LUgABeEEE/DK-Line-following-car/README.md

# DK 循迹小车

> 一台自己搭的循迹小车：STM32F103C8T6 + FreeRTOS + TB6612 + 8 路灰度，
> 串级双环（循迹 PD 外环 + 编码器速度 PID 内环），能跑弧线、直角、锐角，支持一圈自动停车。

**目录**

| | | |
|---|---|---|
| [1. 硬件构成](#1-硬件构成) | [2. 软件架构](#2-软件架构) | [3. 引脚映射](#3-引脚映射) |
| [4. 编译与烧录](#4-编译与烧录) | [5. 调试与标定流程](#5-调试与标定流程务必按顺序) | [6. N20 实测标定](#6-n20-实测标定结果6-v-额定--74-v-电池--自带编码器) |
| [7. 已知问题 / TODO](#7-已知问题--todo) | [8. 目录速查](#8-目录速查) | [分支说明](#分支说明) |
| [许可证](#许可证) | [**上手指南**](docs/上手.md) | |




> 🔧 **第一次上手？** 直接看 [**上手指南**](docs/上手.md) —— 装工具链、编译、烧录、连串口认版本、三步自检、跑一圈，30 分钟走完。

---

## 1. 硬件构成

| 项目 | 型号 / 规格 | 说明 |
|---|---|---|
| 主控 | STM32F103C8T6 | 72 MHz，64 KB Flash / 20 KB RAM，HSE 8 MHz |
| 底板 | 小车控制底板 V1.0（嘉立创 EDA） | 原理图见 [`docs/小车控制底板V1.0-原理图.pdf`](docs/小车控制底板V1.0-原理图.pdf) |
| 电机驱动 | TB6612FNG 双路 H 桥模块 | 底板 `M-INPUT` 7P 接口直插 |
| 电机 | N20 减速电机（**6 V 额定**）+ 霍尔编码器 | 实测轮径 48 mm、约 1300 计数/轮转（PSC=0）；2S 7.4 V 供电，占空比 100 % ≈ 7.4 V（超压 23 %），见第 6 节 |
| 循迹传感器 | 8 路灰度，I2C 地址 `0x5D` | 实测探头中心间距 11.5 mm（8 路总跨距 80.5 mm），I2C1 400 kHz |
| 显示 | 0.96" OLED（SSD1306，128×64） | I2C2，400 kHz |
| 无线 | **JDY-31**（经典蓝牙 3.0 SPP）或 HC-05 | USART2，9600 8N1；6 针底板：STATE/RXD/TXD/GND/VCC/EN(空)，底板 3.6~6V 供电 |
| 姿态 | MPU6050 六轴 | I2C2，与 OLED 共总线；**AD0 接 VCC → 7 位地址 0x69**（驱动自动探测 0x68/0x69），X 朝前、Z 竖直 |
| 电源 | 2S 7.4 V 锂电 + 2S 保护板 | DCDC 7.4→5 V（LMR14030）→ LDO 5→3.3 V（TLV75733） |

> ⚠️ **USB 供电时禁止接电机**：Q1 体二极管会把 VBAT 反灌到 5 V 轨，可能损坏 USB 口/电脑。调试逻辑先拔电机。

> **蓝牙模块（2026-10-27 换新 HC-05，资料见 `HC-05.zip`）**
>
> - 模块供电 **3.3 V**（规格书 3.0~3.6 V）。底板蓝牙接口出的是 **+5 V**：
>   带 LDO 的转接板能直接用；裸模块必须接 3.3 V，**别直接上 5 V**；
> - AT 模式：**上电、未配对时就是 AT 模式（9600）**；若上电瞬间 KEY 为高则固定 38400。
>   所以固件可以在上电时直接配参数，不用手动按 KEY；
> - 固件上电自动握手 9600/38400，成功后配置：**从机 + 广播名 `LFCar` + 配对码 `1234`**
>   （`BLE_AutoConfig()`，`Ble.h` 的 `BLE_AUTOCONFIG_ON_BOOT` 可关）；
> - `AT+UART` 改波特率后**必须重新上电**才生效，固件不动它。
>
> **JDY-31（经典 SPP，构建 `aq` 起）**
>
> - 未连接时就是 AT 模式，命令以 `\r\n` 结尾：`AT+VERSION` / `AT+NAME<名>` /
>   `AT+PIN<4位>` / `AT+BAUD<4..9>` / `AT+ENLOG<0|1>` / `AT+RESET` / `AT+DISC`；
> - 出厂：9600、名 JDY-31-SPP、PIN 1234；底板 EN 引脚为空，STATE 在连接后为高；
> - 固件上电自动识别 JDY-31/HC-05（`AT+VERSION` 含 JDY-31 即判定），
>   识别为 JDY-31 时自动设置 `AT+NAMELFCar`、`AT+PIN1234`、`AT+ENLOG0`；
> - 它是**经典蓝牙 SPP**，电脑端要用 RFCOMM 配对（PIN 1234），不能用 BLE GATT。

---

## 2. 软件架构

```
Core/            CubeMX 生成（时钟、GPIO、I2C、TIM、UART、USB；I2C1 400 kHz + DMA 收）
Drivers/BSD/     板级驱动（手写）
  PWM.c          TB6612 方向 + PWM（含每轮方向系数）
  Encoder.c      正交编码器测速（20 ms 窗口 + 一阶低通 + 分轮修正）
  SpeedPID.c     内环：前馈 + PID（cm/s → 占空比）
  Gray.c         8 路灰度读取、加权质心位置解算、场景识别
  LinePD.c       外环：循迹 PD + 直角/分叉/全黑处理 + 丢线搜索
  Led/Key/Ble/Oled.c  外设驱动
USER/            FreeRTOS 任务层
  Control_task.c 实时控制任务（优先级 3）：20 ms 内环 / 40 ms 外环 / 20 ms HMI，含目标速度斜坡
  Ble_task.c     蓝牙任务（优先级 2）：急停命令 + 灰度/PID 遥测
  Oled_task.c    OLED 显示任务（优先级 1）：状态页与按键调参
FreeRTOS/       内核（Cortex-M3 端口，heap_4）
```

控制链路：

```
灰度场景+位置 ──► 外环 PD(40 ms) ──目标速度 cm/s──► 内环速度 PID(20 ms) ──占空比──► TB6612 ──► N20
   ▲                                                                                    │
   └────────────────────── 编码器测速 ◄────────────────────────────────────────────────┘
```

设计要点：

- 内环带**前馈** `duty = KFF × v_target`，PID 只修小偏差；没有前馈时直道输出全靠积分攒，必然饱和、一转弯就失控。
- 内环在**目标速度符号翻转**的那一拍清零积分。否则前进时攒下的正积分会把反转指令抵消掉，
  "原地右转"实际变成"左轮前进、右轮不动"，车只会平移；实车日志里 B 轮
  被要求 -24 cm/s 时实际只有 -3 cm/s，根源就是积分还背着 +22。
- 外环**刻意不含积分**：线本身就是绝对位置基准，不存在需要积分消除的静差。
- 外环周期必须是内环的 2 倍以上（现为 40 ms vs 20 ms），`LinePD_Update()` 内部会检查周期比，不满足直接拒绝运行。

已实现的赛道能力：

- **场景识别与防抖**（`Gray.c`）：正常单线 / 横向线或终点（全黑）/ 左直角 / 右直角 / 分叉 / 丢线，输出防抖后的 `scene` 供外环切换策略；直角与锐角的判断冲突处理见 2.1。
- **丢线搜索**（`LinePD.c`）：锁存最后偏离方向，超时（1.2 s）后双向扫描找回，搜索速度 24 cm/s。
- **目标速度斜坡**：内环 40 cm/s²、外环 50 cm/s²，避免起步时两轮不同步造成原地打转。
- **分轮标定**：`ENCODER_A_FIX / B_FIX` 修正两轮计数差异（解决直行跑偏），支持运行时调。
- **蓝牙遥测**：`X/S/Q` 急停、`I` 扫 I2C 总线，周期输出灰度 8 路模拟值/阈值与内环 PID 三列。

### 2.1 直角 / 锐角判断冲突是怎么解决的

8 路灰度只有"某一帧的通道分布"这一种信息，而 SIDE（半侧宽黑带）和
FORK（两簇）**不是互斥的物理类别**：车走到锐角弯顶点附近时，同一条黑线会
先被探头切成两段（FORK），再随车头前压并成一片（SIDE），偶尔还会全亮（ALL）。
如果逐帧直接分类，`scene` 就会在 SIDE 和 FORK 之间来回跳 ——
表现为"一会儿按直角处理、一会儿按锐角处理"，转向和搜索方向跟着乱翻。

现在分三层处理：

1. **传感器层（`Gray.c`）**
   - 相邻簇间隔 ≤ 1 路时合并成一簇：一条线中间偶尔断一路，不再被误判成分叉。
   - 两级时间防抖：先确认"场景族"（丢线 / 单线 / 角点），再确认角点内部的子类型。
     族确认 2 帧（40 ms）、角点→单线释放 3 帧（60 ms）、丢线立即生效。
     关键点：**角点的进入只看"是不是角点"**，所以 SIDE / FORK 交替出现时
     也能在 2 帧内确认进入；而子类型要连续 3 帧相同才更新，
     交替抖动时 `sc` 保持不变。
2. **决策层（`LinePD.c`）**
   - SIDE 和 FORK 统一成**角点事件**：事件一旦成立就锁存方向
     （SIDE 用"哪半边全黑"，FORK 用"另一条腿在哪一侧"），
     之后无论分类怎么变都不重算；连续 3 拍（120 ms）回到单线才释放。
   - 方向证据**分级**：SIDE 是最直接的观测（哪半边全黑 = 往哪边转），
     可以纠正之前由 FORK 得到的方向；反过来不行。
     实车日志里出现过 `SIDE_L` 却锁存 `cd=-1` 的情况（先来了一帧 FORK 把方向占住），
     导致丢线后往反方向搜索 4~6 秒，就是靠这条规则修掉的。
   - **出弯方向记忆**：角点事件释放后 `corner_dir` 不立刻清空，再保留 15 拍（600 ms）。
     实车锐角弯常见时序是「SIDE/FORK → 短暂 LINE → 立刻丢线」，
     如果方向在丢线前就被清掉，搜索只能退回默认方向盲扫。
   - **锐角弯"定角转弯"**：如果角点事件里出现过锐角证据（FORK 双簇 / ALL 全黑），
     丢线后先闭眼朝锁存方向**转到目标角度**（`LINE_ACUTE_TURN_DEG`，默认 115°），
     这段时间看到线也不认。原因：V 形顶点处探头扫过"刚走过的那条腿"只有几十毫秒，
     按 2 拍确认就会误判"找回来了"，然后顺着旧线往回跑。
   - **角度从哪来**：没有陀螺仪，用两个编码器做差分里程计
     `yaw += (v_right − v_left) / 轮距 × dt`（dt 用 `HAL_GetTick` 的真实间隔）。
     纯原地转时约 172°/s，115° 约 0.67 s。打滑时轮子转得比车身多，编码器算出的角度会偏大、物理转角偏小，所以另设
     `LINE_ACUTE_COMMIT_TIMEOUT_MS`（1.5 s）兜底，不会无限转。
     等 MPU6050 到货，只需把 `yaw` 的来源换成陀螺仪 Z 轴积分，上层逻辑不变。
   - **直角弯（90°）单独处理**：拱形/方形赛道的两个底角是 90°，
     和 V 形锐角需要的转角不一样。判据是"纯 SIDE 事件 + 丢线时最后的有效位置
     已经贴到探头边缘（`|last_valid| ≥ LINE_RIGHT_ANGLE_MIN_ERR_CM`，1.2cm）"，
     也就是"线从侧面滑出去"。满足时按 `LINE_RIGHT_ANGLE_TURN_DEG`（90°）转；
     事件里出现过 FORK/ALL 的仍按 `LINE_ACUTE_TURN_DEG` 转。
     `simple` 分支面向弧线/直角赛道，把 `LINE_ACUTE_TURN_DEG` 也降到了 95°，
     保证直角不会被当成 115° 的 V 弯转过头；V 形赛道请用 `main`（115°）。
   - **弧线流畅度：线角前馈 + 位置低通**（构建 `ai` 起）：
     - 线角前馈：θ = Δ位置 / Δ里程（编码器里程），`steer_ff = 1.6 × v × θ`，
       弧线上线是斜着压过探头的，θ 先变，车在误差变大前就开始转——本质是
       纯追踪的轻量版（用切线角代替前视点）；
     - 位置低通：8 路量化步长 0.7cm，50cm/s 时误差是阶梯状，先生一阶低通
       （`LINE_POS_LPF_ALPHA`，默认 0.5）再进 PD，压掉阶梯引起的高频摆动；
     - 两项都有独立宏（`LINE_THETA_FF_GAIN` / `LINE_THETA_LPF` / `LINE_POS_LPF_ALPHA`），
       可以单独关掉对比。
   - **惯导（MPU6050，构建 `ak` 起）**：I2C2 与 OLED 共总线，X 朝前、Z 竖直。
     - **yaw 阻尼**：`steer -= 0.12 × ω_yaw`（限幅 ±8cm/s），压过弯后半段/出弯的摆动；
     - **陀螺航向**：偏航角积分改用陀螺（打滑不影响），没模块时自动退回编码器差分；
     - **定角转弯**：承诺转向的目标角（直角 90°/锐角 95°）由陀螺计量，转够即停；
     - 每次开跑把航向清零；遥测：启动打印 `[IMU]`，每 2s 一条 `[I] y.. g.. b.. f..`。
   - **搜索方向只信锁存方向**：不再用实测位置去"纠正"它。
     车转过头之后实测位置会指回旧腿，按它修正等于主动把车送回走过的赛道
     （日志 17:36:54：`cd=+1`，丢线后却向右搜）。
   - 角点事件期间放宽差速限幅（×1.35）；遇到 ALL（全黑，质心必然落在正中）
     时改用锁存方向满舵，避免"直直地冲出弯心"。
3. **搜索层（`LinePD.c`）**
   - 角点里丢线时，搜索方向直接用锁存方向，而不是被过冲污染的"最后位置"。

**怎么验证**：看串口 `[L]` 行新增的两列 ——
`sr` 是**未防抖**的瞬时场景，`sc` 是防抖后的稳定场景，`cs` 表示是否处于角点事件。
锐角弯里 `sr` 应该在 3/4/5 之间乱跳，而 `sc` 稳定、`cs` 进弯置 1、出弯后回 0。
如果 `sc` 仍跟着 `sr` 跳，把 `Gray.h` 里的 `GRAY_SCENE_*_SAMPLES` 调大。

**调参入口**（`LinePD.h`）：`LINE_CORNER_DIFF_BOOST`（角点差速倍数）、
`LINE_CORNER_RELEASE_CYCLES`（出弯确认拍数）、`LINE_ALL_AS_CORNER`（全黑满舵开关）。

---

## 3. 引脚映射

| 功能 | 信号 | 引脚 | 备注 |
|---|---|---|---|
| 电机 A | PWMA | PA9 | TIM1_CH2，10 kHz |
| 电机 A | AIN1 / AIN2 | PB13 / PB12 | 方向，`IN1=IN2` 为刹车 |
| 电机 B | PWMB | PA8 | TIM1_CH1，10 kHz |
| 电机 B | BIN1 / BIN2 | PB14 / PB15 | 方向 |
| 驱动使能 | STBY | PA10 | 高电平工作，必须拉高 |
| 编码器 E1 | E1A / E1B | PB6 / PB7 | TIM4 编码器模式（TI12） |
| 编码器 E2 | E2A / E2B | PA6 / PA7 | TIM3 编码器模式（TI12） |
| 灰度 | GS_SCL / GS_SDA | PB8 / PB9 | I2C1，100 kHz，地址 0x5D |
| OLED | OLED_SCL / OLED_SDA | PB10 / PB11 | I2C2，400 kHz |
| 蓝牙 | BLE_TX / BLE_RX | PA2 / PA3 | USART2，9600 |
| 蓝牙 | BLE_EN / BLE_STATE | PB3 / PA1 | EN 拉低 = 透传模式 |
| 按键 | KEY1 / KEY2 / KEY3 | PB0 / PA4 / PA5 | 上拉输入，低有效 |
| LED | LED1 / LED2 | PB5 / PB4 | 低电平点亮 |
| 蜂鸣器 | BUZZ | PB1 | |
| 调试 | SWDIO / SWCLK | PA13 / PA14 | SWD 下载 |
| 预留 | ADC | PA0 | ADC1_IN0，当前未使用 |

PWM 参数：TIM1 `PSC=71, ARR=99` → 72 MHz / 72 / 100 = **10 kHz**。
改 ARR 必须同步改 `PWM.h` 的 `MOTOR_PWM_PERIOD`。

---

## 4. 编译与烧录

依赖：CMake ≥ 3.22、Ninja、`arm-none-eabi-gcc`（建议用 CLion 自带 toolchain 或 xPack 发行版），
且 `arm-none-eabi-gcc` 必须在 `PATH` 里（`cmake/gcc-arm-none-eabi.cmake` 只按前缀找编译器，不写死路径）。
STM32CubeCLT 用户可临时 `export PATH=$HOME/st/stm32cubeclt_1.21.0/bin:$PATH`。

**烧录用 Release**（体积最小，`-Os`）：

```bash
cmake --preset Release
cmake --build --preset Release
# 产物：build/Release/linefllowing_car.elf —— 用 ST-Link / DAP-Link 经 SWD 烧录
# v1.2.x Release 实测：FLASH ≈ 54.5 KB (83 %)、RAM ≈ 16 KB (78 %) —— 余量已不足 10 KB
```

**需要单步调试时用 Debug**：

```bash
cmake --preset Debug
cmake --build --preset Debug
# Debug 比 Release 略大，Flash 余量更紧；接近上限时优先用 Release
```

> ⚠️ Debug 的优化级别已从 CubeMX 默认的 `-O0` 改为 `-Og`（见 `cmake/gcc-arm-none-eabi.cmake`）。
> 用 `-O0` 时镜像约 73 KB，**超出 64 KB Flash**，链接会报
> `region 'FLASH' overflowed by 7464 bytes`；`-Og` 可通过。
> 若调试时要完整观察某个函数里的局部变量，把该文件的优化关掉单独编即可。

> 本仓库不含 `build/` 产物，首次编译需自行 configure。

### 4.1 CI（GitHub Actions）

[`.github/workflows/build.yml`](.github/workflows/build.yml) 在每次推送 `main` / `simple`、任何 PR、
或手动触发时运行：

- **firmware (Debug / Release)**：`apt` 装 `gcc-arm-none-eabi` + `cmake` + `ninja`，
  按 `CMakePresets.json` 把两种构建都编一遍，额外产出 `.hex` / `.bin` 并打印 `arm-none-eabi-size`；
  产物以 `firmware-Debug` / `firmware-Release` 上传，保留 30 天
- **tools (python syntax)**：`python -m compileall tools`，避免遥测脚本语法错误推上去才发现

不装本地工具链也能拿到可烧录文件：Actions → 某次运行 → 页面底部 **Artifacts** → `firmware-Release`。

> 私有仓库的 Actions 会消耗额度（每次约 2 个 Linux 分钟 × 矩阵大小），
> 调参时频繁推送可以把 Debug 单独保留、Release 只在要比赛前跑。

---

### 4.2 发版（自动）

打 tag 就自动出 Release，不用再手搓附件：

```bash
git tag -a v1.0.1 -m "v1.0.1" && git push origin v1.0.1
```

工作流会编一遍 Debug + Release，然后把 `v1.0.1.hex` / `.bin` / `.elf` 和 `v1.0.1-debug.elf`
挂到 GitHub Release 上：

- 标题带固件构建标记（从 `USER/Src/Ble_task.c` 的 `BLE_BUILD_TAG` 读），烧错版本能一眼看出来；
- 说明里的**变更列表**自动取「上一个 tag..当前 tag」的提交，第一个 tag 时退化为最近 15 条；
- 同一个 tag 重复推（比如移动过 tag）不会失败，会覆盖附件和说明；
- 附件同时保留 Actions Artifacts 30 天，两者不冲突。

## 5. 调试与标定流程（务必按顺序）

**先用安全模式**：`USER/Inc/Control_task.h` 里 `CTRL_TASK_ENABLE_MOTION = 0`，控制任务每个周期把目标锁 0，车不会动。

### 5.1 三步硬件自检（`Core/Src/main.c` 的 USER CODE 2 段里逐个取消注释）

1. `Motor_TestSequence()` —— 正转缓升 / 滑行 / 反转 / 刹车 / 换 B 轮，确认接线与方向系数
2. `Encoder_TestSequence()` —— 手拨轮子看计数，确认 A/B 相与方向
3. `Speed_PID_TestSequence()` —— 阶跃响应，串口 **9600** 打印「目标 / 实测 / 输出」（USART2 接的是 HC-05，各头文件注释里写的 115200 是早期旧值）

其余可选项：`Gray_TestSequence()`、`Led_TestSequence()`、`Key_TestSequence()`、`BLE_Verify()`、`OLED_TestSequence()`。

### 5.2 上车前钉死符号

`LinePD_VerifySigns(&g_line_pd, &g_gray, &hi2c1, 0)` —— 逐个确认「误差为正 = 线偏左」「差速为正 = 左转」「正速度为前进」。这一步偷懒，后面调参全是玄学。

### 5.3 内环（先 KFF，再 P，再 I）

| 步骤 | 做法 | 判据 |
|---|---|---|
| 前馈 | Kp=Ki=Kd=0，只留 KFF | 实测速度接近目标；偏小就按 `目标/实测` 比例放大 KFF |
| 比例 | 加 Kp | 阶跃能快速跟上、超调 < 20 % |
| 积分 | 加 Ki | 稳态无静差，不振荡 |
| 微分 | Kd 一般保持 0 | 电机惯性和编码器滤波已提供阻尼 |

参数在 `SpeedPID.h` 的 `SPEED_PID_DFLT_*`，也可运行时按键/蓝牙改（`Speed_PID_SetGain()`）。

### 5.4 外环（循迹 PD）

`LinePD.h`：`KP=12.0`、`KD=1.2`、`BASE_SPEED=50 cm/s`（档位 1）、`LINE_DIFF_LIMIT=35`、`LINE_SPEED_LIMIT=75`、`LINE_CURVE_SLOW_MIN=0.40`，外环周期 **40 ms**。
先把基础速度降到 20 cm/s 调 Kp（能跟线不画龙），再加 Kd 抑制过冲；`LINE_CURVE_SLOW_MIN` 控制急弯减速深度。
`LINE_STOP_IF_LINE_LOST=1` 是首次调试的正确选择——丢线即停，车不会冲出赛道；调顺之后再开 `LINE_SEARCH_ENABLE`，让丢线后按锁存方向双向扫描找回。

### 5.5 自动采集遥测（给 AI / 脚本分析用）

HC-05 是 SPP 透传，PC 端不用装 `rfcomm` 也能直接连。仓库里带了一套纯标准库的小工具：

```bash
# 1) 先在 bluetoothctl 里 pair/trust 一次（PIN 默认 1234），不需要 rfcomm bind

# 2) 采集：直接连 RFCOMM，默认依次尝试通道 1~5
python3 tools/bt_serial_capture.py --mac AA:BB:CC:DD:EE:FF --duration 60

# 或者连已有的 tty（USB-TTL / 系统提供的 /dev/rfcomm0）
python3 tools/bt_serial_capture.py --port /dev/ttyUSB0 --baud 9600

# 3) 分析
python3 tools/serial_summary.py logs/serial_YYYYmmdd_HHMMSS.loop.csv
```

输出在 `logs/`（已 gitignore）：原始 `.log` + `loop/speed/gray/scene` 四个 CSV。
`serial_summary.py` 会直接给出 `sr`（瞬时场景）和 `sc`（防抖后场景）的变化次数对比、
角点事件次数/时长/锁存方向，用来验证 2.1 节的防抖是否生效。

> 遥测节拍：BLE 任务 25 ms、PID 输出 160 ms，`[L]` 实测约 5 Hz
> （受 9600 波特率限制，60 字节一行需要 62 ms）。
> 控制任务里的调试打印已经压到最短、且只在状态变化时发一次 ——
> 以前 `[LinePD] line lost, stop` 每 40 ms 打一次（27 字节要 28 ms），
> 会把控制周期吃掉一大半，还会被 20 ms 超时截断成 `[LinePD] line lost, s`。
详细用法和排错见 [`tools/README.md`](tools/README.md)。

### 5.6 跑圈结果打标（KEY1 = 失败，KEY2 = 成功）

循迹运行时，OLED 停在 **MODE** 页会显示 `K1 FAIL K2 OK`：

| 操作 | 效果 |
|---|---|
| **长按 KEY3** | 串口打印 `[T] OK #n t<ms>`，表示刚跑完的这段是**成功**的 |
| **短按 KEY1** | 串口打印 `[T] FAIL #n t<ms>`，表示这段**失败**了 |
| **长按 KEY2** | 急停（**不会**打标） |
| 短按 KEY2 | 循迹中不再打标（原方案，已弃用） |
| KEY1/KEY2 | 在其他页面仍是原来的调参功能 |

> ⚠️ 为什么从"短按 KEY2"改成"长按 KEY3"：停车本身就要长按 KEY2，
> 按下瞬间和一次短按在按键层是同一个事件，很容易在停车时误打一个 `[T] OK`。
> 成功标挪到长按 KEY3（约 1 s）后，和停车完全解耦。
>
> 长按 KEY3 在循迹模式下**随时可用**：按下瞬间 KEY3 会先按正常逻辑切页，
> 长按触发时打标，然后由控制任务把页面退回 MODE 页（`OledTask_SetModePage`），
> 所以不会因为打标而停在别的页面。短按 KEY3 仍然是正常切页。

设计要点：

- **模式在循迹运行中锁定**：以前在 MODE 页按 KEY1/KEY2 会直接把模式切走（车还在跑时
  一不小心就切到 SPD/STOP），现在锁定；要退出循迹先长按 KEY2 停车。
- **只在松手时判定短按**：长按 KEY2 是急停，不能同时冒出一个假的 `OK`。
- **按下瞬间的状态决定要不要打标**：从 STOP/SPD 切进循迹的那一次按键不会误打标
  （否则一进循迹就凭空出现一个 `[T] OK`）。
- **打印统一在蓝牙任务里做**：控制任务只把 1/0 塞进队列，避免两条任务抢同一个串口
  把正在发送的 `[L]` 行截断。

标记的含义是"**这一段跑完了**"：一段数据 = 上一个标记之后到本标记之前。
分析脚本按 `[T]` 行切段：

```bash
python3 tools/tag_report.py logs/serial_20261026_*.log
# [FAIL #1] 10:00:00~10:00:09  9.0s  n=9  角点 0 丢线 0 ...
# [OK   #2] 10:00:09~10:00:19 10.0s  n=10 角点 1 丢线 3 ...
```

输出每段的时长、模式分布、场景分布、角点事件数、丢线样本数、`|e|` 中位和里程增量，
成功/失败一目了然；加 `--csv` 还能导出分段表。

### 5.7 简单赛道速度规划（`simple` 分支）

单独开了 `simple` 分支，针对**只有弧线和直角**的简单赛道做速度与稳定性优化；
锐角/复杂赛道仍然用 `main`（构建 `s`，承诺转向 115°），本分支当前构建 `bk`。

思路参考了这些公开实现：

- [felipemmattia/PID_line_follower_robot](https://github.com/felipemmattia/PID_line_follower_robot)：
  误差超过阈值判定入弯，按误差成比例降速，并给转弯分档的低速下限；
- [Sndcooper/adaptive-line-follower](https://github.com/Sndcooper/adaptive-line-follower)：
  "curve boost" —— 转弯时先轻后重，线还没找回就逐步加力，兼顾入弯稳定和出弯果断；
- [deepjyoti-io/Adaptive-PID-line-follower](https://github.com/deepjyoti-io/Adaptive-PID-line-follower)：
  8 路模拟量 + 动态速度缩放 + 丢线恢复；
- 以及"adaptive speed control for line-following robots"这类专利/论文的共同做法：
  速度是"偏离量 / 曲率"的函数，而不是常数。

本分支实际实现（`Drivers/BSD/Src/LinePD.c` 第 6 步）：

```text
曲率深度 depth = 0.60 · |error|/误差上限 + 0.40 · |steer|/差速上限
                 再用 |d(error)/dt| 做入弯预判（取两者较大值）
速度系数   = 1 − depth · (1 − LINE_CURVE_SLOW_MIN)       // 0.40 为最慢
角点事件   → 速度系数再压到 ≤ LINE_CORNER_SLOW_MAX（默认档 0.62）
直道加速   → 连续 5 拍 |error|<0.35cm 且 |steer|<8cm/s，每拍 +3%，最高 +25%
斜坡       → 加速 50 cm/s²，减速 100 cm/s²（进弯果断、出弯平缓）
```

### 5.7.1 赛道档位：换赛道只改一个宏

不同「简单赛道」的弯半径和直道长度差别很大，同一套速度参数往往一条太保守、另一条又冒进。
所以速度规划整体做了 3 档，改 `LINE_SIMPLE_PROFILE`（`Drivers/BSD/Inc/LinePD.h`）即可切换：

| 档位 | 适用场景 | 基础速度 | 直道加速 | 角点限速 | 入弯预判 | 减速斜坡 |
|---|---|---|---|---|---|---|
| `0` 保守 | 弯多直道短 / 新场地第一次跑 | 40 cm/s | +15 % → 46 | 0.70 | 0.80 | 2.5× |
| `1` 均衡（默认） | 大多数「弧线 + 直角」赛道 | 50 cm/s | +25 % → 62 | 0.62 | 0.70 | 2.0× |
| `2` 激进 | 直道占比高、弯缓、抓地好 | 55 cm/s | +35 % → 74 | 0.62 | 0.60 | 1.6× |

- 档位**只改速度规划**，不动 `KP` / `KD` / 差速限幅 —— 切档改的是过弯快慢，不是过弯轨迹；
- 换档后先跑一圈确认整圈不丢线，再谈圈速；
- 烧录后连蓝牙看 `[VER] ... P1`，末尾的 `P?` 就是当前档位（`bj` 之后的固件都带）；
- ⚠️ **电机天花板约 57 cm/s**（实测打满占空比的位置）。直道加速加满后 `1` 档 62、`2` 档 74，
  都超过这个值 —— 加到顶时 PID 会进入饱和（有抗饱和保护，不会失控，只是跑不到目标速度）。
  `2` 档只要连续 4 拍居中就开始加，比 `1` 档（5 拍）更容易顶到饱和；
  若发现进弯前刹不住，先把该档的 `LINE_STRAIGHT_BOOST_MAX` 降到 0.20。
- `LBAS` 的按键调节范围是 0~55 cm/s（`Oled_task.c` 的调参表），三档的默认值都在这个范围内。

### 5.7.2 与档位无关的形态参数

| 宏 | 默认 | 作用 |
|---|---|---|
| `LINE_DEPTH_W_STEER` | 0.40 | 差速需求在曲率深度里的权重（越大越早减速） |
| `LINE_STRAIGHT_EPS_CM` / `LINE_STRAIGHT_STEER_CM` | 0.35 / 8.0 | 判定「直道」的门槛 |
| `LINE_SPEED_RAMP_CMS_PER_SEC` | 50 | 加速斜坡（减速为其 `LINE_DOWN_RAMP_MULT` 倍） |
| `LINE_SPEED_LIMIT` | 75 | 目标速度绝对上限 |

注意：

- 速度上限仍是 `LINE_SPEED_LIMIT`（75 cm/s），实际能跑多快受内环和电机限制 ——
  实测 B 轮在 57 cm/s 时已经打满占空比，新场地建议 `LBAS` 先按 40 试、跑顺了再加到 50；
- 直道加速只在"误差和转向都很小"时生效，进弯会立刻收回，不会把速度带进弯里；
- 直角弯靠"角点事件限速 + 差速放宽 1.35 倍"通过，不额外做定角转弯
  （定角转弯是锐角用的，简单赛道用不到）。

### 5.8 比赛自动停车（`simple` 分支，构建 `w`）

规则要求跑完一圈停在启停线，测试点偏差 d≤2cm 才能拿满停车倍率 P=1.0。
这一节把自动停车接到 `LinePD` 里。

**几何关系（实测）**：

```text
灰度条中心 ──17cm──> 后轮轴中点（= 指定的"测试点"）
两轮中心距 16cm（= LINE_TRACK_WIDTH_CM）
起跑时：把后轮轴中点对准起跑线
```

**流程**：

```text
进入循迹 → 记录里程基准
跑过半圈（50%）→ 武装
灰度条瞬间全黑 1~3 拍（启停线 5cm 横线）→ 判定到位点
限速 12cm/s，再直行 17cm（灰度条 → 测试点的距离）
到点前 2cm 硬刹 → 切 STOP + 清积分 + 制动，串口打印 [RACE] stop
兜底：如果没识别到启停线，里程到"周长−2cm"也停
```

**LAP 参数（OLED）**：

| LAP 值 | 含义 |
|---|---|
| `0` | 关闭自动停车（纯练习，用长按 KEY3 打标） |
| `10`（1~49） | **自适应模式**（默认，从 0 按一下就是 10）：不需要知道周长，只靠启停线识别 |
| `≥50cm` | 周长模式：识别为主，里程兜底（适合固定地图） |

自适应模式的做法：

- 起跑后先跑过 **120cm** 才武装（避开起跑线附近的杂线）；
- 启停线判据更严：全黑脉冲 **1~3 拍**、横向误差 <1.2cm，而且**角点事件没有方向证据**
  （真正的角点一定有 SIDE/FORK 方向，启停线只是一条横线、没有方向）；
- 防备跑飞：识别不到时跑到 **2000cm** 强制停车。

**怎么用**：

1. 把后轮轴中点（两轮中间那个点）对准起跑线放车；
2. OLED 翻到 `LAP`：默认 1（自适应）就能用；知道周长就填周长（如 514），练习时填 0；
3. 按 KEY2 进 LINE 模式；
4. 跑完一圈车会自己停在启停线，不用手按。

**可调参数**（`Drivers/BSD/Inc/LinePD.h`）：

| 宏 | 默认 | 说明 |
|---|---|---|
| `LINE_RACE_STOP_OFFSET_CM` | 17.0 | 灰度条中心 → 测试点；如果总是停在线前 Xcm，就减 X |
| `LINE_RACE_APPROACH_CMS` | 12.0 | 识别后接近速度；调低更准、调高更快 |
| `LINE_RACE_DETECT_CHANNELS` | 6 | 8 路里至少几路全黑；误触发就加到 7 |
| `LINE_RACE_PULSE_MAX` | 3 | 全黑持续超过几拍算角点（不算启停线） |
| `LINE_RACE_ARM_FRAC` | 0.50 | 跑过半圈才允许识别 |
| `LINE_RACE_BRAKE_MARGIN_CM` | 2.0 | 到点前多少厘米硬刹；停过线就加、停早了就减 |
| `LINE_RACE_FALLBACK_CM` | 2.0 | 里程兜底（仅周长模式） |
| `LINE_RACE_ARM_MIN_CM` | 120 | 自适应模式的武装距离 |
| `LINE_RACE_MAX_CM` | 2000 | 自适应模式的安全上限 |

> 第一次跑先看停下来的实际 d：如果车停在线前 3cm，把 `LINE_RACE_STOP_OFFSET_CM`
> 减 3；停过线 2cm 就加 2。调整后建议直接测 3 次取平均。

---

## 6. N20 实测标定结果（6 V 额定 / 7.4 V 电池 / 自带编码器）

### 6.1 电压：占空比等于平均电压

TB6612 输出的是 PWM 平均电压 = 占空比 × VBAT：

| 占空比 | 平均电压 | 含义 |
|---|---|---|
| 81 % | 6.0 V | 正好等于电机额定 |
| 100 % | 7.4 V | 超压约 23 % |

竞速单次只跑几十秒，用满 100 % 能多拿约 1/4 转速，通常不用怕；训练时若发现电机发烫、换向火花明显，把 `PWM.h` 的 `MOTOR_DUTY_MAX` 改成 **81** 让软件限压。
电流方面 TB6612 单路 1.2 A 连续 / 3.2 A 峰值，N20 堵转 0.8~1.5 A（7.4 V 下更高），够用，但别长时间堵转。

### 6.2 机械参数（已按实车标定）

| 宏 | 值 | 依据 |
|---|---|---|
| `ENCODER_PPR` | 13 | 电机铭牌线数 |
| `ENCODER_EDGE_MULTIPLIER` | 4.0 | TIM 工作在 TI12 编码器模式，硬件本来就是四倍频 |
| `ENCODER_GEAR_RATIO` | 25.0 | 名义值：由 PSC=49 时代的 26 计数/轮转 × 50 反推 1300 / (13×4) |
| `ENCODER_WHEEL_DIAMETER_MM` | 48.0 | 卡尺实测 |
| `ENCODER_CALIBRATION` | 0.97 | 两次 100 cm 标定取平均（直线 0.943 / 循迹 1.002）；PSC 归零后比例不变，无需重标 |
| `ENCODER_A_FIX` / `B_FIX` | 0.995 / 1.0 | 长直道反复微调到走直 |

折算：**每轮转 ≈ 1300 计数、约 0.1125 mm/计数**（PSC=0）。

> ⚠️ `GEAR_RATIO = 25` 只是让「13 × 4 × 25 = 1300」这个乘积成立的**名义值**，真实减速箱大概率在 1:25~1:30 之间，5~10 % 的差由 `ENCODER_CALIBRATION` 吸收。它不影响循迹（循迹靠灰度位置），只影响速度读数的绝对准确度。

### 6.3 编码器预分频：49 → 0（已改，需实车复核）

编码器模式下 `PSC` 是对**编码器边沿**分频的，不是对 72 MHz 内部时钟分频。之前两路都是 49，等于每 50 个边沿才计 1 个数——两路一致（不会左右不对称），但分辨率白扔了 50 倍：

| | PSC = 49（旧） | PSC = 0（现） |
|---|---|---|
| 计数/轮转 | ~27 | **~1300** |
| mm/计数 | 5.63 | **0.1125** |
| 20 ms 窗口下 1 个计数 | ≈ 28 cm/s | ≈ 0.56 cm/s |
| 30 cm/s 时每 20 ms 计数 | ~1 | **~53** |

改法：`main.c` 的 `MX_TIM3_Init/MX_TIM4_Init` 与 `.ioc` 的 `TIM3/TIM4.Prescaler` 一起改成 0（已同步改好），换算侧把 `EDGE_MULTIPLIER` 恢复成 4、`GEAR_RATIO` 设为 25。

**烧录后请按这个顺序复核**（底座架空，车不动）：

1. 手转车轮**正好一圈**，看原始计数增量是不是 **~1300**（原来是 ~26）。
   - 只有 ~650 → A/B 相有一路没接进来，检查编码器线序；
   - 还是 ~26 → PSC 没真正写进去，检查 `.ioc` 是否被 CubeMX 覆盖回去。
2. 跑 100 cm 直行，看里程增量是不是 **~8900**（对应 0.1125 mm/计数）。
   - 偏差在 ±5 % 内属正常（轮径公差 + 编码器加工误差），需要更准就按 6.4 节微调 `CALIBRATION`。
3. 速度读数应当与改动前**基本一致**（同一目标值跑出来的 cm/s 数值不该差 50 倍）——如果差了一个数量级，说明换算没跟上，立刻停车检查。

### 6.4 换轮子 / 换电机后怎么重标

跑一段已知距离 `L`，记录里程增量 `Delta`：

```
ENCODER_CALIBRATION_new = ENCODER_CALIBRATION_old × L / Delta
```

分轮跑偏仍用 `ENCODER_A_FIX / B_FIX` 微调（每次 0.005 量级）：车往左偏 → 减小 `A_FIX`。

### 6.5 长时间运行的计数 / 内存审计

"跑久了开始抖"这类问题，先排除计数回绕和内存耗尽。逐项核对结果：

| 量 | 类型 | 实际上限 | 结论 |
|---|---|---|---|
| 编码器单拍增量 | `int16_t` | 20 ms 窗口内约 350 计数（200 cm/s），上限 32767 | 安全 |
| 累计里程 `s_distance_cm` | `float` | 1 km 处精度 0.008 cm、100 km 处 0.8 cm | 只影响显示 |
| 偏航角 `yaw_deg` | `float` | 5000° 处精度 0.0005°、10⁶° 处 0.06° | 单次转弯够用 |
| 内环积分 | `float` | 限幅 ±40（0.4 × 100） | 不会爆炸 |
| `search_ms` | `uint16_t` | 饱和在 65535 ms（65 s） | 安全（饱和后即停车） |
| `lost_count` / `corner_*` / `recover_count` | `uint8_t` | 全部有 `< 0xFF` 限幅 | 安全 |
| **`fail_count`（I2C 连续失败）** | 原 `uint8_t` | 无上限 → **连续失败 256 次回绕成 0** | ❌ 已修：`uint16_t` + 限幅 |
| `scene_flips` | `uint16_t` | 饱和（有保护） | 只影响统计 |
| `total_reads` / `total_fails` / `s_rx_total` | `uint32_t` | 50 Hz 下约 2.7 年；600 B/s 下约 79 天 | 安全 |
| 任务栈 | — | BLE 1280 B（帧链约 700 B）、Ctrl 1280 B（约 350 B）、OLED 1792 B（约 350 B） | 有余量，但原来溢出检测是关的 |
| 堆 | — | 10 KB，任务+信号量约 6 KB，剩约 4 KB | 够用 |

已修/已加：

1. **`fail_count` 位宽**：以前连续失败 256 次会回绕成 0，`fail_count >= GRAY_FAIL_LIMIT`
   又变 false —— 上层以为总线恢复了，继续拿陈旧数据开车。现在是 `uint16_t` 并限幅。
2. **打开 FreeRTOS 保护**：`configCHECK_FOR_STACK_OVERFLOW = 2`、
   `configUSE_MALLOC_FAILED_HOOK = 1`，并实现钩子（`USER/Src/app_hooks.c`）：
   - **LED1 常亮 + 车停住** = 栈溢出
   - **LED2 常亮 + 车停住** = 堆分配失败
   以前这两种情况是静默的内存破坏，表现就是"跑一会儿就抖/乱走"。
3. **新增运行期诊断行 `[M]`**（每 10 s 一行）：

   ```text
   [M] heap4120 stkC980 stkO1520 stkB760 i2c14/18000
   ```

   - `heap`：剩余堆字节。本工程运行期不再动态分配，**它应该是常数**；持续下降 = 泄漏；
   - `stkC/O/B`：三个任务栈的**历史最小剩余字节**（`uxTaskGetStackHighWaterMark`），
     低于 200 就该加大对应任务的 `*_STACK_WORDS`；
   - `i2c`：灰度传感器累计失败/总读取，长期错误率升高 = 接线/上拉问题。

---

## 6.5 发车流程与注意事项（比赛用，构建 `dj`）

> 这一节是 2026-10-30 实车调参收敛后总结的。**照做能跑，做错会抖/停不住。**

### 6.5.1 发车前必做四件事

| # | 事项 | 做错会怎样 |
|---|---|---|
| 1 | **车放正**：车身与赛道线夹角 < 5° | 起手震荡。PD 只看横向偏移、看不到"车与线夹角"，夹角大时 P 项要等偏移长大才动作，必然过冲。**这是发车人的职责，固件里不做补偿**（试过起步软限速/加长微分窗口，实车验证都更差，已撤销） |
| 2 | **后轮连接线中点对准起跑线** | 停车点整体偏移。`LINE_RACE_STOP_OFFSET_CM = 17cm` 是"灰度条中心→后轴中点"的实测值，对位错了这个值就不成立 |
| 3 | **LAP 设成实际周长**（OLED，步长 30cm） | 接近区不生效或识别窗口偏掉。设 310 约按 10 次；`[P]` 行确认 `lap310 arm248` |
| 4 | **电池电压别太低** | 同一套参数实测过 48.4 cm/s（满电）和 44.5 cm/s（低电）两个结果，占空比在 52%~77% 之间摆 |

### 6.5.1b 比赛配置（构建 `dn`）

| 项 | 比赛值 | 说明 |
|---|---|---|
| `BLE_PERIODIC_LOG_ENABLE` | **0**（静默） | 周期遥测全关，只保留 `[T]` 打标和 `[RACE]` 事件。省 FLASH 2.3KB + 串口带宽 |
| 蓝牙模块 | **可以拔掉** | PA3(RX) 已改上拉，拔掉后不会因悬空拾噪而误触发急停；PA1(STATE) 下拉读低=未连接 |
| `MARG`（刹车余量） | 现场用 OLED 调 | 走 `17 − MARG` 厘米后停车，步长 0.5，实时生效 |

**拔掉蓝牙模块后唯一的损失是串口日志**，控制律完全不依赖它（`SendTag`/`SendEvent` 都是 0 超时非阻塞）。

### 6.5.2 操作序列

```text
上电 -> 等 OLED 出现 PID TUNE 页
  -> 短按 KEY3 翻到 LAP，用 KEY1/KEY2 设周长（步长 30）
  -> 翻到 MODE 页
  -> 短按 KEY2 进 LINE（跳过 SPD，避免直冲出去）
  -> 车开始跑；OLED 在循迹期间【冻结不刷新】（省 I2C2 带宽给 MPU）
  -> 到启停线自动停车
  -> 长按 KEY2 是急停（任何时候都有效）
```

**打标**（跑圈结果统计）：循迹中 MODE 页短按 KEY1 = `[T] FAIL`、KEY2 = `[T] OK`。
注意：自动停车**不会**再伪造 `[T] OK`（`cw` 修了 `SendTask` 把 2/3 压成 1 的 bug）。

### 6.5.3 跑完看什么

```text
[L] 行关键字段：
  e/s     横向误差 / 转向指令（直线段 |s| 应 < 15）
  ra      已跑里程
  rz      1 = 已进入接近区（应在 LAP×0.8 附近变 1）
  rp      0 等待 / 1 巡航 / 2 已识别 / 3 到位
  bn      累计检测到的启停线脉冲数
  bp      压线瞬间的横向位置（真线 |bp| < 1.5cm）
  sn/rj   脉冲被 LinePD 看到的次数 / 被关卡拒掉的次数
```

**判读「识别到却不停」：**

| 现象 | 含义 | 处理 |
|---|---|---|
| `bn` 不涨 | 图案没匹配（脉冲宽度上限/阈值） | 看 `[G]` 的模拟值和阈值 |
| `bn` 涨、`sn` 不涨 | 脉冲标志没传到 LinePD | 固件问题，报给我 |
| `bn`/`sn` 都涨、`rj` 也涨 | 被关卡拒（里程窗口/位置/陀螺） | 看 `ra` 折回差和 `bp` |

### 6.5.4 停车位置调法

**唯一要调的参数是 `LINE_RACE_BRAKE_MARGIN_CM`（`LinePD.h`，当前 3.0cm）：**

```text
走 17 − margin 厘米后停车
  margin = 3.0 -> 走 14cm（离终点还差 3cm）
  停晚了（冲过终点）-> 加大（4.0 / 5.0）
  停早了（没到就停）-> 减小（2.0 / 1.0）
```

**每次调 1cm，跑 3 次取平均**——单次有 ±1cm 随机波动（刹车时刻落在 20ms 周期的哪一拍）。

### 6.5.5 换赛道后要重新确认的三件事

1. **LAP**：跑一圈看 `ra` 稳定在多少，那个值就是周长
2. **`LINE_RACE_DETECT_WINDOW_CM`（35cm）**：如果新赛道的启停线不在直线中段、而在弯道末端，识别窗口要够大才能容纳位置散布
3. **`LINE_RACE_ZONE_FRAC`（0.80）**：赛道很短时 20% 的距离可能不够减速，需要降到 0.7

---

## 7. 已知问题 / TODO

> 📋 **2026-10-30 全量代码巡检**（基线 `060533d` / 构建 `cv`）：
> 共查出 P1 4 项、P2 7 项、P3 11 项，含复现证据，见
> [`docs/代码巡检报告-2026-10-30.md`](docs/代码巡检报告-2026-10-30.md)。
>
> **修复状态：P1 全部 4 项、P2 全部 7 项、P3 中 7 项已修**（构建 `cw` ~ `db`）。
> 已修的关键项：
> - `BleTask_SendTag()` 把 2/3 压成 1（自动停车打标全错、伪造 `[T] OK`）
> - `BLE_STATE`(PA1) 被配成推挽输出（连接状态永远测不到，且与模块对顶）
> - 灰度 `fail_count` 从不自增（传感器掉线不会停车）
> - `Encoder_UpdateSpeed` 5ms 窗口 + 速度环 5ms 跑而 dt 常量是 20ms（车抖主因）
> - 控制环里直接 `HAL_UART_Transmit` / `HAL_Delay`（抢总线、卡节拍）
> - 三处 `HAL_UART_Transmit` 长度越界、`BleTask_Print` 截断越界读
> - 无用的 USB 初始化（省 728 B RAM，86.1% → 82.6%）
>
> 未修：`LAP` 步长 50 与"10=自适应"的手感问题（保留粗步长便于快速设周长）、
> `tools/` 下的文档串、`configENABLE_MPU/FPU/MVE` 等纯注释项。

- [ ] **矩形赛道待验证**（2026-10-30 收工时的下一步）：
      当前 `LKP 12 / LKD 0.6 / base 55 / θ-FF 0.70` 全部是在【弧线+直角混合】赛道上调的。
      纯矩形赛道（四个 90° 直角 + 长直道）有两个差异要重点看：
      1. 直角弯的 `sc=SIDE/ALL` 事件会更多，`LINE_CORNER_SLOW_MAX(0.68)` 可能太保守，
         直道冲刺的时间占比会比弧线赛道高
      2. 长直道上 `LINE_STRAIGHT_BOOST_MAX(0.30)` 会一直顶在 71.5cm/s，
         而电机实测 57cm/s 就打满占空比 —— 长直道会长时间饱和，
         进弯前可能刹不住。若出现"直角弯冲出去"，先把 `LINE_STRAIGHT_BOOST_MAX` 降到 0.20
- [ ] **等待实车复核（PSC 49→0 之后）**：手转一圈应为 ~1300 计数、跑 100 cm 应为 ~8900 计数，速度读数应与改动前基本一致；若只有 ~650 计数，说明 A/B 相缺一路。复核数据回来后可能需要微调 `ENCODER_GEAR_RATIO`。
- [ ] **内环 KFF 未单独标定**：仍是默认 1.0。
      2026-10-25 的实车日志（`logs/serial_20261025_172300.log`）给出反证：
      目标 15~35 cm/s 区间里，**占空比/实测速度** 是 A 轮 1.35、B 轮 1.87，
      即 30 cm/s 实际需要约 40 %（A）/ 56 %（B）占空比，而 KFF=1.0 只给 30 %，
      差值全靠积分慢慢补 —— 追不上快速变化的差速目标。
      表现为 `m` 长期比 `t` 低 2~7 cm/s，而且 B 轮输出经常打到 70~100 % 仍不达标。
      先按 5.3 节把 KFF 调到 1.4~1.6，再核对两轮 `d` 增量是否一致
      （差得多就查 B 轮机械阻力 / 用 ENCA 平衡）。
- [ ] **外环参数绑定当前赛道**：`KP=20 / KD=1.0 / base=30` 是在现有场地调的，换赛道或换电池电压后需要重调。
      同一份日志里，循迹段 `steer` 符号翻转占 58 %（几乎每拍反向）、`|steer|≥30` 占 14 %，
      `|e|` 中位 0.50 cm / p90 1.90 cm —— 典型画龙。
      建议先降到 `LBAS=20 / LKP=12 / LKD=2.5` 跑顺，再逐步加回来。
- [ ] **角点防抖参数待实车确认**：`GRAY_SCENE_*_SAMPLES`（2/3/3/1）和
      `LINE_CORNER_RELEASE_CYCLES`（3 拍）是按 20 ms 采样 + 40 ms 控制律估的。
      跑锐角弯时看 `[L]` 行的 `sr/sc/cs`：目标是 `sr` 乱跳而 `sc` 稳定；
      如果入弯偏晚（车已经压到弯心才识别），把 `GRAY_SCENE_CONFIRM_SAMPLES` 降到 1；
      如果出弯后还长时间保持角点态（`cs=1` 拖太久），把 `LINE_CORNER_RELEASE_CYCLES` 降到 2。
- [ ] **角点差速倍数未实车验证**：`LINE_CORNER_DIFF_BOOST = 1.35` 沿用原 SIDE 的经验值，
      锐角弯如果甩尾就降到 1.2，如果转不过来就升到 1.5。
- [x] **`LINE_ACUTE_TURN_DEG` 实车 A/B：115° 优于 140°**（2026-10-25 同一赛道）：
      | 版本 | 丢线段 | 平均找回 | 最长 | 反向 |
      |---|---|---|---|---|
      | q（115°） | 70 | 0.96 s | 2.79 s | 0 次 |
      | r（140°） | 13 | 1.62 s | 5.40 s | 0 次 |

      多转的 25° 会把出弯腿甩到车后，只能继续扫过头再反向扫回来，所以默认值退回 **115°**。
      注意这个角度是从**角点事件发生**开始算的（不是丢线时刻），事件触发时车还看得见线，
      到丢线已经转掉一部分 —— 所以 115° 换算到车身实际转角已经接近 V 弯外角。
- [ ] **继续微调 `LINE_ACUTE_TURN_DEG`**：看 `[PD] ok xxxms y±deg` 里的 y
      （本次承诺转向实际转过的角度）：
      反复出现"y 到了 115 还找不到线" -> 加到 125 / 130；
      出现"转过头、反向扫很久" -> 减到 110。
      打滑时轮子转得比车身多（编码器角度偏大、物理转角偏小），要往大调；
      换新轮胎/擦干净纸面之后可能又要往小调。
- [ ] **蓝牙只能急停 + 遥测**：无线改参数没做，调参仍靠按键 + OLED。

---

## 8. 目录速查

```
Core/             CubeMX 生成代码（main.c 里有全部自检入口）
Drivers/BSD/      手写板级驱动
  Inc/ PWM.h Encoder.h SpeedPID.h Gray.h LinePD.h Led.h Key.h Ble.h Oled.h OledFont.h
  Src/ 对应实现
USER/             FreeRTOS 任务
cmake/            gcc-arm-none-eabi 工具链文件 + CubeMX 子工程
docs/             原理图 + 代码巡检报告（代码巡检报告-2026-10-30.md）
tools/            HC-05 遥测采集/解析/统计脚本（见 tools/README.md）
linefllowing_car.ioc   CubeMX 工程（改外设从这里进）
```

> 注：工程名与目录沿用 CubeMX 生成时的 `linefllowing` 拼写，重命名会牵动 CMake、启动文件与 `.ioc`，比赛前不建议动。

---

## 分支说明

| 分支 | 定位 | 固件构建标记 |
|---|---|---|
| `main` | 早期主线：锐角承诺转向 140°、Kp=20、基础速度 30 cm/s，无 IMU | `s` |
| `simple` | 当前主力：锐角 95°、Kp=12、基础速度 50 cm/s，新增 MPU6050、<br>JDY-31、一圈自动停、三档速度 profile | `dn` |

`simple` 从 `main` 长出来，包含 `main` 的全部提交；`main` 停在 2026-10-26。
两个分支的锐角取舍（140° / 95°）是不同赛道性格的选择，不是单纯的新旧。

固件版本看 `[VER]` 行：`... 2025-10-30dn P1` → 构建 `dn`、当前档位 `P1`。
发版走 tag（`v*`），CI 会自动编译并把 hex/bin/elf 挂到 Release。

---

## 许可证

[MIT](LICENSE) © 2026 LUgABeEEE

第三方代码归属：`Drivers/STM32F1xx_HAL_Driver/` 与 `Drivers/CMSIS/` 为 STMicroelectronics /
Arm 提供，`FreeRTOS/` 为 Amazon Web Services 提供，各自保留原有许可证（见对应目录内的
LICENSE / 文件头）。
