LUgABeEEE/DK-Line-following-car/docs/小车控制底板V1.0-原理图.pdf

# SWD下载调试电路

## 晶振电路

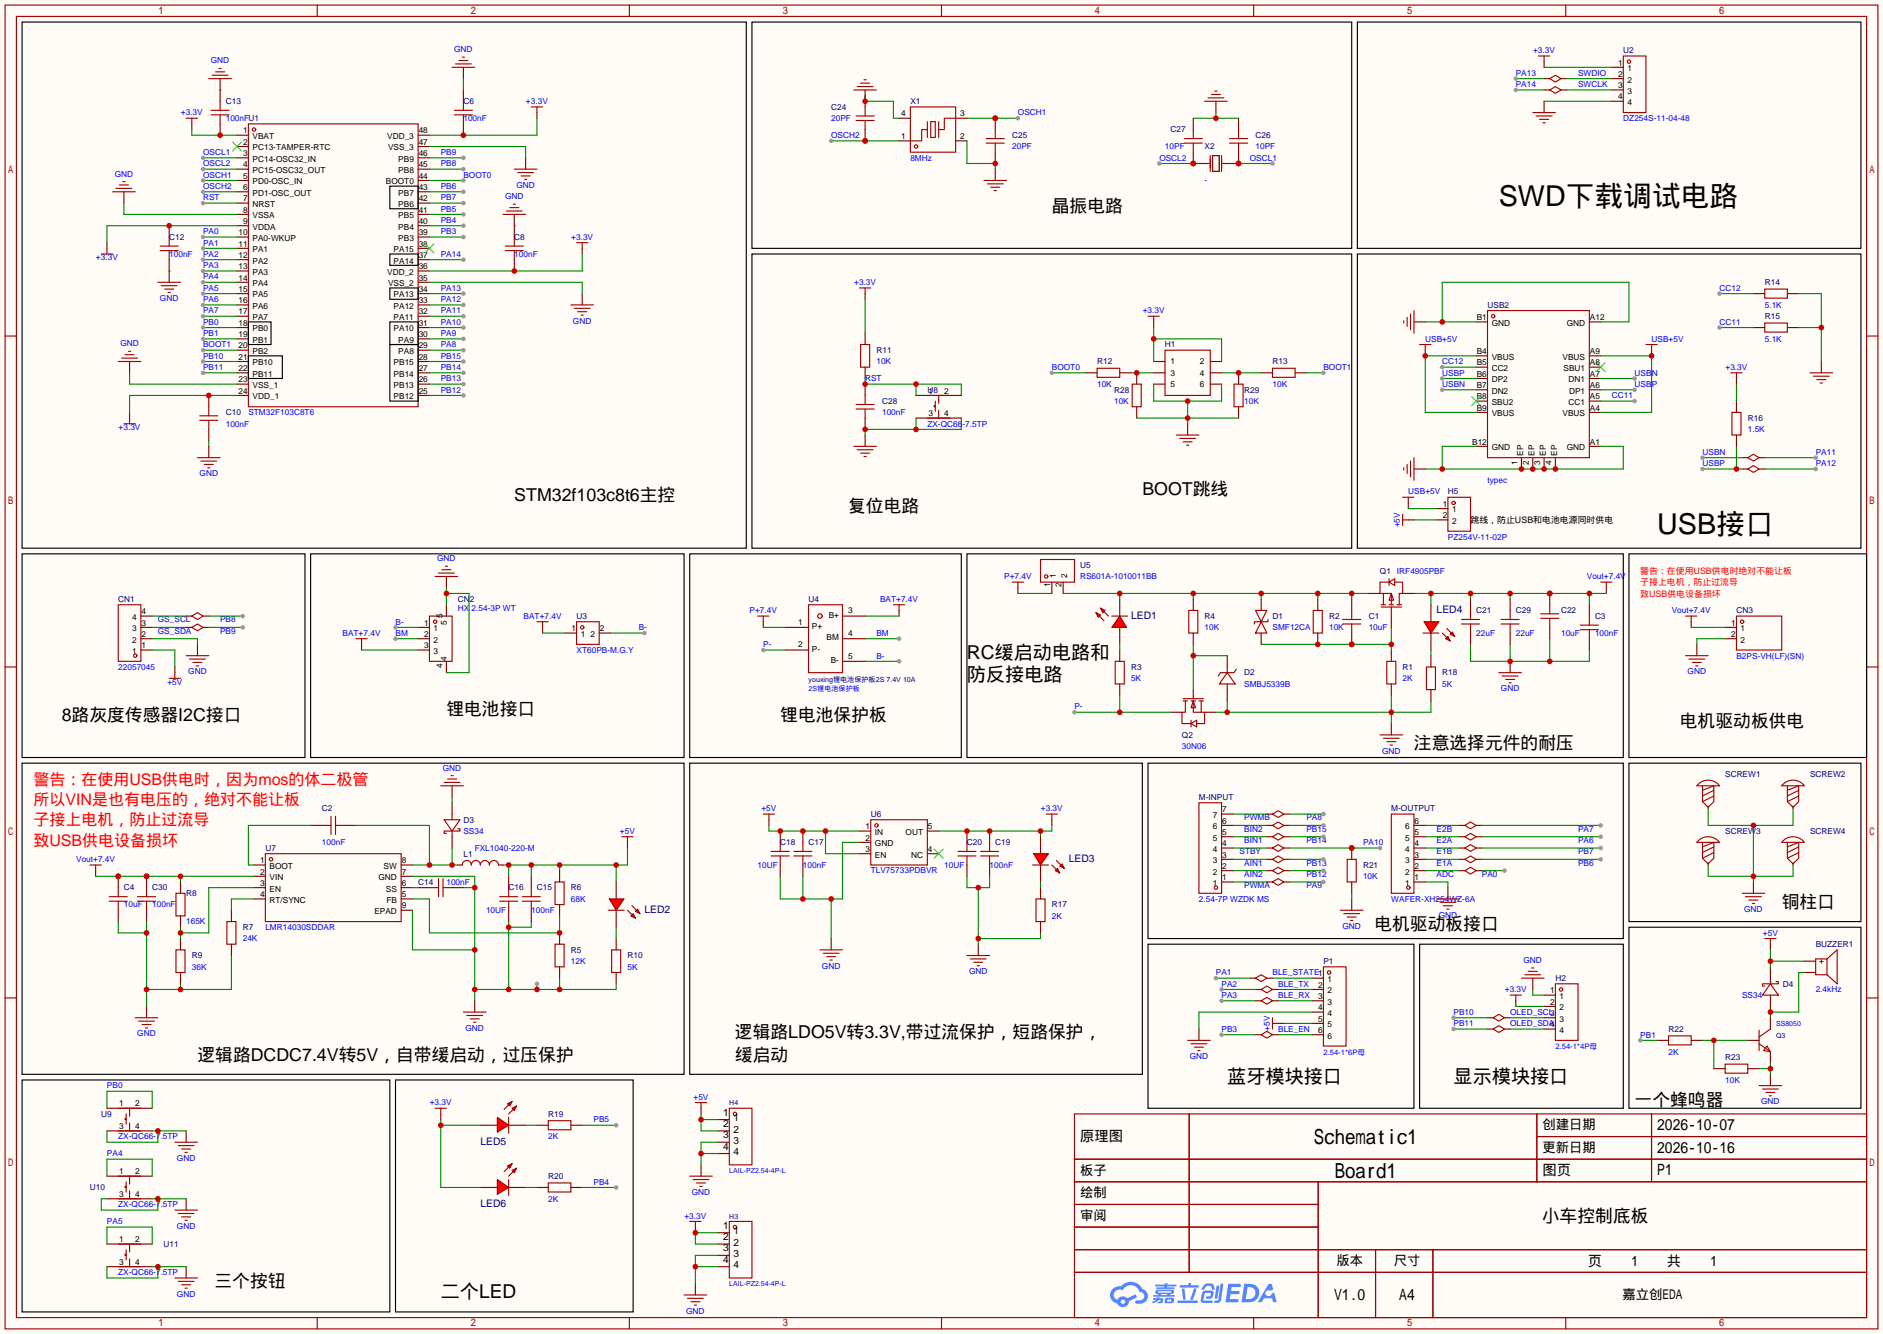
[picture p1: page 1]

原理图 | Schematic1 | 创建日期 | 2026-10-07

更新日期 | 2026-10-16

绘制 | 小车控制底板
审阅

V1.0 | A4 | 嘉立创EDA
