LUgABeEEE/DK-Line-following-car/Core/Src/main.c

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
/* Includes ------------------------------------------------------------------*/
#include "main.h"

/* USER CODE BEGIN Includes */
#include "PWM.h"
#include "Encoder.h"
#include "SpeedPID.h"
#include "Gray.h"
#include "LinePD.h"
#include "Led.h"
#include "Key.h"
#include "Ble.h"
#include "MPU6050.h"
#include "Oled.h"
#include "Ble_task.h"
#include "Control_task.h"
#include "Oled_task.h"
#include <stdio.h>      /* snprintf：OLED 诊断输出 */
#include <string.h>     /* strlen：蓝牙换速提示信息用 */
/* USER CODE END Includes */

ADC_HandleTypeDef hadc1;

I2C_HandleTypeDef hi2c1;
I2C_HandleTypeDef hi2c2;
DMA_HandleTypeDef hdma_i2c1_rx;
DMA_HandleTypeDef hdma_i2c2_tx;

TIM_HandleTypeDef htim1;
TIM_HandleTypeDef htim3;
TIM_HandleTypeDef htim4;

UART_HandleTypeDef huart2;


/* USER CODE BEGIN PV */
/* 灰度巡线传感器实例。寄存器 5 的数字状态、8 路模拟值、8 路阈值都在这里面 */
Gray_Sensor_t g_gray;

/* 外环循迹 PD 控制器实例 */
Line_PD_t g_line_pd;

/* USER CODE END PV */

void SystemClock_Config(void);
static void MX_GPIO_Init(void);
static void MX_DMA_Init(void);
static void MX_I2C1_Init(void);
static void MX_I2C2_Init(void);
static void MX_TIM3_Init(void);
static void MX_TIM4_Init(void);
static void MX_ADC1_Init(void);
static void MX_TIM1_Init(void);
static void MX_USART2_UART_Init(void);
/* USER CODE BEGIN 0 */

/**
  * @brief I2C 主机发送完成回调。
  *
  * 为什么定义在 main.c 而不是 Oled.c：
  *   当 USE_HAL_I2C_REGISTER_CALLBACKS = 0 时（CubeMX 默认），HAL 库内部
  *   带有一个 __weak 的 HAL_I2C_MasterTxCpltCallback。链接器解析 HAL 自己
  *   的调用时，会先用库里的弱符号满足，导致写在 Oled.c 的强定义被
  *   --gc-sections 丢弃（回调永远不执行）。
  *
  *   main.c 的 .o 是强制参与链接的，在它里面定义强符号才能真正覆盖弱符号。
  *
  *   注意：USE_HAL_I2C_REGISTER_CALLBACKS 在 stm32f1xx_hal_conf.h 里，
  *        CubeMX 重新生成代码时会把它改回 0，所以不要依赖那个宏。
  */
void HAL_I2C_MasterTxCpltCallback(I2C_HandleTypeDef *hi2c)
{
  if (hi2c->Instance == I2C2)
  {
    /* 通知 OLED 驱动：这一笔传输已经完成，可以发下一笔了 */
    OLED_NotifyTxComplete();
  }
}

/**
  * @brief I2C 错误回调（NACK / 总线错误 / 仲裁丢失等）。
  *
  * 为什么必须实现这个回调：
  *   中断模式下，如果屏没有应答（拔掉了、地址不对、上拉缺失），
  *   HAL 只会调用 ErrorCallback，**不会**调用 TxCpltCallback。
  *   如果这里不释放信号量，OLED 驱动要白等满 OLED_DMA_TIMEOUT_MS(50ms)
  *   才超时返回，一帧 33 次传输就是 1.6 秒，屏幕看起来像卡死了。
  *
  * 这里同样调用 OLED_NotifyTxComplete()，让等待方立即醒来，
  * 由 OLED_I2C_Send 的返回值把失败上报给上层。
  */
void HAL_I2C_ErrorCallback(I2C_HandleTypeDef *hi2c)
{
  if (hi2c->Instance == I2C2)
  {
    /* 清掉错误标志，避免下一笔传输被残留错误影响 */
    hi2c->ErrorCode = HAL_I2C_ERROR_NONE;

    OLED_NotifyTxComplete();
  }
  else if (hi2c->Instance == I2C1)
  {
    /*
     * 灰度（I2C1）出错：清 busy 标志，让下一次采样能重新发起。
     * 注意 Gray_NotifyI2cError() 内部只写普通变量，
     * 绝不调用 FreeRTOS API（中断里调会触发 configASSERT 死机）。
     */
    hi2c->ErrorCode = HAL_I2C_ERROR_NONE;

    Gray_NotifyI2cError();
  }
}

/* USER CODE END 0 */

/**
  * @brief  The application entry point.
  * @retval int
  */
int main(void)
{

  /* MCU Configuration--------------------------------------------------------*/

  /* Reset of all peripherals, Initializes the Flash interface and the Systick. */
  HAL_Init();

  /* Configure the system clock */
  SystemClock_Config();

  /* Initialize all configured peripherals */
  MX_GPIO_Init();
  MX_DMA_Init();
  MX_I2C1_Init();
  MX_I2C2_Init();
  MX_TIM3_Init();
  MX_TIM4_Init();
  MX_ADC1_Init();
  MX_TIM1_Init();
  MX_USART2_UART_Init();
  /* USER CODE BEGIN 2 */
  Motor_Init();            /* 启动 PWM、拉高 STBY，并把电机停稳 */
  Encoder_Init();          /* 启动 TIM3 / TIM4 编码器计数 */
  Speed_PID_Init();        /* 初始化左右轮速度环，参数用 SpeedPID.h 里的默认值 */
  /*
   * 灰度传感器 I2C 总线恢复。
   *
   * 必须在第一次读传感器之前做。原因：
   *   如果模块在上电时正卡在某个半截的 I2C 事务里，
   *   它会把 SDA 一直拉低，I2C 的 BUSY 标志永远不释放，
   *   之后所有读取都会超时（表现为 e=N/N，100% 失败）。
   *
   * 这个函数会给 SCL 打 9 个时钟并产生一个 STOP，
   * 让从机释放总线。正常情况下它什么也不改变，只是多花约 20ms。
   */
  Gray_BusRecovery(&hi2c1);
  Gray_Init(&g_gray);      /* 灰度传感器驱动状态复位 */
  LinePD_Init(&g_line_pd); /* 外环循迹 PD，参数用 LinePD.h 里的默认值 */
  Led_Init();              /* 两盏 LED 全灭，清空闪烁状态 */
  Key_Init();              /* 三个按键采信当前电平作为初始稳定态 */
  BLE_Init();              /* KEY 拉低=透传模式，启动 USART2 字节中断接收 */

  /*
   * MPU6050（挂在 I2C2，和 OLED 同总线）。
   *
   * 必须在车静止时标定零偏：上电后到按下启动之前这段时间正好。
   * 没接模块时 MPU6050_Init 返回 0，后续所有接口都安全空转，
   * 不影响循迹。
   */
  if (MPU6050_Init(&hi2c2) != 0U)
  {
      (void)MPU6050_Calibrate(200U);   /* 200 × 2ms ≈ 0.4s */
  }

#if (BLE_AUTOCONFIG_ON_BOOT != 0)
  /*
   * 上电把 HC-05 配置成：从机 + 广播名 LFCar + 配对码 1234。
   * 模块上电未配对时就是 AT 模式（9600），所以这里不需要手动按 KEY；
   * 配置失败（比如模块没接）只是返回 0，不影响后面的透传。
   */
  (void)BLE_AutoConfig();
#endif

  /*
   * OLED 初始化。
   *
   * 验证阶段的"整屏填白 3 秒"测试已经移除——它每次上电都会盖住
   * OledTask 的第一帧显示，正式运行时不需要。
   *
   * 如果以后需要重新做亮屏排查，取消下面这行的注释即可：
   *     OLED_FillTest();  HAL_Delay(3000);
   *
   * 返回 0 表示屏无应答（I2C 不通）。显示是辅助功能，失败不影响整车运行，
   * 所以这里只重试一次、失败就放弃，不进入 Error_Handler。
   */
  if (OLED_Init() == 0U)
  {
    HAL_Delay(50U);
    (void)OLED_Init();       /* 再试一次：有时是上电时序问题 */
  }

  /*
   * ============ 蓝牙（HC-05）初始化 ============
   *
   * HC-05 上电默认就是【透传模式】，不需要任何 AT 指令：
   *   - 手机/电脑连上 "HC-05"（配对码 1234 或 0000）
   *   - 双方直接收发数据，串口透传
   *
   * 所以这里不需要做任何配置。BLE_Init() 已在上方把 KEY 拉低并启动接收。
   *
   * 需要改模块配置时（名称/波特率/配对码），流程是：
   *   1. 调用 BLE_EnterATMode()（KEY 拉高）
   *   2. 给模块断电再上电
   *   3. 调用 BLE_Verify() 或 BLE_SetName()/BLE_SetBaud() 等
   *   4. 调用 BLE_ExitATMode()（KEY 拉低）+ 断电重启
   */
  {
    const char *msg = "\r\n[BLE] HC-05 ready (transparent, 9600 8N1)\r\n";
    HAL_UART_Transmit(&huart2, (uint8_t *)msg, (uint16_t)strlen(msg), 100U);
  }

  /* 首次调试时把下面其中一行的注释去掉，跑一遍对应自检。
     确认硬件受控之后，务必重新注释掉，否则会影响后面的循迹逻辑。 */
  // Motor_TestSequence();      /* 电机自检：正转/滑行/反转/刹车，约 10 秒 */
  // Encoder_TestSequence();    /* 编码器自检：手拨轮子，串口打印计数，约 6 秒 */
  // Speed_PID_TestSequence();  /* 速度环自检：阶跃响应，串口打印三列数据，约 5 秒 */
  // Gray_TestSequence(&g_gray, &hi2c1);  /* 灰度自检：打印模拟值/阈值/位置，约 6 秒 */
  // Led_TestSequence();        /* LED 自检：点亮/交替闪/长闪，约 6 秒 */
  // Key_TestSequence();        /* 按键自检：实时打印电平与事件，约 20 秒 */
  // BLE_Verify();              /* 蓝牙 AT 通路验证：版本/波特率/名称/MAC，约 3 秒 */
  // OLED_TestSequence();       /* OLED 自检：全屏/边框/字符表/字体，约 5 秒 */
  // BLE_TestSequence(10U);     /* 蓝牙状态监视：STAT 引脚与连接状态，10 秒 */

  /* 上车跑圈之前必须先跑这一行，把三个符号钉死（电机默认不动，安全） */
  // LinePD_VerifySigns(&g_line_pd, &g_gray, &hi2c1, 0);

  /* ================= FreeRTOS：创建任务并启动调度器 ================= */

  /*
   * 创建蓝牙任务。必须在 vTaskStartScheduler() 之前完成。
   * BleTask_Init() 返回 0 表示堆不够（xTaskCreate 失败）——这种情况任务不会
   * 运行，而且不会有任何报错，所以这里要显式检查。
   */
  if (BleTask_Init() == 0U)
  {
    HAL_UART_Transmit(&huart2, (uint8_t *)"[FATAL] BleTask create FAILED\r\n",
                      (uint16_t)(sizeof("[FATAL] BleTask create FAILED\r\n") - 1U), 100U);
    Error_Handler();
  }

  /*
   * 创建实时控制任务（优先级 3，高于蓝牙任务）。
   * 它接管原来 while(1) 里的内环/外环/UI 三个节拍。
   * 当前 CTRL_TASK_ENABLE_MOTION = 0，电机保持停止，只验证蓝牙。
   */
  if (ControlTask_Init() == 0U)
  {
    HAL_UART_Transmit(&huart2, (uint8_t *)"[FATAL] ControlTask create FAILED\r\n",
                      (uint16_t)(sizeof("[FATAL] ControlTask create FAILED\r\n") - 1U), 100U);
    Error_Handler();
  }

  /*
   * 创建 OLED 显示任务（优先级 1，最低）。
   * 内部会创建两个计数信号量（KEY1/KEY2 各一个），用于累计按键次数。
   */
  if (OledTask_Init() == 0U)
  {
    HAL_UART_Transmit(&huart2, (uint8_t *)"[FATAL] OledTask create FAILED (heap?)\r\n",
                      (uint16_t)(sizeof("[FATAL] OledTask create FAILED (heap?)\r\n") - 1U), 100U);
    Error_Handler();
  }

  /*
   * 启动调度器。正常情况下这个函数**永不返回**。
   *
   * 只有当空闲任务或定时器任务都分配不出来（堆彻底不够）时才会返回，
   * 那时说明配置有严重问题，直接进 Error_Handler。
   *
   * 原来的裸机主循环（内环 20ms / 外环 100ms / UI 20ms）已经整体搬进
   * ControlTask_Main()，这里不再保留任何业务代码。
   */
  vTaskStartScheduler();

  /*
   * 能执行到这里 = 调度器启动失败（正常情况永不返回）。
   * 最常见原因：空闲任务或定时器任务创建不出来（堆不足）。
   */
  {
    char dbg[128];

    (void)snprintf(dbg, sizeof(dbg),
                   "[FATAL] scheduler NOT started! free heap=%u (need >=1300)\r\n",
                   (unsigned int)xPortGetFreeHeapSize());
    HAL_UART_Transmit(&huart2, (uint8_t *)dbg, (uint16_t)strlen(dbg), 100U);
  }

  Error_Handler();
  /* USER CODE END 2 */

  /* Infinite loop */
  /* USER CODE BEGIN WHILE */
  while (1)
  {
    /* USER CODE END WHILE */

    /* USER CODE BEGIN 3 */
  }
  /* USER CODE END 3 */
}

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
/**
  * @brief  Period elapsed callback in non blocking mode
  * @note   This function is called  when TIM2 interrupt took place, inside
  * HAL_TIM_IRQHandler(). It makes a direct call to HAL_IncTick() to increment
  * a global variable "uwTick" used as application time base.
  * @param  htim : TIM handle
  * @retval None
  */
void HAL_TIM_PeriodElapsedCallback(TIM_HandleTypeDef *htim)
{
  if (htim->Instance == TIM2)
  {
    HAL_IncTick();
  }
}

/**
  * @brief  This function is executed in case of error occurrence.
  * @retval None
  */
void Error_Handler(void)
{
  /* USER CODE BEGIN Error_Handler_Debug */
  /* User can add his own implementation to report the HAL error return state */
  __disable_irq();
  while (1)
  {
  }
  /* USER CODE END Error_Handler_Debug */
}
#ifdef USE_FULL_ASSERT
/**
  * @brief  Reports the name of the source file and the source line number
  *         where the assert_param error has occurred.
  * @param  file: pointer to the source file name
  * @param  line: assert_param error line source number
  * @retval None
  */
void assert_failed(uint8_t *file, uint32_t line)
{
  /* USER CODE BEGIN 6 */
  /* User can add his own implementation to report the file name and line number,
     ex: printf("Wrong parameters value: file %s on line %d\r\n", file, line) */
  /* USER CODE END 6 */
}
#endif /* USE_FULL_ASSERT */
