LUgABeEEE/DK-Line-following-car/Drivers/BSD/Inc/LinePD.h

//
// Created by JiangyaF on 2026/10/11.
//
// 外环：循迹 PD 控制器（串级控制的外层）
//
// 控制结构：
//
//   灰度模块 ──error(cm)──> [本模块 PD] ──差速量──> 左右轮目标速度(cm/s)
//                                                        │
//                                                        v
//                                              [内环 SpeedPID] ──占空比──> 电机
//
// 控制律：
//
//   目标速度 = base_speed * 弯道减速系数 - Kp*error - Kd*d(error)/dt
//   左轮 = 目标速度 + 差速量
//   右轮 = 目标速度 - 差速量
//
// 前馈项 base_speed 是设计关键：它提供"直道上该跑多快"，PD 只负责修正偏差。
// 若省掉它让 PD 直接从零凑输出，直道上输出必须靠积分维持，必然积分饱和、
// 一转弯就失控。本模块因此刻意不含积分项 —— 线本身就是绝对位置基准，
// 不存在需要积分去消除的稳态误差。
//
// 符号约定（已与实测核对）：
//   误差为正 = 线偏左
//   差速量为正 = 右轮加速 / 左轮减速 = 车向左转
//   目标速度为正 = 前进
//
// 周期约定：
//   本模块周期必须是内环 SPEED_PID_PERIOD_MS 的 3~5 倍，否则两层会互相打架。
//   LinePD_Update() 内部做了检查，周期不满足时会拒绝运行并返回错误码。
//

#ifndef LINEFLLOWING_CAR_LINEPD_H
#define LINEFLLOWING_CAR_LINEPD_H

#include "main.h"
#include "Gray.h"
#include "SpeedPID.h"

/* ------------------------------------------------------------------------- */
/* LinePD_Update() 的返回值                                                    */
/* ------------------------------------------------------------------------- */

#define LINE_PD_OK              0U      /* 正常                                */
#define LINE_PD_ERR_I2C         1U      /* 灰度通信失败，本次未更新电机指令    */
#define LINE_PD_ERR_LOST        2U      /* 丢线超时，已按配置处理              */
#define LINE_PD_ERR_PERIOD      3U      /* 内外环周期比不合理，拒绝运行        */

/* ------------------------------------------------------------------------- */
/* 周期与限幅                                                                  */
/* ------------------------------------------------------------------------- */

/* 外环执行周期，单位 ms。应取 max(灰度模块更新率, 内环周期 x 3) */
/*
 * 外环（循迹 PD）的更新周期，单位 ms。
 *
 * 【从 100ms 降到 40ms 的原因：这是车速的硬上线】
 *
 *   外环每跑一拍，线相对车会移动 v × T 的距离：
 *       v=40 cm/s, T=100ms  ->  每拍移动 4.0cm
 *   而 8 路传感器总跨度只有 49mm（半量程 ±2.0cm）。
 *   也就是说线在一拍之内就跑出了传感器的视野，
 *   采到的误差是滞后的、跳变的 —— 表现为画龙、过弯跟不上。
 *
 *   降速能缓解，但降速就没意义了。真正该做的是【提高采样频率】：
 *       T=40ms, v=40 cm/s  ->  每拍移动 1.6cm，稳稳在量程内
 *
 *   由此得到车速的上限（单拍移动不超过半量程）：
 *       v_max ≈ 2.0cm / T
 *       T=100ms -> 20 cm/s
 *       T= 40ms -> 50 cm/s   <- 现在
 *       T= 30ms -> 67 cm/s
 *
 * 【代价】
 *   - 必须同时把 LINE_MIN_PERIOD_RATIO 降到 2（见该宏说明）
 *   - I2C 读传感器变得更频繁：每拍 2 次事务约 1.5ms，
 *     CPU 占用从 1.5% 升到 3.8%，可以接受
 */
#define LINE_PD_PERIOD_MS           20U

/*
 * ⚠️ 本文件里所有"按拍数"的常量都按 20ms 一拍换算过（2026-10 从 40ms 提速）。
 *    改动 LINE_PD_PERIOD_MS 时，必须同步重算下面这些：
 *      LINE_LOST_TOLERANCE / LINE_CORNER_*_CYCLES / LINE_RECOVER_CYCLES /
 *      LINE_ALL_*_CYCLES / LINE_STRAIGHT_TICKS / LINE_THETA_FF_SLEW_CMS
 *    否则防抖时间和丢线容差会跟着周期一起被悄悄改掉。
 */

/*
 * 内外环周期比的下限。小于这个值说明外环跑太快，和内环抢执行机会，
 * 表现为整车高频振荡，而且分不清是哪个环的参数不对。
 */
/*
 * 外环周期 / 内环周期 的最小倍数。
 *
 * 内环 20ms，外环 40ms -> 倍数 2，满足要求。
 *
 * 【为什么从 3 放宽到 2】
 *   原值 3 要求外环至少 60ms，那就没法把外环降到 40ms 了。
 *
 *   这个检查的本意是防止"外环比内环快，内环来不及执行目标"。
 *   倍数 2 意味着内环每转 2 圈、外环才更新一次目标，
 *   对串级控制是够用的（理论上 2 是下限，3~5 更理想）。
 *
 *   如果以后内环也提速到 10ms，那么外环可以降到 20~30ms，
 *   倍数依然保持 2 以上。
 */
#define LINE_MIN_PERIOD_RATIO       1U

/* 差速量限幅，单位 cm/s。防"内侧轮反转"导致原地打转 */
/* ========================================================================= */
/* 差速方向开关 —— 只能用实测确定，不能靠推理                                  */
/* ========================================================================= */

/*
 * 差速分配方向。
 *
 * 【原理】
 *   差速驱动要往哪边转，哪边的轮子就要慢下来：
 *       想左转 -> 左轮慢、右轮快
 *       想右转 -> 左轮快、右轮慢
 *
 *   本代码里 steer > 0 表示"线在传感器正方向一侧"。
 *   默认认为正方向就是车的左边，所以 steer > 0 时左轮减速。
 *
 * 【为什么可能需要反过来】
 *   下面两件事代码里看不出来，只要错一个差速就整体反了：
 *     1. 传感器 CH1~CH8 哪一端在车的左边（装反 180 度就镜像）
 *     2. MOTOR_A 物理上到底是左轮还是右轮（取决于电机接线）
 *
 *   表现：车一偏就朝更偏的方向跑，越纠越偏，直接出线。
 *
 * 【怎么确定该用哪个值】
 *   1. 把车放在线上，故意让车头偏到线的右侧
 *      （也就是说，从车头看，线在车身的左边）
 *   2. 进入 LINE FOLLOW，基础速度设低（10~15 cm/s）
 *   3. 观察车头转向：
 *        车向左转（朝线靠）  -> 保持 0
 *        车向右转（远离线）  -> 改成 1
 *
 *   注意：这一步跟 KP/KD 大小无关，只和正负号有关。
 *   即使 KP 很小，转向方向也应该是对的。
 *
 * 【最终取值：0，配合 GRAY_DIR_SIGN = -1】
 *
 *   推导链（全部符号都已实物确认）：
 *     ① CH1(LED1) 在物理最左侧
 *     ② GRAY_DIR_SIGN = -1  ->  线在左时 P > 0（左正右负）
 *     ③ steer = kp × P      ->  线在左时 steer > 0
 *     ④ 差速驱动铁律        ->  向左转必须右轮快
 *     ⑤ 本宏=0 时 DIR=-1    ->  left = base - steer（左轮慢、右轮快）
 *        线在左 -> 左轮慢右轮快 -> 左转 -> 朝线靠  ✅
 *
 *   若把本宏改成 1，上面第 ⑤ 步反过来，车会朝偏离方向转（越纠越偏）。
 *
 *   ⚠️ 这个宏和 GRAY_DIR_SIGN 是【乘性关系】，两个都改等于没改。
 *      排查方向问题时，先确认 GRAY_DIR_SIGN，再确认本宏，一次只动一个。
 */
#define LINE_STEER_REVERSE      0

/*
 * 由上面那个开关推导出的方向系数：
 *   REVERSE=0 -> -1.0f -> left = base - steer （默认）
 *   REVERSE=1 -> +1.0f -> left = base + steer （反向）
 */
#define LINE_STEER_DIR          (((LINE_STEER_REVERSE) != 0) ? (+1.0f) : (-1.0f))

/*
 * 差速量限幅，单位 cm/s。
 *
 * 【从 25 提到 35 的原因】
 *   钝角弯需要更大的差速才能跟上。实测 LBAS=35 时弯道 s 最大只到 11.4，
 *   看起来余量很大；但那是【已经跟上了】的状态，钝角弯的瞬间需要
 *   远超稳态值的差速才能及时把车头拉回来。
 *
 *   按轮距 15cm 估算，v=45、转弯半径 15cm 时需要 22.5 cm/s。
 *   留一倍余量到 35，才有能力应付半径更小的钝角弯。
 *
 * 上限约束：35 < LINE_SPEED_LIMIT(75)，且 base + 35 不能超过内环量程。
 */
#define LINE_DIFF_LIMIT             35.0f

/* 目标速度限幅，单位 cm/s。内环本身也有限幅，这里提前夹一次更安全 */
/*
 * 单轮目标速度上限，单位 cm/s。
 *
 * 【从 60 提到 75 的原因】
 *   base 40 + 差速 25 = 65 > 60，外侧轮一直被夹住，
 *   等于实际差速被悄悄削弱了。提到 75 后 base 40 + 35 = 75 刚好不被夹。
 *
 * 上限约束：必须小于内环的 SPEED_LIMIT_CMS(80)，
 * 否则外环给出的目标会被内环二次限幅，产生不一致。
 */
#define LINE_SPEED_LIMIT            75.0f

/*
 * 弯道减速：误差达到该值时，目标速度降到基础速度的这个比例。
 * 目的是让车在急弯前主动放慢，而不是硬冲出去。
 * 设为 0.0f 表示不减速（全程保持基础速度）。
 */
/*
 * 弯道减速系数：误差达到满量程时，速度降到基础速度的这个比例。
 *
 * 【从 0.55 降到 0.40 的原因】
 *   钝角弯丢线的根源是"来不及" —— 车以 40+ cm/s 冲进弯道，
 *   等误差长起来时线已经跑到视野外了。
 *
 *   这个系数是按 |误差| 线性插值的：
 *     直道 |e|≈0      -> 不减速
 *     |e|=1cm         -> 降到 0.76 倍
 *     |e|=2cm         -> 降到 0.51 倍
 *     满量程 |e|=2.45 -> 降到 0.40 倍  (40 cm/s -> 16 cm/s)
 *
 *   所以缓弯几乎不减速，急弯大幅减速 —— 正是想要的行为。
 *
 * 代价：钝角弯通过速度会明显变慢。想更激进可以回调到 0.45~0.50。
 */
#define LINE_CURVE_SLOW_MIN         0.45f

/*
 * ---- simple track：简单赛道速度规划（只有弧线/直角的赛道）----
 *
 * 目标：直道快、入弯提前减速、直角稳。
 * 参考网上常见做法：
 *   - 按偏离量动态降速（felipemmattia/PID_line_follower_robot）
 *   - 按转弯深度/持续时间动态加力（Sndcooper/adaptive-line-follower 的 curve boost）
 *   - 8 路模拟量 + 动态速度缩放 + 丢线恢复（deepjyoti-io/Adaptive-PID-line-follower）
 *
 * 曲率深度 depth = W_ERR*|error|/err_max + W_STEER*|steer|/diff_limit，
 * 再用 |d(error)/dt| 做入弯预判；depth=0 时全速，depth=1 时 LINE_CURVE_SLOW_MIN。
 */
#define LINE_DEPTH_W_ERR            0.60f
#define LINE_DEPTH_W_STEER          0.40f

/* 入弯预判：误差变化率超过这个值（cm/s）就按满深度处理 */
#define LINE_LEAD_DERR_MAX          80.0f

/* 直道加速的判定门槛：误差、差速、每拍增量（这三项与档位无关） */
#define LINE_STRAIGHT_EPS_CM        0.57f    /* =0.35cm(旧标定)×1.643 */
#define LINE_STRAIGHT_STEER_CM      8.0f
#define LINE_STRAIGHT_BOOST_STEP    0.03f
#define LINE_BOOST_DECAY_STEP       0.06f

/* ------------------------------------------------------------------------- */
/* 赛道档位 —— 换赛道只改这一个宏                                              */
/* ------------------------------------------------------------------------- */

/*
 * 不同「简单赛道」的弯半径、直道长度差别很大。同一套速度参数跑两条赛道，
 * 往往一条太保守、另一条又冒进。所以这里按档位整组切换：
 *
 *   0 = 保守：弯多、直道短，或新场地第一次上车
 *   1 = 均衡：默认值，大多数「弧线 + 直角」赛道从这一档起步
 *   2 = 激进：直道占比高、弯半径大、地面抓地好
 *
 * 每档只动「速度规划」——基础速度、直道加速、角点限速、入弯预判、减速斜坡；
 * 转向增益（Kp / Kd / 差速限幅）保持不动，所以切档只改过弯快慢，不改过弯轨迹。
 *
 * ⚠️ 换档后先跑一圈确认整圈不丢线，再谈圈速。烧进去之后连蓝牙看 [VER] 行，
 *    末尾会带 P0/P1/P2，用来确认烧的是哪一档。
 */
#define LINE_SIMPLE_PROFILE         1

#if (LINE_SIMPLE_PROFILE == 0)
/* 保守：弯多、直道短，或新场地第一次上车 */
#define LINE_PD_DFLT_BASE_SPEED     40.0f   /* 基础速度 cm/s                 */
#define LINE_STRAIGHT_TICKS         12U     /* 连续居中几拍(20ms/拍)=240ms   */
#define LINE_STRAIGHT_BOOST_MAX     0.15f   /* 直道最多 +15%（→ 46 cm/s）    */
#define LINE_CORNER_SLOW_MAX        0.70f   /* 角点期间的速度上限系数         */
#define LINE_LEAD_WEIGHT            0.80f   /* 入弯预判强度（越大越早减速）   */
#define LINE_DOWN_RAMP_MULT         2.5f    /* 减速斜坡相对加速的倍数         */

#elif (LINE_SIMPLE_PROFILE == 2)
/*
 * 激进：直道长、弯缓、抓地好的赛道。
 *
 * ⚠️ 天花板提醒：实测电机到约 57 cm/s 就打满占空比，而本档
 *    55 × (1 + 0.35) = 74 cm/s 明显超过它 —— 直道上 PID 会长时间饱和。
 *    有抗饱和保护不会失控，但也跑不到目标值；若发现进弯前刹不住，
 *    先把 LINE_STRAIGHT_BOOST_MAX 降到 0.20（→ 66 cm/s）再试。
 */
#define LINE_PD_DFLT_BASE_SPEED     60.0f
#define LINE_STRAIGHT_TICKS         8U      /* 160ms */
#define LINE_STRAIGHT_BOOST_MAX     0.25f
#define LINE_CORNER_SLOW_MAX        0.62f
#define LINE_LEAD_WEIGHT            0.60f
#define LINE_DOWN_RAMP_MULT         1.6f

#else
/* 均衡（默认；非法值也落到这一档）—— 2026-10 实车调参结果，别轻易动 */
#define LINE_PD_DFLT_BASE_SPEED     55.0f
#define LINE_STRAIGHT_TICKS         10U     /* 200ms */
#define LINE_STRAIGHT_BOOST_MAX     0.30f
#define LINE_CORNER_SLOW_MAX        0.68f   /* 弧线限速：直道快、弧线慢 */
#define LINE_LEAD_WEIGHT            0.70f
#define LINE_DOWN_RAMP_MULT         2.0f
#endif

/*
 * ---- 高速稳定性 ----
 *
 * 实测 LKP=20 在 50cm/s 时出现 ~3Hz 极限环：误差每个采样周期翻一次符号，
 * 差速在 ±35 之间来回打满（日志 22:36:52~54）。原因：
 *   40ms 内车走 2cm，误差量化步长 0.7cm，Kp=20 时一个通道跳变就带来
 *   14cm/s 的差速阶跃；加上传感器/内环延迟，正反馈自激。
 *
 * 两条抑制措施：
 *   1) Kp 随速度下降（gain scheduling）：高于参考速度时按 参考/实际 缩放；
 *   2) 差速变化速率限制：每个外环周期最多变 LINE_STEER_SLEW_CMS，
 *      把"来回打满"的低频摆动压成平滑过渡。
 */
/*
 * ---- 弧线流畅度：线角前馈 + 位置低通 ----
 *
 * A) 线角前馈：用"位置变化 / 里程变化"估计线在车头下的切线角 θ，
 *    直接给一个前馈差速，不等误差积累。小角度下 tanθ≈θ，不需要 atan。
 *      steer_ff = LINE_THETA_FF_GAIN × v × θ
 *    其中 gain ≈ 轮距/前视距离（16cm 轮距、10cm 等效前视 -> 1.6）。
 *
 * B) 位置低通：8 路量化步长 0.7cm，50cm/s 时误差是阶梯状，
 *    先一阶低通再进 PD，能明显压掉"阶梯引起的高频摆动"。
 */
/*
 * 线角前馈增益。0 = 关闭（2026-10-28 实测：这套"位置微分"前馈对 8 路
 * 量化传感器不划算，噪声占比太高；先关掉，只保留位置低通 + yaw 阻尼）。
 * 需要重新启用时改为 0.8，并按死区/斜坡/限幅一起观察。
 */
#define LINE_THETA_FF_GAIN          0.70f   /* 前馈增益（× v × θ），0=关；=1.15/1.643 */

/* =========================================================================
 * 曲率限速（用陀螺估曲率，替代"误差驱动"的减速）
 *
 * 原理：车在转弯时，陀螺测到的横摆角速度 ω 与车速 v 满足
 *          κ = ω / v          （曲率，单位 1/cm）
 *       允许的最大侧向加速度 a_lat 决定了过这个弯的速度上限：
 *          a_lat = v² · κ   =>   v_max = sqrt(a_lat / κ)
 *
 * 与"误差驱动"的区别：
 *   误差驱动：车偏了才减速（滞后，且缓弯也会被误减速）
 *   曲率驱动：一进弯就按实际半径给速度（提前，缓弯跑得快、急弯才慢）
 *
 * 陀螺没接好时自动退化为原来的误差驱动（见 LinePD.c）。
 * ========================================================================= */
#define LINE_CURVE_SPEED_MODE       1       /* 1=曲率限速  0=旧误差限速        */
#define LINE_ALAT_MAX_DFLT          100.0f  /* 默认允许侧向加速度 cm/s² */
#define LINE_CURVE_W_MIN_DPS        12.0f   /* 小于这个角速度视为直道，不限制  */

/*
 * 进弯预判减速（用线角 θ，比陀螺早 0.2~0.3 秒）。
 *
 * 陀螺曲率限速是"反应式"的：车必须在转、ω 起来了才降速，
 * 实测 12cm 半径的小半弯，车以 40cm/s 冲进去需要 a_lat=133cm/s²，
 * 远超能力 -> 甩出 -> 丢线 -> 原地转 -> 视觉上"跑一下停一下"。
 *
 * 线角 θ 在进弯前就会变大，用它提前把速度压下来。
 *   |θ| <= LINE_LOOKAHEAD_THETA_MIN      不减速
 *   |θ| >= LINE_LOOKAHEAD_THETA_MAX      降到 (1 - LINE_LOOKAHEAD_DROP)
 * 中间线性插值。
 */
#define LINE_LOOKAHEAD_THETA_MIN    0.25f   /* rad；=0.15×1.643（新标定）      */
#define LINE_LOOKAHEAD_THETA_MAX    1.15f   /* rad；=0.70×1.643（新标定）      */
#define LINE_LOOKAHEAD_DROP         0.20f   /* 最多降 20% 基速                 */
#define LINE_CURVE_ERR_DEADBAND     0.45f   /* 曲率模式下：|e|/err_max 超过这个才兜底减速 */
#define LINE_CURVE_FALLBACK_SLOW_MIN 0.42f  /* 曲率模式下兜底减速的最低系数   */
#define LINE_THETA_MAX_RAD          1.15f   /* θ 限幅；=0.70×1.643（新标定） */
#define LINE_THETA_LPF              0.50f   /* θ 低通系数 */
#define LINE_POS_LPF_ALPHA          0.50f   /* 位置低通系数 */

/*
 * 前馈的工程化约束（大佬们加前馈都有的三条，缺一条就会"越加越抖"）：
 *
 *   1) 死区：|θ| 很小（车基本直的）时不加，避免把量化噪声放大成差速；
 *   2) 斜坡限幅：前馈每拍最多变化多少，杜绝"一拍打满"；
 *   3) 输出限幅：前馈最多占差速上限的多少（它只是辅助，不该主导转向）。
 */
#define LINE_THETA_DEADBAND         0.066f  /* rad；=0.04×1.643（新标定） */
#define LINE_THETA_FF_SLEW_CMS      1.0f    /* 每拍(20ms)前馈变化上限 cm/s = 50cm/s² */
#define LINE_THETA_FF_CLAMP_RATIO   0.35f   /* 前馈 <= 0.35 × 差速上限 */

/*
 * ---- 惯导（MPU6050）：A yaw 阻尼 / B 陀螺航向 / C 定角转弯 ----
 *
 * A) yaw 阻尼：车身在转时给一个反向差速，压制"过弯后半段来回摆"：
 *      steer -= LINE_YAW_DAMP_GAIN × ω_yaw
 *    ω_yaw 单位 °/s，增益单位 cm/s per °/s。太大转向会发肉，0.1~0.2 起步。
 *
 * B) 陀螺航向：yaw 积分从"编码器差分"换成"陀螺"，打滑不再影响角度。
 *    没有模块/读取失败时自动退回编码器差分。
 *
 * C) 定角转弯：承诺转向的目标角（直角 90°/锐角 95°）现在由 B 的陀螺航向
 *    计量，转够就停，不再依赖打滑的轮速积分。
 */
#define LINE_USE_IMU_YAW            1
#define LINE_YAW_DAMP_GAIN          0.03f   /* cm/s per (°/s) */
#define LINE_YAW_DAMP_MAX_CMS       8.0f    /* 阻尼项限幅 */

#define LINE_KP_SPEED_REF_CMS       30.0f   /* 参考速度，低于它不缩放 */
#define LINE_KP_MIN_SCALE           0.70f   /* 高速时 Kp 最低缩到 70% */

/* =========================================================================
 * 大误差转向增益（bo 实测结论）
 *
 * bo 把差速限幅从 35 放到 60，但实测 |s| 最大只有 42.1、>45 占比 0%：
 *   -> 限幅根本不是瓶颈，PD 输出本身到不了 60。
 *
 * 原因：Kp 随速度缩放。kp=12、车速 55 时 kp_eff = 12×30/55 = 6.55，
 *       |e|=2.5 时 steer 只有 16cm/s；实测 |s|/|e| 中位 9.4。
 *       -> 误差打满也给不出足够差速，内侧轮只能"慢转"不能"停转"。
 *
 * 这里在误差超过阈值后，把差速整体放大（带线性过渡，避免阶跃）：
 *   |e| <= GAIN_E0        -> ×1.0
 *   |e| >= GAIN_E1        -> ×(1+GAIN_MAX)
 *   |e|=2.5 时约 ×1.6，steer 22.6 -> 36，内侧轮 55-36 ≈ 19 -> 停转区
 * ========================================================================= */
#define LINE_STEER_GAIN_E0_CM       2.46f   /* =1.50×1.643（新标定）            */
#define LINE_STEER_GAIN_E1_CM       4.11f   /* =2.50×1.643（新标定）            */
#define LINE_STEER_GAIN_MAX         0.00f   /* ⚠️当前无效：br 撤销（实测加剧振荡）*/

/*
 * bp 实测：增益瞬时生效导致 2.4Hz 极限环（翻转率 48%，|s| 过零 17.8）。
 * 修法：增益系数本身做低通，误差抖动时不会跟着抖。
 *   0.35 的系数 ≈ 3 拍时间常数（120ms）
 */
#define LINE_STEER_GAIN_LPF         0.35f

/*
 * 转向输出低通。
 * 2.4Hz 振荡的周期约 416ms（10 拍），0.5 的低通相当于 2 拍平均，
 * 正好把这个频段的幅度削掉一半，同时只带来约 40ms 相位滞后。
 */
#define LINE_STEER_OUT_LPF          1.00f   /* ⚠️当前无效：1.0=不滤波（bq 撤销）*/
#define LINE_STEER_SLEW_CMS         26.0f   /* 每周期差速最大变化量（20ms 周期） */

/*
 * ---- 比赛自动停车（规则：一圈后停在启停线，测试点偏差 ≤2cm 拿满 P）----
 *
 * 几何关系（实测）：
 *   灰度条中心 --17cm--> 后轮轴中点（= 规则里指定的"测试点"）
 *   起跑时把后轮轴中点对准起跑线，则：
 *     车头灰度条在测试点前方 17cm；
 *     跑完一圈时，灰度条先压到启停线（离测试点还差 17cm），
 *     再直行 17cm，测试点正好落在启停线中轴线上。
 *
 * 启停线是 5cm 长、1.8cm 宽的横线：车头 8 路会瞬间全黑 1~3 拍，
 * 和"角点全黑"的区别是它很短（角点会持续很多拍）——用脉冲宽度区分。
 */
#define LINE_RACE_STOP_OFFSET_CM    17.0f   /* 灰度条中心 -> 测试点 */
#define LINE_RACE_ARM_FRAC          0.50f   /* 跑过半圈才允许识别启停线 */
#define LINE_RACE_DETECT_CHANNELS   6U      /* 8 路里至少几路全黑 */
#define LINE_RACE_PULSE_MAX         3U      /* 全黑持续超过这么多拍 = 角点，不算 */
#define LINE_RACE_DETECT_ERR_CM     1.97f   /* =1.2cm(旧标定)×1.643 */
#define LINE_RACE_APPROACH_CMS      12.0f   /* 识别后的接近速度 */

/*
 * 接近段超时（拍，20ms/拍）。15cm 在 12cm/s 下约 1.25s = 63 拍，
 * 给 150 拍（3s）兜底：打滑/编码器异常时也能停，不会"识别到了却永远不停"。
 */
#define LINE_RACE_APPROACH_TIMEOUT_CYCLES   150U

/*
 * 启停线识别时的横摆角速度上限（°/s）。
 *
 * 启停线在【直道中间】，过线时车基本不转；而误检几乎都发生在弯道里
 * （线斜着扫过阵列，中间 4~5 路会同时黑，三判据挡不住）。
 * 实测（cn 版）：
 *   真启停线 ra≈290~305cm，|ω| = 4~24°/s
 *   弯道误检 ra≈60~170cm， |ω| = 26~90°/s
 * ⚠️ 45°/s 只适用于"终点在直道上"的赛道。若终点在弯道末端，必须放宽：
 *      ω = v / R × 57.3
 *      椭圆赛道终点在 R=50cm 弯道末端、接近区速度 42cm/s：
 *      ω = 42/50 × 57.3 = 48°/s > 45 -> 真启停线会被挡住！
 * ⚠️ 2026-10-30 实测后【关闭】（设为 0）：车体一抖，偏航角速度就冲到
 *    300°/s 以上，把真正的启停线也一起拒掉（日志里 bn 一直涨、bp 正常、
 *    折回差在窗口内，但 rp 从不变成 2）。
 *    里程窗口（按圈折回 ±35cm）已经能把实测的弯道误检全部挡掉
 *    （误检折回差都在 −133cm 以外），闸门是多余且有害的一层。
 *    需要时可以设回一个正数重新启用。
 *
 *   原设计取 200°/s：只挡"猛打方向"这种剧烈动作（对应 R<12cm @42cm/s）。
 *   为什么不再收紧：里程窗口（按圈折回 ±25cm）已经能挡住绝大多数误检，
 *   陀螺闸门只作最后一道保险。收得太紧反而会间歇性漏掉真启停线
 *   —— 实测 cu 版就有"有时候能停、有时候跑好几圈不停"的现象，
 *   部分原因就是闸门在车身轻微摆动时被触发。
 *
 * 陀螺没就绪时不做这个判断（宁可漏检也不误停的老原则仍然由别的判据保证）。
 */
#define LINE_RACE_DETECT_MAX_DPS    0.0f   /* 0 = 关闭（见下方说明） */

/*
 * 接近段位移直接用编码器（traveled − 识别里程）。
 *
 * 曾经试过"编码器 + 陀螺打滑检测"融合，实车验证后用户确认不需要：
 *   接近段只有 1.25 秒、12cm/s，编码器在这段的表现足够好，
 *   加融合反而多一层可能出错的逻辑。
 * 现在唯一要调的就是 LINE_RACE_BRAKE_MARGIN_CM。
 */

/* =========================================================================
 * 终点接近区（"降速武装"）
 *
 * 背景：整圈 350cm 里，误检可能发生在任意里程（实测 rd 分别出现在
 *       51 / 288 / 429 / 534 / 592cm），仅靠空间特征滤不干净；
 *       而且 55cm/s 时启停线脉冲窗口只有 28ms，20ms 采样容易漏。
 *
 * 做法（周长模式 LAP>=50 时生效）：
 *   traveled >= LAP − ZONE_CM  ->  进入接近区：
 *       ① 限速到 ZONE_SPEED_CMS（42cm/s）
 *           - 脉冲窗口 28ms -> 37ms，10ms 采样能抓 3~4 拍
 *           - 刹车距离更短，停车更准
 *       ② 同时武装（允许识别启停线）
 *           - 接近区之前根本不武装，杜绝中途误检
 *
 * 自适应模式（LAP<50，不知道周长）只能保持 ARM_MIN_CM 武装、不降速。
 * ========================================================================= */
/*
 * 接近区的触发方式：按【一圈周长的比例】，不是固定厘米数。
 *
 * 原因：固定 60cm 在小赛道上占比过大（320cm 的赛道 = 19%），
 * 在大赛道上又太短来不及减速；用比例可以自适应不同长度的赛道。
 *
 * 0.80 的含义：跑完 80% 周长就进入接近区，剩 20% 用来减速 + 识别。
 * 以 320cm 的赛道为例：从 256cm 开始限速 42cm/s，剩 64cm ≈ 1.5 秒。
 *
 * 比例太低（如 0.5）= 一半路程都在慢跑，圈速会掉；
 * 比例太高（如 0.95）= 来不及减速，识别窗口也短。
 */
#define LINE_RACE_ZONE_FRAC         0.80f   /* 跑完周长的这个比例进入接近区 */
#define LINE_RACE_ZONE_SPEED_CMS    42.0f   /* 接近区限速 */
/*
 * 到点前多少厘米开始硬刹。
 *
 * 这个值同时吸收"识别延迟 + 刹车距离"：识别是在全黑脉冲结束那一拍才确认的，
 * 车已经多走了几十毫秒；硬刹本身也要滑 0.3~0.5cm。
 * 实测停车偏过 1cm -> 把这里加 1（2.0）；停早了就减。
 */
#define LINE_RACE_BRAKE_MARGIN_CM   3.0f
/*
 * 【已删除】里程兜底 LINE_RACE_FALLBACK_CM
 *
 * 2026-10-30 用户明确要求：不需要过冲保护，停车只能由启停线识别触发。
 * 原来的 LAP−2cm 兜底把 LAP 变成了"到达里程就停下"，架空识别逻辑，
 * 表现为"还没到终点就停了"；改成 LAP+30 也只是把误停位置推后，
 * 本质上仍是"分不清识别失败和识别成功"。所以整条删掉。
 *
 * 代价：识别一直失败时车会一直跑。这是有意为之 ——
 *       跑过头可以手动停（长按 KEY2 / 蓝牙 X），提前停会把成绩作废。
 */

/*
 * 周长模式下的识别窗口（cm，相对"灰度条应该压线的位置"）。
 *
 * 灰度条在测试点前方 17cm，所以压线瞬间 traveled ≈ LAP − 17。
 * 只在这个窗口内接受脉冲，窗口外的脉冲一律忽略：
 *   接近区 80% 到压线前 25cm 之间的误检 -> 忽略
 *   压线后 25cm 之外的误检           -> 忽略
 * 这一条让"按里程武装"从粗筛（80%）变成精筛（±35cm），
 * 弯道/接缝的误检基本不可能落在窗口里。
 *
 * ⚠️ 25cm 太紧的实测依据（cx 版日志）：
 *   有一次真线在 ra=268.6 触发，折回差 = −24.4cm ——
 *   只差 0.6cm 就被窗口挡掉（窗口是 ±25）。
 *   而实测的弯道误检折回差都在 −133 ~ −153cm，
 *   放宽到 ±35cm 完全不会放进误检，却能吃掉"起跑位置偏差/
 *   一圈周长估计误差"带来的正常散布。
 */
#define LINE_RACE_DETECT_WINDOW_CM  35.0f

/*
 * 自适应模式（不知道赛道周长时用）：
 *   LAP 设 1 -> 只靠启停线识别停车，不需要周长；
 *   起跑后先跑过 LINE_RACE_ARM_MIN_CM 才武装（避开起跑线附近的杂线）；
 *   注意：现在没有任何里程兜底，识别不到就一直跑（用户要求）。
 */
/*
 * 自适应模式的武装里程。
 *
 * 有的赛道整圈只有 120cm：武装里程必须明显小于周长，
 * 否则车还没"武装"就已经到终点了。取 50cm，
 * 120cm 的赛道也能在跑到一半时进入识别阶段。
 * 更短的赛道（<50cm 一圈）请用周长模式（LAP>=50）。
 */
#define LINE_RACE_ARM_MIN_CM        50.0f   /* 自适应模式的武装距离 */

/*
 * 自适应模式下"多早算太早"。
 *
 * 实测教训：在弯道/接缝处误识别一次启停线，会把"周长"学成 1.3~1.8m，
 * 之后每一圈都按这个错误周长兜底停车——表现就是"每次只跑一小段就停"。
 * 所以：
 *   - 自适应模式里，识别点里程 < LINE_RACE_DETECT_MIN_CM(50cm) 的一律不认；
 *   - 周长学习已关闭（LINE_RACE_LEARN_LAP=0），不再参与判断。
 */
#define LINE_RACE_DETECT_MIN_CM     50.0f   /* 自适应模式：识别点至少跑这么远才认 */

/*
 * 是否允许自适应模式"学习周长"。
 *
 * 2026-10-28 关闭：实测在弯道/接缝误识别一次就会把周长学成 1.3~1.8m，
 * 之后每圈都在错误位置停；而且用户明确不需要这个功能。
 * 关掉后：自适应模式只靠启停线识别，识别不到就按 2000cm 安全上限停。
 */
#define LINE_RACE_LEARN_LAP         0
/* 【已删除】LINE_RACE_MAX_CM：同上，不再按里程强制停车 */

/* 编译期默认增益 */
/*
 * 外环比例增益，单位 cm/s 差速量 每 cm 误差。
 *
 * 【实测取值 20.0】
 *   一开始按"1cm 误差给 8cm/s"设的，实测偏软、过弯跟不上。
 *   逐步加到 20 之后直道和弯道都明显更稳。
 *
 *   为什么这个值比直觉大：传感器通道间距只有 7mm，
 *   误差的"物理分辨率"很粗，需要较高的增益才能获得足够的转向权限。
 *
 *   配合 LINE_DIFF_LIMIT = 35 时，e 超过 1.75cm 就进入满幅，
 *   相当于"小误差线性、大误差饱和"，对循迹反而很合适。
 */
#define LINE_PD_DFLT_KP             12.0f
/*
 * 外环微分增益，单位 cm/s 差速量 每 (cm/s) 误差变化率。
 *
 * 【实测取值 1.0 —— 不能大】
 *   微分项 = KD × Δe / dt，而 dt = 40ms，所以放大倍数是 1/0.04 = 25 倍！
 *
 *     1mm 的位置抖动（很常见，7mm 间距的量化噪声就有这个量级）：
 *       KD=1 ->  2.5 cm/s  (占差速限幅的  7%，可忽略)
 *       KD=2 ->  5.0 cm/s  (14%)
 *       KD=4 -> 10.0 cm/s  (29%，肉眼可见的抖动)
 *
 *   实测 KD 加到 4 就明显抖，降到 1 后直道很稳。
 *
 * 【外环周期变了要重算】
 *   这个放大倍数 = 1/dt，所以：
 *     周期从 40ms 改成 100ms（dt 变大）-> 同样的 KD 变得温和，可以调大
 *     周期改成 20ms（dt 变小）          -> 同样的 KD 变得更凶，必须调小
 *   改外环周期后如果出现抖动，第一个要怀疑的就是 KD。
 */
#define LINE_PD_DFLT_KD             0.6f

/*
 * 基础速度由上面的「赛道档位」决定（LINE_SIMPLE_PROFILE）：
 *   0 保守 = 26 cm/s，1 均衡 = 30 cm/s，2 激进 = 34 cm/s。
 * 想临时改速度但仍保留档位的其它参数，直接改对应分支里的数值即可。
 */

/*
 * 循迹模式的起步斜坡，单位 cm/s per second。
 *
 * 【为什么必须有】
 *   没有斜坡时，进入 LINE 模式或调大 LBAS 的那一拍，
 *   基础速度会从 0 直接跳到目标值（比如 15 cm/s）。
 *   内环此时误差突然变成 15，P 项和积分一起发力，
 *   电机被瞬间灌入很大的占空比 —— 表现就是"一启动猛窜一下"。
 *
 *   加上斜坡后，基础速度每 100ms 只增加
 *   LINE_SPEED_RAMP_CMS_PER_SEC / 10 cm/s（默认 5 cm/s），
 *   0 到 15 大约需要 300ms，起步是平滑的。
 *
 * 【和 SPEED_TEST 的关系】
 *   SPEED_TEST 有自己的斜坡（SPEED_RAMP_CMS_PER_SEC，按 20ms 节拍），
 *   两者互不影响。
 */
#define LINE_SPEED_RAMP_CMS_PER_SEC  90.0f

/*
 * 微分低通滤波系数 (0,1]。灰度解算出的位置在探头交界处有固有台阶，
 * 不滤波的话 D 项会把台阶当成分辨率极高的真实变化而放大。
 * 但系数太小会让 D 项严重滞后、失去阻尼作用（外环 100ms 周期下尤其明显），
 * 所以取 0.7 而不是更小。
 */
#define LINE_PD_DFLT_D_FILTER       0.5f

/*
 * 丢线容忍的连续周期数。超过之后按着下面两个开关处理。
 * 1 个周期 = LINE_PD_PERIOD_MS。
 */
/* ========================================================================= */
/* 丢线搜索（抛线挽救）                                                        */
/* ========================================================================= */

/*
 * 丢线后是否尝试找回。
 *
 *   1 = 开启搜索：朝最后看到线的方向原地慢转，限时找线
 *   0 = 丢线立即停车（最保守，但没有任何挽救机会）
 *
 * 【搜索原理】
 *   灰度模块在丢线时会把位置固定为"最后一次偏离方向的满幅值"
 *   （见 Gray.c 里的 GRAY_LOST_ERROR_FACTOR），
 *   所以 pd->error 的符号就代表了线最后在哪一边，用它决定转向。
 *
 *   搜索动作用"原地转"而不是"往前开"：
 *     外侧轮 +LINE_SEARCH_SPEED_CMS
 *     内侧轮 -LINE_SEARCH_SPEED_CMS × LINE_SEARCH_INNER_RATIO
 *   这样车绕着自身中心转，不会跑出赛道范围。
 *   如果改成往前开，车会越走越远，反而更找不回来。
 *
 * 【为什么必须限时】
 *   如果线真的没了（冲出赛道、压到桌边），无限搜索会让车一直转下去。
 *   超时后强制停车是最安全的兜底。
 */
/*
 * 搜索方向锁存。
 *
 * 【只用实测数据，不做推理】
 *
 *   方向 = 进入搜索那一拍 pd->error 的符号。
 *   而丢线期间 error 是 Gray 模块给出的"最后一次有效位置"的满幅回退值，
 *   所以这个符号直接来自传感器最后一次真实的测量，不是猜测。
 *
 *   曾经试过用"位置变化趋势"来预判急弯方向，但那个符号从未实测验证过，
 *   实际表现是"不管什么弯都往同一侧转"—— 这正是没有数据依据的行为，
 *   已删除。
 *
 * 【方向错了怎么办】
 *   由 LINE_SEARCH_BIDIRECTIONAL 兜底：先按锁存方向转一段，
 *   没找到就自动反方向再转一段。这样即使方向判断错，
 *   最多多花一段时间，不会彻底丢线。
 */
#define LINE_RECOVER_CYCLES         4U    /* 80ms */

/*
 * 搜索方向判定所需的最小信息量，单位 cm。
 *
 * 只有最后一次有效位置 |last_valid| 超过这个值，才认为
 * "车确实偏在线的一侧"，朝那一侧搜索才有数据依据。
 *
 * 低于这个值时说明线原本就在正中间（或者从未看到过线），
 * 我们【没有任何信息】判断它往哪边跑了 —— 此时不搜、直接停车。
 *
 * 0.5cm 的依据：通道间距 7mm，半个通道以内的位置无法可靠区分方向，
 * 取 0.5cm 略大于半个通道。
 */
#define LINE_SEARCH_MIN_INFO_CM     0.82f   /* =0.5cm(旧标定)×1.643 */

/*
 * 没有任何方向信息时，搜索的【起始方向】。
 *
 * 这【不是】"猜测线往哪边跑了"，而是系统性扫描的起点：
 * 双向扫描会先按这个方向转 LINE_SEARCH_TIMEOUT_MS，
 * 找不到再反向转同样时间 —— 两个方向最终都会覆盖。
 *
 * 所以这个值只影响"先扫到哪一边"，
 * 不影响"能不能找到线"（除非在超时前就该放弃）。
 *
 * 设 +1 先向左，-1 先向右。
 */
#define LINE_SEARCH_DEFAULT_DIR     (-1)

/* ========================================================================= */
/* 场景响应（弯道识别后的动作）                                                */
/* ========================================================================= */

/*
 * 四种场景，各自的响应策略。
 *
 * 判据全部来自 Gray 的 scene 字段（可观测的通道状态），不含推断。
 */

/*
 * ---- ALL：几乎全部通道激活 ----
 *
 * 出现在三种场合：横向黑线、赛道终点标记、传感器悬空（离开赛道）。
 *
 * 【当前设 0：先关掉，等测速时再启用】
 *   关掉之后 ALL 场景只做记录（sc=ALL 仍然可以在串口看到），
 *   不改变车辆行为 —— 车会按正常 PD 继续跑。
 *
 *   这样做的原因：
 *     测速和调循迹参数阶段不希望"某个瞬间全亮"导致车突然停下，
 *     那种停机会掩盖真正的调参效果，也容易误判成故障。
 *
 * 【什么时候改成 1】
 *   等要做"终点自动停车"功能时再开。
 *   启用后注意：赛道上的十字交叉（横向线）也会触发停车，
 *   如果你的赛道有交叉，需要额外用条件区分（目前没有）。
 */
#define LINE_STOP_ON_ALL_BLACK      0

/* 判定 ALL 需要连续多少拍，避免单帧噪声误触发 */
#define LINE_ALL_CONFIRM_CYCLES     4U    /* 80ms */

/*
 * ALL（8 路全黑）+ 已有方向时，即使没进角点事件也满舵转向。
 * 全黑时位置解算失效（e≈0），不接管的话车会按直道全速冲出弯。
 */
#define LINE_ALL_ASSIST_CYCLES      4U    /* 80ms */

/*
 * ---- 角点事件：SIDE（直角）与 FORK（锐角）合并处理 ----
 *
 * 【为什么不再按直角 / 锐角分开处理】
 *   8 路灰度只能看到"某一帧的通道分布"。车走到锐角弯顶点附近时，
 *   同一条黑线会先被探头切成两段（双簇 -> FORK），再随车头前压
 *   并成一片宽黑带（单簇半边占优 -> SIDE），偶尔还会全亮（ALL）。
 *   这三种"场景"是同一个物理事件在不同瞬间的投影，逐帧分类必然
 *   在你一帧我一帧之间来回跳 —— 这就是"直角判断和锐角判断冲突"。
 *
 *   控制器真正需要的只有两件事：
 *       ① 往哪边转（方向，可以锁存）
 *       ② 转多狠（差速限幅 + 减速系数）
 *   所以把 SIDE / FORK 统一成"角点事件"，事件一旦成立就锁存方向、
 *   直到确认出弯才释放。中途无论分类怎么变，转向决策都不再重算。
 *
 * 【调参】
 *   LINE_CORNER_DIFF_BOOST：角点期间允许的差速倍数。越大转得越狠，
 *     但太大会在弯心甩尾。1.35 是当前实车能过的值。
 *   LINE_CORNER_RELEASE_CYCLES：出弯确认拍数，40ms/拍。
 */
#define LINE_CORNER_DIFF_BOOST      1.35f

/* =========================================================================
 * 弯道宽差速（让内侧轮真正停转）
 *
 * 数据（bn，463 样本，按内侧轮状态分组看 3 拍后 |e|）：
 *   内侧反转(<0) : |e| 2.50 -> 1.15
 *   内侧停转(0~5): |e| 2.15 -> 0.90   <- 收益与反转几乎相同
 *   内侧慢转(5~20): |e| 1.90 -> 1.25   <- 就差在这一档
 *   内侧正常(>20): |e| 0.85 -> 1.20
 *
 * 结论：不需要主动反转（TB6612 死区 + 电流冲击），
 *       只要把内侧轮从"慢转"拉到"停转"就能拿到绝大部分收益。
 *
 * 限制：差速上限 35cm/s，车速 55 时内侧轮只能到 20（慢转）。
 * 所以弯道/大误差时把差速上限放宽到 LINE_DIFF_WIDE_LIMIT，
 * 直道仍用 35，避免画龙。
 *
 * 滞回：|e| >= ENTER 才进入宽差速，|e| < EXIT 才退出，
 *       防止直道上一帧抖动就把方向打满。
 * ========================================================================= */
#define LINE_DIFF_WIDE_LIMIT        35.0f   /* ⚠️当前无效：等于基础限幅（br 撤销）*/
#define LINE_DIFF_WIDE_ENTER_CM     2.46f   /* =1.50×1.643（新标定）               */
#define LINE_DIFF_WIDE_EXIT_CM      1.64f   /* =1.00×1.643（新标定）               */
#define LINE_DIFF_WIDE_THETA_RAD    0.30f   /* 或线角超过这个也进入宽差速           */

/* 进入角点事件需要连续多少拍（Gray 已做帧级防抖，这里只需再确认 1 拍） */
/*
 * 角点确认拍数。原来是 1（一拍 SIDE 就进事件），在窄/短赛道上
 * 车身轻微偏移就会不断"进入角点"，实测方向乱跳。
 * 改成 2 拍（80ms）保留响应速度，同时滤掉单拍毛刺。
 */
#define LINE_CORNER_CONFIRM_CYCLES  6U    /* 6×20ms = 120ms */

/*
 * SIDE 场景当作"角点证据"的最小横向误差。
 *
 * 实测：直线/弧线上车身偏 1cm 多，探头阵列就会有一半变黑（SIDE），
 * 这类样本 |e| 中位只有 1.15cm，占 SIDE 的 99%。它们不是真角点，
 * 却会触发角点事件 -> 承诺转向 -> 车越走越摆。
 * 真直角时线压在阵列边缘，|e| 会接近满幅（2.5cm）。
 */
#define LINE_CORNER_TRIGGER_ERR_CM   3.3f    /* =2.0cm(旧标定)×1.643 */

/*
 * Gray 20ms 级 SIDE 锁存的有效期。
 * 外环 40ms 一拍，100ms 内看到过 SIDE 都算数（覆盖 2~3 个外环周期）。
 */
#define LINE_CORNER_LATCH_MS         100U

/*
 * 方向迟滞（2026-10-28 实测：窄赛道里 cd 在 0.2s 内 -1/+1 反复翻，
 * 车被反复告知反向，直接摆到丢线）。
 *
 *   1) 新角点事件开始【不再清零】上一段方向，直接沿用；
 *   2) 反向证据必须连续 N 拍、且距上次锁定 >= HOLD_MS 才允许翻转；
 *   3) commit（承诺转向）期间禁止翻转。
 */
#define LINE_CORNER_DIR_FLIP_CYCLES     6U    /* 120ms */
#define LINE_CORNER_DIR_FLIP_HOLD_MS    250U

/* 连续多少拍回到 LINE 才认为出弯（3 拍 = 120ms，防弯心残留宽黑带误释放） */
#define LINE_CORNER_RELEASE_CYCLES  6U    /* 120ms */

/*
 * 出弯后方向记忆保留多少拍（40ms/拍）。
 *
 * 【为什么需要】
 *   实测锐角弯常见的时序是：SIDE/FORK -> 短暂 LINE -> 立刻丢线。
 *   3 拍 LINE 就释放角点事件，corner_dir 被清零，
 *   丢线时既没有锁存方向、最后位置又接近 0（车正压在弯心），
 *   只能退回默认方向盲扫 —— 猜对猜错各一半。
 *   保留 15 拍（600ms），让"刚出弯就丢线"这种情况还能用上刚才的方向。
 */
#define LINE_CORNER_DIR_HOLD_CYCLES 30U   /* 600ms */

/*
 * ---- 锐角弯的"承诺转向" ----
 *
 * 【问题】（实车日志 17:36:53~54）
 *   V 形锐角的顶点处，车要么转不够角度、要么丢线后立刻"看见"了
 *   自己刚走过的那条腿，于是原地停止搜索、顺着旧线往回跑。
 *   探头扫过旧腿的时间往往只有几十毫秒，按现在的"连续 2 拍确认"
 *   就会把它当成找回来了。
 *
 * 【做法】
 *   如果丢线发生在"锐角证据"（FORK 双簇 / ALL 全黑）的角点事件里，
 *   进入搜索后先闭眼朝锁存方向再转这么久（这段时间内看到线也不算数），
 *   把旧腿扫过去，之后才允许重新捕获。
 *
 * 【取值】
 *   搜索转速 = 24 cm/s 原地转，偏航角速度 (24+24)/16cm ≈ 3 rad/s ≈ 172°/s。
 *     400ms ≈ 69°，加上角点判定前 PD 已经转过的角度，足够越过一条旧腿；
 *   调大：更不容易被旧腿骗到，但直角弯可能转过头；
 *   调小：接近旧行为。
 */
/*
 * ---- 方案 C：用编码器做"定角转弯" ----
 *
 * 时间 ≠ 角度：400ms 的闭眼转弯，实际转过的角度取决于电池电压、轮胎
 * 打滑和地面摩擦 —— 这就是"有时转不够、有时转过头"的来源。
 *
 * 现在用两个编码器的测速积分出偏航角：
 *      yaw += (v_right - v_left) / 轮距 × dt
 * 角点事件里记下起始 yaw，转到目标角度再开始找线。
 *
 * 【LINE_ACUTE_TURN_DEG 怎么定】
 *
 * 关键点：这个角度是从【角点事件发生】开始算的，不是从丢线开始。
 * 事件触发时车还看得见线（SIDE/FORK），到真正丢线时已经转掉一部分，
 * 所以"115° 从事件起点算"换算到车身实际转角，已经接近 V 弯的外角。
 *
 * 实车 A/B（同一赛道，2026-10-25）：
 *   q 版 115°：70 个丢线段，平均 0.96s 找回，最长 2.79s，
 *              61% 在 160° 内找回，0 个反向；
 *   r 版 140°：13 个丢线段，平均 1.62s，最长 5.40s ——
 *              多转的 25° 把出弯腿甩到车后，只能继续扫过头再反向扫回来。
 *
 * 所以默认值退回 115°：承诺转向只负责"把进来那条腿甩开"，
 * 剩下十几度交给同方向的搜索扫过去，边扫边认线，比一次转到底更稳。
 *
 * 调法：看 `[PD] ok xxxms y±deg` 里的 y（本次承诺转向实际转过的角度）——
 *   如果反复出现"y 到了 115 还找不到线" -> 加到 125/130；
 *   如果"转过头、反向扫很久" -> 减到 110。
 */
/*
 * 注意：simple 分支把锐角目标角从 115° 降到 95°。
 * 本分支面向的是"只有弧线/直角"的简单赛道（拱形、方形、椭圆），
 * 这类赛道的角点最多 90°，按 115° 转会转过头、把出弯腿甩到车后。
 * V 形锐角（120~140°）请用 main 分支（那里仍是 115°）。
 */
#define LINE_ACUTE_TURN_DEG          95.0f

/*
 * 承诺转向的兜底超时（ms）。
 * 编码器打滑、轮子被卡住时 yaw 不会增长，靠这个超时退出，防止原地转圈。
 */
#define LINE_ACUTE_COMMIT_TIMEOUT_MS 1500U

/*
 * ---- 直角弯（90°）----
 *
 * 赛道里有 90° 直角（方形地图、拱形赛道的两个底角）时，需要的转角
 * 比 V 形锐角小，只需要 90° 左右。
 *
 * 判定依据：
 *   锐角（V 形）—— 事件里出现过 FORK（两条腿分开）或 ALL（整条全黑），
 *                  按 LINE_ACUTE_TURN_DEG 转；
 *   直角         —— 事件是纯 SIDE（线从一侧滑出），且丢线时横向误差
 *                  已经很大（>= LINE_RIGHT_ANGLE_MIN_ERR_CM），
 *                  按 LINE_RIGHT_ANGLE_TURN_DEG 转。
 *
 * 直角不要转太大：转多了出弯腿会落到车身后方，只能靠反向搜索找回来。
 */
#define LINE_RIGHT_ANGLE_TURN_DEG    90.0f
#define LINE_RIGHT_ANGLE_MIN_ERR_CM  1.97f  /* =1.2cm(旧标定)×1.643 */

/*
 * 角点期间遇到 ALL（整片全黑）时，改用锁存方向满舵。
 *
 * 【原因】
 *   8 路全黑时加权质心必然落在阵列正中，error ≈ 0，
 *   PD 会输出 0 差速 —— 车会"直直地"冲出弯心。
 *   此时位置信息已经没有意义，唯一可靠的是事件开始时锁存的方向。
 *
 * 【安全性】
 *   只在角点事件内生效。直线上的横向黑线（终点标记）不满足
 *   corner_active 条件，行为不变。
 */
#define LINE_ALL_AS_CORNER          1

/*
 * 双向扫描。
 *
 * 【为什么需要】
 *   锐角弯丢线时，车往往已经冲过了弯。此时传感器"最后看到线的方向"
 *   会被过冲主导 —— 比如冲过左弯后线落在车的右侧，
 *   于是搜索往右转，正好是弯道外侧，越转越远。
 *
 *   这不是符号写错，而是"跟着最后位置转"这个启发式在急弯里
 *   原理上就不可靠（过冲量可能大于弯道本身的偏转）。
 *
 * 【做法】
 *   先用锁存方向转 LINE_SEARCH_TIMEOUT_MS；
 *   没找到就换成反方向再转同样长时间；
 *   还没找到才停车。
 *
 *   最坏情况耗时翻倍，但无论初始方向猜对猜错，都能覆盖 360°，
 *   一定能扫到线。对锐角弯这种"猜方向本来就不靠谱"的场景，
 *   用时间来换可靠性是值得的。
 *
 * 设 0 则退回单方向搜索（快但方向可能错）。
 */
#define LINE_SEARCH_BIDIRECTIONAL   1

/* ========================================================================= */
/* 车辆几何                                                                    */
/* ========================================================================= */

/*
 * 左右轮中心距（轮距），单位 cm。实测 16.0。
 *
 * 【用途】
 *   差速 -> 偏航角速度的换算：  omega = (v_right - v_left) / TRACK_WIDTH
 *   搜索转角、弯道所需差速等所有转向推算都基于它。
 *
 * 【为什么必须实测】
 *   曾经按 15cm 估算，导致理论转角比实际大 6%（1200ms 算出 220 度，
 *   实际只有 206 度），调整搜索时间时一直在往上加却总差一点。
 *
 * 【当前几何下的换算表】
 *   纯原地转（外侧 +24 / 内侧 -24）：omega = 48/16 = 3.0 rad/s = 172 度/秒
 *   每拍（外环 40ms）转 6.9 度，这是调搜索时间的粒度。
 *
 *     700ms -> 120 度
 *    1000ms -> 172 度
 *    1160ms -> 199 度
 *    1200ms -> 206 度
 *    1240ms -> 213 度
 *    1360ms -> 234 度
 */
#define LINE_TRACK_WIDTH_CM         16.0f

#define LINE_SEARCH_ENABLE          1

/*
 * 搜索最长时间，单位 ms（双向扫描时是【每一段】的时间）。
 *
 * 【当前取值 1200ms = 206 度】（按实测轮距 16cm 计算）
 *
 *   纯原地转（INNER_RATIO=1.0）的偏航角速度
 *       = (24 + 24) / 16cm = 3.0 rad/s = 172 度/秒
 *   每拍（外环 40ms）转 6.9 度 —— 调整的最小粒度。
 *
 *   演进过程（前几个数值是按错误的 15cm 算的，仅供参考趋势）：
 *      700ms  方向对但角度不够
 *     1100ms  还差约 20 度
 *     1240ms  略多，减 10 度
 *     1200ms  当前，实测（轮距 16cm）约 206 度
 *
 * 【调整方法】
 *   目标转角 D（度） -> TIMEOUT_ms = D / 172 * 1000
 *   只能取到 40ms 的整数倍（6.9 度粒度）。
 */
#define LINE_SEARCH_TIMEOUT_MS      1200U

/*
 * 搜索时的外侧轮速度，单位 cm/s。
 * 太快会转得猛、看不清线；太慢传感器采样时线几乎不动。
 * 10~18 之间比较合适。
 */
/*
 * 搜索时的外侧轮速度，单位 cm/s。
 *
 * 【从 14 提到 24 的原因：扫掠时间占了全部延迟的 90%】
 *
 *   直角弯的时间分解（容差 3 拍、轮距 15cm）：
 *     确认丢线      120ms   ( 10% )
 *     原地扫过 90 度 1086ms  ( 90% )  <- 瓶颈在这里
 *     合计          1206ms
 *
 *   偏航角速度 = (外侧 + 内侧反转) / 轮距
 *     14 cm/s -> 83 度/秒  -> 扫 90 度要 1.09 秒
 *     24 cm/s -> 142 度/秒 -> 扫 90 度只要 0.63 秒
 *
 * 【为什么 24 不会"转太快漏掉线"】
 *   以 142 度/秒算，外环 40ms 一拍转 5.7 度。
 *   传感器 49mm 阵列在约 30mm 距离上对应的张角约 78 度，
 *   扫过它需要约 14 个采样点，完全够传感器反应。
 *
 *   如果确实出现"转过去了但没认出来"，先降到 18~20 试试。
 */
#define LINE_SEARCH_SPEED_CMS       24.0f

/*
 * 搜索时内侧轮的反转比例（相对外侧轮速度）。
 * 0 = 内侧轮不转（绕内侧轮转，半径大）
 * 1 = 内外等速反转（绕自身中心原地转）
 *
 * 取 0.55 让转向中心略微偏向内侧轮，转弯半径小但仍有前进分量，
 * 有利于贴着弯道扫到线。
 */
/*
 * 搜索时内侧轮的反转比例（相对外侧轮速度）。
 *
 *   0    = 内侧轮不转 -> 绕内侧轮转，车会往前跑一大圈
 *   0.55 = 内侧轮半速反转 -> 有小幅前进分量（曾经用这个）
 *   1.0  = 内外等速反向 -> 【绕自身中心原地转】
 *
 * 【为什么改成 1.0】
 *   用 0.55 时，车的中心速度 = (外侧 - 内侧)/2 = (24 - 13.2)/2 ≈ 5.4 cm/s
 *   一直在往前爬。转 1.2 秒就爬出去 6cm 多 —— 正好爬到"身后的那条线"上，
 *   于是车头朝后、线在视野里，就沿着线往回跑了。
 *
 *   改成等速反转后，车绕自身中心旋转，位置基本不动，
 *   只改变朝向，不会无意中碰到别的线段。
 */
#define LINE_SEARCH_INNER_RATIO     1.0f

/*
 * 连续多少个外环周期没看到线，才判定为"真丢线"并进入搜索。
 *
 * 【从 3 降到 2 的原因】
 *   每个周期 40ms，3 拍就是 120ms。
 *   这段时间车仍在按原速前进，弦角弯时已经冲出去好几厘米。
 *   降到 2 拍（80ms）能少冲 40ms 的距离。
 *
 * 【为什么不敢降到 1】
 *   灰度偶尔会有单拍抖动（反光、接缝），1 拍就切搜索会误判，
 *   车会在直道上莫名其妙原地打转。2 拍是安全的下限。
 */
/*
 * 连续丢线多少拍才进入"原地找线"。
 *
 * 历史：2 拍(80ms) 时半圆弯中途偶尔短暂看不到线就立刻原地转，
 * 表现为"弯道中途突然原地转向"。放到 200ms 后解决。
 *
 * 20ms 周期下必须写 10U 才是 200ms —— 写成 5U 只有 100ms，
 * 实测丢线段最长 160ms，会被误触发原地转。
 */
#define LINE_LOST_TOLERANCE         10U

/*
 * 一丢线（还没进入搜索）就把目标速度打这个折扣。
 * 半圆弧上偶尔有短暂看不到线的地方，降速能提高冲过去/重新咬住线的概率。
 */
#define LINE_LOST_SLOW_FACTOR       0.85f

/*
 * 丢线超时后是否停车。
 *
 *   1 = 停车（**初次调试务必用这个**）
 *       丢线就停，车不会冲出赛道，你也能立刻发现"传感器没看到线"。
 *
 *   0 = 继续转向搜索
 *       按灰度模块给出的"最后偏离方向"继续满舵前进，尝试找回线。
 *       适合调试完成后的实跑，但线丢得远时车会一直转圈。
 */
#define LINE_STOP_IF_LINE_LOST      1       /* ⚠️历史遗留：代码已不再引用 */

/* ------------------------------------------------------------------------- */
/* 控制器结构体                                                                */
/* ------------------------------------------------------------------------- */

typedef struct
{
    /* ---- 可调参数 ---- */
    float kp;               /* 比例增益，单位 cm/s 差速量 每 cm 误差          */
    float kd;               /* 微分增益，单位 cm/s 差速量 每 (cm/s) 误差变化率 */
    float base_speed;       /* 基础速度，cm/s                                 */
    float diff_limit;       /* 差速量限幅，cm/s                               */
    float speed_limit;      /* 目标速度限幅，cm/s                             */
    float d_filter;         /* 微分低通系数 (0,1]                             */
    float alat_max;         /* 曲率限速用：允许的最大侧向加速度 cm/s²         */
    uint8_t race_zone;      /* 1 = 已进入终点接近区（限速 + 武装）             */
    float   race_brake_margin; /* 刹车余量 cm，运行时可调（默认 3.0）           */
    uint16_t race_seen;     /* 脉冲被 LinePD 看到的次数（诊断用）              */
    uint16_t race_reject;   /* 看到但被关卡拒掉的次数（诊断用）                */

    /* ---- 运行状态：由 Init/Reset 维护 ---- */
    float   error;          /* 最近一次误差，cm（左正右负）                   */
    float   last_error;     /* 上一次误差，用于求微分                          */
    float   d_filter_state; /* 微分项滤波状态                                 */
    float   steer;          /* 最近一次差速量，cm/s                           */
    float   steer_gain;     /* 大误差增益的滤波状态（1.0 ~ 1+GAIN_MAX）       */
    float   steer_out;      /* 转向输出低通状态，cm/s                         */
    uint8_t wide_steer;     /* 当前是否处于"弯道宽差速"状态（带滞回）         */
    float   speed;          /* 最近一次的目标基础速度，cm/s                   */
    uint8_t straight_ticks; /* 直道连续居中拍数（simple track 直道加速用）             */
    float   speed_boost;    /* 直道加速系数，0 ~ LINE_STRAIGHT_BOOST_MAX              */

    /* ---- 弧线流畅度（线角前馈 + 位置低通）---- */
    float   pos_filter;     /* 低通后的横向位置 cm                                    */
    float   theta_rad;      /* 线在车头下的切线角（rad，低通后）                       */
    float   last_pos_f;     /* 上一拍的滤波位置                                       */
    float   last_dist_cm;   /* 上一拍的两轮平均里程                                   */

    /* 最近 3 个 (位置, 里程) 样本，用最小二乘斜率估 θ，比两点差分抗噪 */
    float   pos_hist[3];
    float   dist_hist[3];
    uint8_t hist_count;

    float   theta_ff;       /* 当前实际叠加的前馈量（经过死区/斜坡/限幅）             */

    /* ---- 比赛自动停车 ---- */
    float   commit_target_deg; /* 本次承诺转向的目标角度（锐角/直角不同）   */
    uint8_t race_enabled;   /* 1 = 自动停车已启用（自适应模式也置 1）                  */
    uint8_t race_phase;     /* 0=等待 1=巡航(已武装) 2=接近 3=已到位                  */
    uint8_t race_pulse;     /* 连续全黑拍数，用来区分"启停线脉冲"和"角点全黑"          */
    float   race_lap_cm;    /* 一圈周长 cm，0 = 关闭自动停车                          */
    float   race_start_cm;  /* 进入循迹时的里程基准                                   */
    float   race_detect_cm; /* 识别到启停线时的里程                                   */

    /*
     * ---- 输出：左右轮的目标速度，cm/s ----
     *
     * 【为什么要在这里存一份，而不是直接调用 Speed_PID_Update】
     *
     *   外环和必须内环跑在不同的周期上：
     *     外环（循迹 PD）  100ms 一次 —— 读传感器、算差速
     *     内环（速度 PID）  20ms 一次 —— 比对编码器、调 PWM
     *
     *   如果外环里直接调 Speed_PID_Update，那么整个系统里
     *   唯一驱动速度环的地方就是外环，速度环也被拖到 100ms，
     *   比设计值慢 5 倍。轮子来不及跟到目标速度，差速就是错的，
     *   循迹会表现为"稍微一点弯就跟不住、直接偏离"。
     *
     *   正确做法：外环只把目标写进这两个字段，
     *   内环节拍每 20ms 读一次并调用 Speed_PID_Update，
     *   两个环各跑各的周期，互不牵制。
     */
    float   left_target;    /* 左轮目标速度，cm/s，由外环写入、内环读取      */
    float   right_target;   /* 右轮目标速度，cm/s                            */
    uint8_t lost_count;     /* 连续丢线周期数                                 */
    uint8_t line_lost;      /* 1 = 本次判定为丢线                             */
    uint16_t search_ms;     /* 已进入搜索状态的累计时间，ms；找到线后清零     */

    /*
     * ---- 搜索方向锁存与趋势判定 ----
     * search_dir    : 进入搜索时锁定的方向（+1 左 / -1 右 / 0 未锁定）
     * recover_count : 连续看到线的周期数，用于确认"真的找回来了"
     */
    int8_t   search_dir;
    uint8_t  recover_count;

    /*
     * ---- 角点事件状态（SIDE 与 FORK 统一处理）----
     *
     * corner_active  : 1 = 正在角点事件中
     * corner_confirm : 进入事件前的连续确认拍数
     * corner_release : 连续回到 LINE 的拍数
     * corner_dir     : 事件内锁存的转弯方向（+1 左 / -1 右 / 0 未定）
     * all_assist     : 上一拍是否处于"全黑满舵"assist 状态（用于抑制微分冲击）
     * all_count      : ALL 场景连续出现拍数（诊断 / 终点确认用）
     * scene_last     : 上一拍的稳定场景，供遥测显示
     */
    uint8_t  corner_active;
    uint8_t  corner_confirm;
    uint8_t  corner_release;
    int8_t   corner_dir;
    /* 方向证据来源：0 = 无，1 = SIDE（哪半边全黑，优先），2 = FORK（另一条腿） */
    uint8_t  corner_dir_src;
    /* 反向证据连续计数 + 上次锁定时刻（方向迟滞用） */
    uint8_t  corner_dir_alt;
    uint32_t corner_dir_flip_tick;
    /* 出弯后方向记忆还剩多少拍（见 LINE_CORNER_DIR_HOLD_CYCLES） */
    uint8_t  corner_dir_hold;

    /*
     * ---- 编码器偏航角（方案 C：定角转弯）----
     * yaw_deg       : 累计偏航角，度；左转为正
     * corner_yaw0   : 角点事件开始时的 yaw，用来算"已经转了多少"
     * last_yaw_tick : 上一次积分的 tick，用来取真实 dt
     * commit_active : 1 = 正在执行承诺转向
     * commit_done   : 1 = 本次搜索已经做过承诺转向（避免重复触发）
     */
    float    yaw_deg;
    float    corner_yaw0;
    uint32_t last_yaw_tick;
    uint8_t  commit_active;
    uint8_t  commit_done;
    int8_t   commit_dir;     /* 承诺转向的方向（锁存时固定，防止中途被清） */
    float    last_commit_turn; /* 上次承诺转向实际转过的角度（度，带符号） */
    /* 本次角点事件是否出现过"锐角证据"（FORK / ALL） */
    uint8_t  corner_acute;
    /* 承诺转向剩余时间 ms（兜底超时，见 LINE_ACUTE_COMMIT_TIMEOUT_MS） */
    uint16_t commit_ms;
    uint8_t  all_assist;
    uint8_t  all_count;
    uint8_t  scene_last;
    /* 本次丢线是否已经打印过 "[PD] lost"（避免每 40ms 打一次，见 LinePD.c） */
    uint8_t  lost_announced;

    uint8_t first_run;      /* 首拍标志，避免微分冲击                         */
} Line_PD_t;

/* ------------------------------------------------------------------------- */
/* 接口                                                                        */
/* ------------------------------------------------------------------------- */

/* 用编译期默认参数初始化，并复位全部运行状态。 */
void LinePD_Init(Line_PD_t *pd);

/* 复位运行状态（清微分历史、丢线计数、输出），参数保持不变。 */
void LinePD_Reset(Line_PD_t *pd);

/* 运行时修改增益。会自动复位，避免旧状态污染新参数。 */
void LinePD_SetGains(Line_PD_t *pd, float kp, float kd, float base_speed);

/*
 * 比赛自动停车。
 *
 *   LinePD_RaceStart(pd, lap_cm)  进入循迹时调用；lap_cm=0 关闭自动停车。
 *                                 内部记录当前里程作为基准。
 *   LinePD_RaceCancel(pd)         离开循迹时调用，取消本次比赛。
 *   LinePD_RaceDone(pd)           返回 1 表示已经到位，调用方应停车。
 *   LinePD_RacePhase(pd)          当前阶段（调试用）。
 */
void    LinePD_RaceStart(Line_PD_t *pd, float lap_cm);

/*
 * 设置刹车余量（cm）：停车判定走 17 − margin 厘米后停车。
 * 可在运行时调（OLED 参数页 MARG，步长 0.5），不需要重进循迹模式。
 */
void    LinePD_SetRaceBrakeMargin(Line_PD_t *pd, float margin_cm);
void    LinePD_RaceCancel(Line_PD_t *pd);
uint8_t LinePD_RaceDone(const Line_PD_t *pd);

/* 自适应模式学到的周长（cm），0 = 还没学到；只用于诊断输出 */
float   LinePD_RaceLearnedLapCm(void);
uint8_t LinePD_RacePhase(const Line_PD_t *pd);

/* 本次比赛已跑里程（cm）= 当前里程 − 起跑里程；停车调试用 */
float   LinePD_RaceTraveled(const Line_PD_t *pd);

/*
 * 核心接口：读一次灰度传感器，做 PD 运算，并把左右轮目标速度写进内环。
 *
 *   pd    : 控制器实例
 *   gray  : 灰度传感器实例
 *   hi2c  : 灰度传感器所在的 I2C 句柄（你的板子是 &hi2c1）
 *
 * 返回值：
 *   LINE_PD_OK         正常
 *   LINE_PD_ERR_I2C    灰度通信失败（本次未更新电机指令）
 *   LINE_PD_ERR_LOST   丢线超时，已按 LINE_STOP_IF_LINE_LOST 处理
 *   LINE_PD_ERR_PERIOD 内外环周期比不合理，拒绝运行（配置错误）
 *
 * 注意：本函数只负责"算"，不负责"等"。请由调用方按 LINE_PD_PERIOD_MS
 *       周期调用它，例如放在主循环的时间戳判断里。
 */
/*
 * 外环计算。
 *
 * 【注意：本函数不再自己读传感器】
 *   传进来的 gray 必须是【调用者刚刚读好】的数据。
 *   这样做的原因：
 *     外环控制律需要 40ms 的周期（保证内环有足够执行时间），
 *     但传感器需要更快的采样（40ms 在 45cm/s 时已经跨过 2.6 个通道，
 *     期间发生的"单侧全黑""瞬间分叉"全都看不到）。
 *
 *   所以把两件事拆开：
 *     20ms 节拍 -> Gray_Update()     采样率 50Hz
 *     40ms 节拍 -> LinePD_Update()   控制律 25Hz
 *
 *   控制律用的数据最多 20ms 旧，比原来"读一次用一次"新鲜了一倍。
 */
uint8_t LinePD_Update(Line_PD_t *pd, Gray_Sensor_t *gray);

/* 停车并复位（内环也会被停止）。 */
void LinePD_Stop(Line_PD_t *pd);

/* 查询接口，供调试和 OLED 显示使用。 */
float   LinePD_GetError(const Line_PD_t *pd);    /* 最近一次误差 cm        */
float   LinePD_GetSteer(const Line_PD_t *pd);    /* 最近一次差速量 cm/s    */
float   LinePD_GetSpeed(const Line_PD_t *pd);    /* 最近一次基础速度 cm/s  */
uint8_t LinePD_IsLineLost(const Line_PD_t *pd);

/*
 * 符号与转向方向验证（**上车跑圈之前必须先做这一步**）。
 *
 * 串级控制能否稳定，完全取决于符号是否自洽：
 *   电机正转 = 前进、编码器前进读数为正、线偏左误差为正
 * 三个环节只要有一个反了，闭环就变成正反馈，车会直接冲出去。
 * 本函数通过两段可观察的测试把这些符号钉死：
 *
 *   interactive = 0  自动模式：只验证误差符号，电机全程不动，安全
 *   interactive = 1  交互模式：额外做转向验证，电机会转动
 *
 * 自动模式的判定方法：手动把线依次放在中心、左侧、右侧，
 * 观察串口打印的 error 符号是否符合"左正右负"。
 *
 * 交互模式的转向验证分两步：
 *   第1步 左轮 0%、右轮 25% —— 车应该**原地左转**（右轮往前推，左轮不动）
 *   第2步 左轮 25%、右轮 0% —— 车应该**原地右转**
 * 若方向相反，说明左右电机的映射或接线反了，必须先修正再跑循迹。
 *
 * 需要轮子架空或留出足够空间，串口波特率 115200。
 */
void LinePD_VerifySigns(Line_PD_t *pd, Gray_Sensor_t *gray,
                        I2C_HandleTypeDef *hi2c, uint8_t interactive);

/*
 * 循迹自检：给定几段目标速度，让车实际跟着线跑，每 100ms 打印
 *   error / steer / 基础速度 / 左右轮目标速度 / 实测速度
 * 用于观察跟随效果和调 Kp、Kd。
 * 函数会持续运行 duration_sec 秒，然后自动停车。
 * 需要把车放在赛道上，串口波特率 115200。
 */
void LinePD_TestSequence(Line_PD_t *pd, Gray_Sensor_t *gray,
                         I2C_HandleTypeDef *hi2c, uint32_t duration_sec);

#endif //LINEFLLOWING_CAR_LINEPD_H
