LUgABeEEE/DK-Line-following-car/Drivers/BSD/Inc/Gray.h

//
// Created by JiangyaF on 2026/10/11.
//
// 幻尔(Hiwonder) 8 路 RGB 灰度巡线传感器驱动
//
// 硬件与协议（依据官方手册 + 原理图）：
//   供电      : DC 5V / 85mA（注意别从 STM32 的 3.3V 引脚取电）
//   I2C 地址  : 0x5D（7 位，固定）
//   检测线宽  : 0.6cm ~ 6.9cm
//   检测高度  : 10mm ~ 40mm（标定与运行时的高度必须一致！）
//
// 寄存器映射：
//   5      全通道数字状态    uint8_t  1 字节，bit0~bit7 = 通道1~8，检测到线 = 1
//   6~21   8 路灰度模拟值    uint16_t 每路 2 字节，低字节在前（6,8,10,...,20）
//   22~37  8 路灰度阈值      uint16_t 每路 2 字节，低字节在前（22,24,...,36）
//
// 重要：模拟量在寄存器 6~21 是物理连续的，一次 I2C 事务就能读完全部 16 字节。
//       阈值同理（22~37 连续）。不要一路一路读，那样既慢又白占总线。
//
// 板载 MCU 已经替我们完成了：一键自学习校准、自动选择最优检测光色、阈值判决。
// 所以本驱动不需要做黑白标定，只需要把阈值读回来用于归一化即可。
//

#ifndef LINEFLLOWING_CAR_GRAY_H
#define LINEFLLOWING_CAR_GRAY_H

#include "main.h"

/* ------------------------------------------------------------------------- */
/* 协议常量                                                                    */
/* ------------------------------------------------------------------------- */

#define GRAY_I2C_ADDR_7BIT      0x5D    /* 7 位地址，HAL 调用时要左移一位        */
#define GRAY_REG_STATE          5U      /* 全通道数字状态，1 字节               */
#define GRAY_REG_ANALOG_CH1     6U      /* 通道 1 模拟值，16 字节连续           */
#define GRAY_REG_THRESHOLD_CH1  22U     /* 通道 1 阈值，16 字节连续             */

#define GRAY_CHANNEL_COUNT      8U      /* 通道数                               */

/*
 * 单次 I2C 事务的超时，单位 ms。
 * 绝对不要用 HAL_MAX_DELAY：模块无响应时会把控制循环卡死。
 * 正常一次读只需不到 1ms，给 5ms 已经很宽松。
 */
#define GRAY_I2C_TIMEOUT_MS     5U

/* 连续读失败多少次就判定传感器掉线，需要由上层做停车保护 */
#define GRAY_FAIL_LIMIT         10U

/*
 * ---- 启停线检测（比赛自动停车用）----
 *
 * 5cm 横线扫过车头时，8 路会同时黑 1~3 拍（20ms 一拍）；
 * 角点/宽黑带会持续更久。按下限拍数 + 脉冲宽度区分。
 *
 * 必须在这里（20ms 采样）做，不能在 40ms 的外环里做：
 * 50cm/s 时 5cm 横线只黑 36ms，外环 40ms 一拍可能整拍漏掉。
 */
/*
 * 启停线识别：靠【空间特征】而不是单纯的通道数。
 *
 * 历史问题：
 *   - 原来阈值取 6，但实测启停线（5cm 横线）最多只能让 5 路灭
 *     （探头间距 11.5mm，5 路需要 46mm，6 路需要 57.5mm > 50mm），
 *     所以启停线【从来没被检测到过】，自动停车一直靠里程兜底。
 *   - 但直接降到 5 也不行：5 路的窗口只有 50−46 = 4mm，
 *     车速 55cm/s 时只有 7ms < 一个采样周期（20ms），大概率漏检。
 *   - 直接降到 4 又会被 90° 拐弯误触发（弯里线散开时也有 4~5 路黑）。
 *
 * 所以改成三判据组合（见 Gray_IsStopBarPattern）：
 *   ① 黑色通道数 >= GRAY_STOP_BAR_CHANNELS（4 路）
 *   ② 黑色必须【连续】                     -> 排除分叉 FORK
 *   ③ 最左和最右通道必须【是白的】          -> 排除直角弯全黑、半边黑的 SIDE
 *
 * 启停线在阵列上的样子是"中间一段黑、两边各留白"，
 * 而直角弯是 8 路全黑、侧边是一侧到边，都被 ③ 排除。
 */
#define GRAY_STOP_BAR_CHANNELS  4U      /* 中间至少几路连续黑 */
/*
 * ⚠️ 本文件所有"按拍数"的常量都随 GRAY_SAMPLE_PERIOD_MS 换算。
 *    采样周期从 20ms 改成 5ms 时，同样的拍数只代表 1/4 的时间，
 *    必须同步 ×4，否则防抖和脉冲宽度判据全部失效。
 *
 * 启停线脉冲宽度上限（拍）。
 *
 * 20ms 采样时代实测脉冲 1~2 拍，取 3 正好；
 * 但 5ms 采样下同样一条 5cm 横线会持续 4~7 拍：
 *     71.5cm/s -> 21.7ms -> 4.3 拍
 *     55cm/s   -> 28ms   -> 5.6 拍
 *     42cm/s   -> 37ms   -> 7.4 拍
 * 仍然取 3 的话，【真实启停线会全部被当成角点丢掉】——
 * 这就是"提高采样率后反而更认不到启停线"的原因。
 * 取 12 覆盖到 30cm/s 以下的慢速，同时角点（全黑/半边黑）本来就不满足
 * Gray_IsStopBarPattern 的三判据，不会被误算进来。
 */
#define GRAY_STOP_BAR_PULSE_MAX 12U     /* 持续超过这么多拍 = 角点，不算启停线 */

/*
 * 灰度采样周期（ms）。
 *
 * 5ms：启停线脉冲窗口只有 15.5mm（55cm/s 时 28ms、42cm/s 时 37ms），
 * 20ms 采样只能抓 1~2 拍，容易整拍漏掉；5ms 能抓 5~7 拍。
 * 采样走 DMA 异步，CPU 不被占用。
 */
#define GRAY_SAMPLE_PERIOD_MS   5U

/* ------------------------------------------------------------------------- */
/* 机械标定                                                                    */
/* ------------------------------------------------------------------------- */

/*
 * 相邻两个探头的间距，单位 mm。
 * 用尺子量 PCB 上两个相邻探头中心孔的距离填进来。
 * 这个值只影响误差的"物理量纲"（厘米），不影响 PD 能不能工作，
 * 但填准了 Kp 才有明确含义（"偏 1cm 修多少 cm/s"）。
 */
/*
 * 相邻两个探头的【中心间距】，单位 mm。
 *
 * 实测：7.0mm（用卡尺量探头中心到中心）。
 * 注意不是"边缘之间的缝隙"，那个是 6mm，要加上探头直径才是中心距。
 *
 * 这个值决定 P 的绝对量纲：
 *   8 路跨距 = 7 × 7 = 49mm
 *   最外侧通道位置 = ±(7 × 3.5) = ±24.5mm
 *   实测线在边缘时 P ≈ ±20.3mm（加权质心不会走到最外侧）
 *
 * ⚠️ 如果换用别的型号传感器，必须重新量这个值，
 *    否则外环 KP 的物理意义就不对了。
 */
/*
 * 通道中心间距，实测 11.5mm（8 路总跨距 80.5mm，与板宽 8cm 吻合）。
 *
 * 历史：这里曾写 7.0f（假设总跨距 4.9cm），导致所有位置读数被
 * 低估 1.643 倍 —— 报出来的 |e|=1.20cm 实际是 1.97cm。
 * 2026-10-30 用尺子实测中心间距 11.5mm 后修正。
 *
 * ⚠️ 改这个值会按比例改变所有"绝对 cm"阈值的物理含义，
 *    必须同步缩放 LinePD.h 里与传感器位置比较的那些常量。
 */
#define GRAY_CHANNEL_PITCH_MM   11.5f

/*
 * 通道顺序方向：
 *   +1.0f = 模块的通道 1 在车的左侧（通道 8 在右侧）
 *   -1.0f = 反过来（模块旋转 180° 安装）
 *
 * 判断方法：装好车后，把黑线放在传感器最左边那个探头下面，
 * 看串口打印的 position 是正还是负。如果是"负"而你希望"左偏为正"，
 * 就把这个值改成相反数。
 */
/*
 * 位置方向系数。
 *
 * 【为什么是 -1】
 *   已确认：
 *     传感器 CH1（LED1）在物理最左侧
 *     MOTOR_A 是物理左轮
 *
 *   位置公式 pos = (i - 3.5) × 间距 × GRAY_DIR_SIGN：
 *     i=0 是 CH1（物理左）  -> 未修正时算得 -24.5mm
 *     i=7 是 CH8（物理右）  -> 未修正时算得 +24.5mm
 *
 *   也就是说默认符号是"左负右正"，而整个工程的约定是"左正右负"
 *   （见 Line_PD_t 里 error 字段的注释，以及 LinePD 的转向推导）。
 *
 *   取 -1 后：
 *     线在车左侧 -> P > 0 -> steer > 0
 *                -> 左轮减速、右轮加速 -> 车左转 -> 朝线靠  ✅
 *     线在车右侧 -> P < 0 -> steer < 0
 *                -> 左轮加速、右轮减速 -> 车右转 -> 朝线靠  ✅
 *
 *   如果取 +1，上面两条都会反过来，表现为"车一偏就朝更偏的方向冲"。
 *   这正是之前"靠近黑线却往反方向转"的原因。
 */
#define GRAY_DIR_SIGN           (-1.0f)

/*
 * 阵列半跨度：最外侧探头到中心的距离，单位 mm。
 * 这同时就是位置解算能达到的最大幅值（线性区之外的饱和值），
 * 外环用它作为误差限幅，两个模块之间的公式只写这一处。
 */
#define GRAY_HALF_SPAN_MM       (GRAY_CHANNEL_PITCH_MM * (float)(GRAY_CHANNEL_COUNT - 1U) * 0.5f)

/* ------------------------------------------------------------------------- */
/* 场景分类                                                                    */
/* ------------------------------------------------------------------------- */
/*
 * 每一帧传感器状态归类成以下场景之一。
 *
 * 物理约定（实测确认）：本模块【越黑数值越大】，所以"看到线"= 通道激活 = 1。
 *
 *   NONE  : 没有任何通道看到线        -> 丢线
 *   LINE  : 1~4 个连续通道            -> 正常循迹
 *   ALL   : 几乎所有通道都激活        -> 横向黑线 / 赛带终点 / 悬空
 *   SIDE_L: 左半边全激活、右半边全无  -> 直角弯（向左）
 *   SIDE_R: 右半边全激活、左半边全无  -> 直角弯（向右）
 *   FORK  : 两段不相连的通道同时激活  -> 锐角弯
 */
/*
 * 场景判据的阈值。
 *
 * 【为什么不能要求"半边全满、另一边全空"】
 *   实测数据：锐角弯时 S=0xF8（通道4~8），左半边有 1 路、右半边 4 路。
 *   如果要求 right==4 且 left==0，永远不成立 —— 场景永远判成 LINE。
 *   所以改用"单边占优"：占优的一边至少 N 路，另一边至多 M 路。
 *
 * 【阈值怎么定】
 *   先用串口的 sc/ln/rt 字段采集真实数据再定，不要凭感觉。
 *   目前的取值基于 8 路传感器的几何：正常循迹最多占 2~3 路，
 *   直角弯会出现一边 4 路、另一边 0~1 路的明显不对称。
 */
#define GRAY_SIDE_DOMINANT_MIN      3U      /* 占优一侧至少这么多路          */
#define GRAY_SIDE_OTHER_MAX         1U      /* 另一侧至多这么多路            */
#define GRAY_ALL_MIN_CHANNELS       7U      /* 判 ALL 至少这么多路激活       */

/*
 * ---- 场景防抖（时间维度的迟滞）----
 *
 * 【要解决的问题】
 *   单个 20ms 采样帧里，"直角"（单簇、半边占优）和"锐角"（双簇）
 *   本来就不是互斥的物理类别：车走到锐角弯的顶点附近时，
 *   黑线会先被 8 路探头切成两段（双簇 -> FORK），
 *   再随着车头继续前压并成一片（单簇宽黑带 -> SIDE），
 *   偶尔还会全亮（ALL）。加上模块自学习阈值在临界点抖动，
 *   逐帧分类就会在 SIDE 和 FORK 之间来回跳 —— 这正是"判断冲突"。
 *
 * 【做法】
 *   分类结果不再逐帧直接生效，而是先做"连续 N 帧一致"的确认：
 *     - 进入角点、退出角点、角点子类型互切，用不同的确认次数
 *     - 丢线（NONE）必须立即生效，不能防抖，否则会拖慢停车/搜索
 *   这样输出给控制器的 scene 在时间上是连续、单调的，
 *   不会出现一帧 SIDE、一帧 FORK 的抖动。
 *
 * 【调参】
 *   采样 20ms/次，所以：
 *     2 次 ≈ 40ms、3 次 ≈ 60ms
 *   确认次数越大越稳，但入弯判断越晚。先按默认值跑，看串口
 *   [L] 行的 sc（防抖后）和 sr（原始）两列，如果 sr 抖得厉害
 *   而 sc 稳定，就说明参数合适。
 */
#define GRAY_CLUSTER_MERGE_GAP       1U   /* 相邻两簇间隔 ≤ 此通道数则合并成一簇 */
/*
 * 场景防抖确认次数（按拍）。
 *
 * ⚠️ 这些也是"按拍数"的常量，随采样周期换算：
 *    原来是按 20ms 采样调的（2/3/3/1 拍 = 40/60/60/20ms），
 *    采样提到 5ms 后同样的拍数只剩 10/15/15/5ms —— 防抖形同虚设，
 *    场景在 LINE/SIDE/ALL 之间乱跳，角点事件被频繁触发，
 *    表现就是【车变抖】。这里统一 ×4 恢复到原来的时间尺度。
 */
#define GRAY_SCENE_CONFIRM_SAMPLES   8U   /* LINE ↔ 角点 的进入/退出确认（40ms） */
#define GRAY_SCENE_RELEASE_SAMPLES   12U  /* 角点 → LINE 的释放确认（60ms）      */
#define GRAY_SCENE_SUBTYPE_SAMPLES   12U  /* 角点子类型互切确认（60ms）          */
#define GRAY_SCENE_LOST_SAMPLES      4U   /* 任意 → NONE（丢线）确认（20ms）     */

enum
{
    GRAY_SCENE_NONE   = 0,      /* 丢线                                          */
    GRAY_SCENE_LINE   = 1,      /* 正常单条线                                    */
    GRAY_SCENE_ALL    = 2,      /* 全部激活：横向线 / 终点 / 悬空                 */
    GRAY_SCENE_SIDE_L = 3,      /* 左半边全黑：直角弯（向左）                     */
    GRAY_SCENE_SIDE_R = 4,      /* 右半边全黑：直角弯（向右）                     */
    GRAY_SCENE_FORK   = 5       /* 分叉：锐角弯                                   */
};

/* ------------------------------------------------------------------------- */
/* 线条相对背景的明暗关系
 *
 *   白底黑线（最常见） -> 线条比背景暗 -> GRAY_LINE_IS_DARK
 *   黑底白线           -> 线条比背景亮 -> GRAY_LINE_IS_BRIGHT
 *
 * 手册里并没有说明模块的归一化约定，所以这里做成可配置的。
 * 判断方法：把传感器放在白底黑线的赛道上，看串口打印的 sum 值
 *   sum 明显 > 0 → 当前设置正确
 *   sum 接近 0   → 改成另一个值
 */
enum
{
    GRAY_LINE_IS_DARK = 0,      /* 白底黑线：默认 */
    GRAY_LINE_IS_BRIGHT = 1     /* 黑底白线 */
};

/*
 * 丢线时的处理策略：
 *   线丢了以后，误差保持不变已经没有意义，这里用一个"记忆值"朝最后
 *   偏离的方向继续打满，让车尽可能转回线上。
 * 这个常量就是丢线时给出的误差幅值（= 最外侧探头的位置）。
 */
#define GRAY_LOST_ERROR_FACTOR  1.0f

/*
 * 判定"丢线"的强度下限。
 *
 * 含义：8 路归一化贡献之和低于这个值，就认为线上没有任何通道，
 * 位置解算无意义，改用"最后偏离方向"的满幅误差。
 *
 * 【为什么从 0.5 降到 0.10】
 *   归一化公式是 (T - A) / T × 修正，即"这一路比阈值暗多少"。
 *   实测数据（线在通道 7 正下方时最强）单路贡献约 0.32，
 *   整条线压在 2~3 路上时总和约 0.76。
 *   但线走到边缘时，只有相邻几路被"轻轻压暗"，
 *   单路贡献只有 0.02~0.03，总和约 0.12。
 *
 *   用 0.5 做门限的话，线一离开正中间就立刻判成丢线，
 *   位置从真实值突跳到 ±35mm，外环 PD 会得到阶跃式的巨大误差，
 *   表现是车到弯道口猛打方向、来回抽。
 *
 *   降到 0.10 后，边缘情况仍能给出有效位置（比如 +19mm），
 *   只有线真的完全离开视野时才判丢线。
 *
 * 【安全性】
 *   纯白背景时所有通道都是 A > T，(T-A) 为负被归零，
 *   总和恒为 0，不会误判成"有信号"。
 *   0.10 对应"某一路至少比阈值暗 10%"，
 *   以 T≈3700 算就是 A < 3330，而白底实测约 3990，
 *   有 660 的安全余量，噪声不会误触发。
 */
#define GRAY_STRENGTH_MIN       0.10f

/* ------------------------------------------------------------------------- */
/* 数据结构                                                                    */
/* ------------------------------------------------------------------------- */

typedef struct
{
    /* ---- 原始数据 ---- */
    uint8_t  state_byte;                        /* 寄存器 5 的原始字节          */
    uint8_t  state_mask;                        /* 同上，语义化别名              */
    uint16_t analog[GRAY_CHANNEL_COUNT];        /* 各通道灰度模拟值              */
    uint16_t threshold[GRAY_CHANNEL_COUNT];     /* 各通道阈值                    */

    /* ---- 解算结果 ---- */
    float    position_mm;       /* 线相对传感器中心的位置，单位 mm，左正右负    */
    float    position_cm;       /* 同上，单位 cm                                */
    /*
     * 控制环专用位置：4 拍 @5ms 滑动平均（≈20ms 平均）。
     * 采样提到 5ms 是为了抓启停线短脉冲；但 LinePD 仍 20ms 跑一次，
     * 直接拿单点位置会让微分项噪声带宽变成 4 倍 —— 实测表现为转向
     * 在 ±30 之间来回打、车抖，进而偏航角速度飙到 300°/s 以上。
     * 这里把控制环看到的位置噪声恢复到"采样 20ms 时"的水平。
     */
    float    position_cm_ctrl;
    float    pos_hist_ctrl[4];  /* 上述平均用的历史                              */
    uint8_t  pos_hist_idx;      /* 历史写指针                                    */
    float    strength;          /* 各通道归一化量之和，用于判断是否看到线        */
    uint8_t  channel[GRAY_CHANNEL_COUNT];       /* 各通道是否看到线（0/1）       */
    uint8_t  active_count;      /* 看到线的通道数                                */

    /* ---- 启停线短脉冲（自动停车）---- */
    uint8_t  stop_pulse;        /* 连续"多路全黑"的采样拍数                       */
    uint8_t  stop_bar_seen;     /* 1 = 刚出现一次短全黑脉冲（启停线候选，待消费）  */
    uint8_t  stop_bar_len;      /* 这次脉冲持续了几拍（采样周期/拍）               */
    uint8_t  stop_bar_state;    /* 触发那次脉冲时的通道状态字节（调试用）          */
    float    stop_bar_pos_mm;   /* 脉冲发生【当时】的位置（不是消费时的那一刻）    */
    uint16_t stop_bar_count;    /* 累计检测到多少次脉冲（不清零，用于统计）        */
    uint16_t dma_fail_count;    /* DMA 传输失败/超时次数（自检与掉线判断用）      */

    /*
     * ---- 场景分类（弯道识别）----
     *
     * 每一帧把 8 路状态归类成一个场景，供外环做离散决策。
     * 这些判据全部来自可观测的通道状态，不含任何推断。
     */
    uint8_t  scene;             /* 防抖之后的场景，控制器用这个              */

    /*
     * ---- 场景防抖状态（见 Gray.h 顶部 GRAY_SCENE_*_SAMPLES 的说明）----
     *
     * 防抖分两级，因为"直角 / 锐角"不是互斥类别，不能要求
     * 同一个子类型连续出现 N 次（真实锐角弯里 SIDE 和 FORK 会交替）：
     *
     *   第一级：场景族 —— NONE / LINE / 角点(ALL|SIDE|FORK)
     *           族切换需要连续确认；角点族的进入只看"是不是角点"，
     *           SIDE 和 FORK 交替也能在 2 帧内确认进入。
     *   第二级：角点内部的子类型 —— 只有连续 N 帧都是同一个子类型
     *           才更新（所以交替抖动时 sc 保持不变，不会来回跳）。
     *
     *   scene_raw      : 本帧未经防抖的瞬时分类，只用于调试对比
     *   scene_fam_cand : 正在确认的候选场景族
     *   scene_hold     : 候选场景族已经连续出现的帧数
     *   scene_sub_cand : 角点内部正在确认的候选子类型
     *   scene_sub_hold : 候选子类型已经连续出现的帧数
     *   scene_init     : 首次上电时直接采纳第一帧，不要求连续确认
     *   scene_flips    : 防抖后场景族的累计切换次数（诊断用）
     */
    uint8_t  scene_raw;
    uint8_t  scene_fam_cand;
    uint8_t  scene_hold;
    uint8_t  scene_sub_cand;
    uint8_t  scene_sub_hold;
    uint8_t  scene_init;
    uint16_t scene_flips;

    /*
     * 分叉时"另一条腿"的方向（+1 左 / -1 右 / 0 无分叉）。
     *
     * 用位置的正负约定（和 position_mm 一致）。
     * 锐角弯时这条信息告诉我们弯往哪边拐 ——
     * 丢线后就朝这个方向搜索，而不是靠猜。
     */
    int8_t   corner_dir;

    /*
     * 20ms 级角点证据锁存（给 40ms 外环用）。
     *
     * Gray 每 20ms 更新一次瞬时场景，而 LinePD 外环 40ms 才读一次。
     * 55cm/s 时一个 90° 角点的 SIDE 窗口可能只有 20~40ms，
     * 外环有可能整拍错过 -> 方向锁不上 -> 到 ALL（全黑）时直着冲出去。
     *
     * 这里在 20ms 采样里记下"最近一次看到哪一侧 SIDE"和时间戳，
     * LinePD 在自己的节拍上取用（见 LINE_CORNER_LATCH_MS）。
     */
    int8_t   side_latch_dir;     /* +1 最近见过 SIDE_L，-1 见过 SIDE_R，0 无 */
    uint32_t side_latch_tick;    /* 最近一次看到 SIDE 的时间戳（ms） */

    /*
     * ---- 场景判据的原始特征 ----
     * 这些是用来验证/标定判据的实数，直接输出到串口，
     * 阈值应该根据它们的实际分布来定，而不是凭直觉。
     *
     *   scene_left     : 左半边（CH1~4）激活路数
     *   scene_right    : 右半边（CH5~8）激活路数
     *   scene_clusters : 连续激活簇的个数
     *   scene_span     : 最大那个簇的跨度（通道数）
     */
    /*
     * 最后一次【真正看到线】时的位置，单位 mm，左正右负。
     *
     * 和 position_mm 的区别：
     *   position_mm  在丢线时会被替换成 ±半跨距 的回退值
     *   last_valid_mm 始终保持最后一次真实测量值，不会被回退值污染
     *
     * 外环丢线后用它判断"线原本在哪一侧"：
     *   只有 |last_valid_mm| 足够大，才说明车确实偏在一边，
     *   这时朝那一侧搜索才有数据依据。
     *   如果它接近 0（一直居中或者从未看到过线），
     *   我们【没有任何信息】判断方向，就不该乱转。
     */
    float    last_valid_mm;

    uint8_t  scene_left;
    uint8_t  scene_right;
    uint8_t  scene_clusters;
    uint8_t  scene_span;

    uint8_t  line_lost;         /* 1 = 丢线（所有通道都没看到线）                */
    uint8_t  line_valid;        /* 1 = 本次位置解算有效                          */
    uint8_t  threshold_loaded;  /* 1 = 阈值已经从模块读回                        */
    /*
     * 连续 I2C 失败次数（成功后清零）。
     *
     * ⚠️ 必须是 uint16：以前是 uint8，连续失败 256 次会回绕成 0，
     * 于是 `fail_count >= GRAY_FAIL_LIMIT` 又变成 false，
     * 上层以为总线恢复了，继续拿【上电时的陈旧数据】开车 ——
     * 长时间跑（或 I2C 被干扰锁死）后出现的"莫名抖动/乱走"就是这么来的。
     */
    uint16_t fail_count;

    /*
     * 累计统计 —— 用于评估硬件健康度。
     *
     * 为什么需要累计值：
     *   fail_count 是"连续失败"，一次成功就清零，看不出长期趋势。
     *   如果模块/走线受过损伤（比如电源反接），常见表现是
     *   "99.9% 的时候正常，偶尔报一次错"——只有累计错误率能反映出来。
     *
     * 判断标准（每次读 2 次 I2C 事务，100ms 一次，约 20 次/秒）：
     *   total_fails / total_reads < 0.1%   -> 健康
     *   0.1% ~ 1%                          -> 需要留意
     *   > 1%                               -> 说明有接触不良或器件损伤
     */
    uint32_t total_reads;       /* 累计读取次数                                  */
    uint32_t total_fails;       /* 累计 I2C 失败次数                             */
} Gray_Sensor_t;

/* ------------------------------------------------------------------------- */
/* 接口                                                                        */
/* ------------------------------------------------------------------------- */

/*
 * 初始化驱动状态。I2C 外设本身由 CubeMX 生成的 MX_I2C1_Init() 负责，
 * 本函数不做硬件初始化，只清零内部状态。
 * 请在 MX_I2C1_Init() 之后调用一次。
 */
void Gray_Init(Gray_Sensor_t *sensor);

/*
 * 发起一次异步 DMA 采样（不等待，上一次没完成就跳过）。
 * 需要在固定节拍（GRAY_SAMPLE_PERIOD_MS）里调用；
 * 采样完成后 Gray_Update() 会消费最新一帧。
 */
void Gray_StartSample(I2C_HandleTypeDef *hi2c);

/*
 * 清掉控制环用的位置滑动平均历史。
 *
 * 必须在每次【进入循迹模式】时调用：
 * 那 4 个历史值是在 Gray_Init（上电一次）里清零的，之后一直带着上一圈
 * 的残留。如果上次停车时线偏在阵列边上（比如 3cm），新一圈的前 4 拍
 * （20ms）会拿这个旧值做平均，PD 一上来就看到一个假的大误差，
 * 微分项直接打出一个大差速 —— 表现就是"有时候一开始就震荡得很厉害，
 * 有时候又很平直"（取决于上次停在哪）。
 */
void Gray_ResetHistory(Gray_Sensor_t *sensor);

/*
 * I2C 出错通知：由 main.c 的 HAL_I2C_ErrorCallback 在 I2C1 出错时调用，
 * 只清内部 busy 标志（内部不调用任何 FreeRTOS API）。
 */
void Gray_NotifyI2cError(void);


/* 设置线条的明暗关系，默认 GRAY_LINE_IS_DARK。 */
void Gray_SetLinePolarity(uint8_t line_is_bright);

/*
 * 从模块强制重新读取一次阈值（16 字节）。重新做过一键校准后调用。
 * 正常情况下不需要手动调用：Gray_Update() 会在首次运行时自动加载。
 */
uint8_t Gray_RefreshThreshold(Gray_Sensor_t *sensor, I2C_HandleTypeDef *hi2c);

/*
 * I2C 总线恢复。
 *
 * 【什么时候需要】
 *   当 HAL_I2C_IsDeviceReady() 一直返回 HAL_BUSY 且
 *   ErrorCode == HAL_I2C_ERROR_TIMEOUT 时，说明 I2C 的 BUSY 标志
 *   永远不释放 —— 也就是 SDA 或 SCL 被某个器件拉在低电平。
 *
 *   常见成因：
 *     - 上电时序不对，从机在 MCU 初始化时正处于半截事务中，
 *       一直把 SDA 拉住，等不到 STOP 就永远不松手
 *     - MCU 复位时从机没有一起复位
 *     - 走线受到干扰，从机状态机跑飞
 *
 * 【恢复原理】
 *   手工给 SCL 打 9 个时钟。从机如果卡在发送第 N 个数据位，
 *   最多 8 个时钟就能把它"走完"，第 9 个用于让它意识到超时。
 *   然后手工产生一个 STOP 条件，从机看到 STOP 就会释放 SDA，
 *   BUSY 标志随之清除。
 *
 * 【调用时机】
 *   Gray_Init() 里会自动调用一次。如果中途又卡死，
 *   可以再调用（比如检测到连续失败超限时）。
 */
void Gray_BusRecovery(I2C_HandleTypeDef *hi2c);

/*
 * 核心接口：读一次传感器并完成全部解算。建议放在外环（循迹环）里调用。
 *
 * 返回值：
 *   0 = 一切正常
 *   1 = I2C 通信失败（本次数据无效，结构体中的位置信息保持上一次的值）
 *   2 = 传感器连续失败次数已达 GRAY_FAIL_LIMIT，判定掉线，上层应停车
 *
 * 内部做了三件事：
 *   1. 一次事务读寄存器 5（数字状态），一次事务读寄存器 6~21（16 字节模拟量）
 *   2. 用阈值把模拟量归一化，在线条方向取正
 *   3. 加权质心求线位置（模拟量算法，误差是连续的，D 项才有意义）
 */
uint8_t Gray_Update(Gray_Sensor_t *sensor, I2C_HandleTypeDef *hi2c);

/* 取线位置，单位 cm，左正右负。丢线时返回带方向的记忆值。 */
float Gray_GetPositionCm(const Gray_Sensor_t *sensor);

/* 取线位置，单位 mm。 */
float Gray_GetPositionMm(const Gray_Sensor_t *sensor);

/* 是否丢线：所有通道都没看到线。 */
uint8_t Gray_IsLineLost(const Gray_Sensor_t *sensor);

/* 是否线在正中间（用于判断可以加速的直道）。 */
uint8_t Gray_IsCentered(const Gray_Sensor_t *sensor, float tolerance_cm);

/*
 * 自检：阻塞约 6 秒，每 200ms 通过 huart2 打印一行
 *   8 路模拟值 / 8 路阈值 / 数字状态位图 / 解算出的 position
 * 用于验证接线、判断通道顺序、确认线条明暗关系、观察丢线行为。
 * 串口波特率 115200。
 */
void Gray_TestSequence(Gray_Sensor_t *sensor, I2C_HandleTypeDef *hi2c);

#endif //LINEFLLOWING_CAR_GRAY_H
