LUgABeEEE/DK-Line-following-car/Drivers/BSD/Inc/OledFont.h

/*
 * OLED ASCII 字体点阵表
 *
 * 本文件由 genfont.py 从厂商例程 oledfont.h 程序化提取生成，请勿手工编辑。
 * 覆盖可打印 ASCII 0x20(' ') ~ 0x7E('~')，共 95 个字符，
 * 下标恒等于 (ASCII码 - 0x20)。
 *
 * 原厂数据说明（不影响点阵内容，仅注释有误）：
 *   - asc2_0806 末尾多一个注释为 "horiz lines" 的非字符条目，已剔除；
 *   - asc2_0806 中反斜杠的注释被笔误写成 "55"（本意 5C），
 *     反引号的注释被误写成 "'"，点阵数据本身正确；
 *   - asc2_1608 中反引号的注释被写成 "|"，点阵数据本身正确。
 *
 * 数据组织方式：每个字符按【列】存放，每列 1 字节，位 0 在【上】。
 *   6x8 : 6 列 x 8 位   -> 每字符 6 字节，占 1 个 page
 *   8x16: 6 列 x 16 位  -> 每字符 16 字节，前 8 字节是上半页，后 8 字节是下半页
 */

#ifndef OLED_FONT_TABLES_H
#define OLED_FONT_TABLES_H

#include <stdint.h>

/* 6x8 点阵，每字符 6 字节 */
static const uint8_t oled_font_6x8[95][6] =
{
    { 0x00, 0x00, 0x00, 0x00, 0x00, 0x00 },   /*  0  0x20  'sp' */
    { 0x00, 0x00, 0x00, 0x2F, 0x00, 0x00 },   /*  1  0x21  '!' */
    { 0x00, 0x00, 0x07, 0x00, 0x07, 0x00 },   /*  2  0x22  'dquote' */
    { 0x00, 0x14, 0x7F, 0x14, 0x7F, 0x14 },   /*  3  0x23  '#' */
    { 0x00, 0x24, 0x2A, 0x7F, 0x2A, 0x12 },   /*  4  0x24  '$' */
    { 0x00, 0x62, 0x64, 0x08, 0x13, 0x23 },   /*  5  0x25  '%' */
    { 0x00, 0x36, 0x49, 0x55, 0x22, 0x50 },   /*  6  0x26  '&' */
    { 0x00, 0x00, 0x05, 0x03, 0x00, 0x00 },   /*  7  0x27  'quote' */
    { 0x00, 0x00, 0x1C, 0x22, 0x41, 0x00 },   /*  8  0x28  '(' */
    { 0x00, 0x00, 0x41, 0x22, 0x1C, 0x00 },   /*  9  0x29  ')' */
    { 0x00, 0x14, 0x08, 0x3E, 0x08, 0x14 },   /* 10  0x2A  '*' */
    { 0x00, 0x08, 0x08, 0x3E, 0x08, 0x08 },   /* 11  0x2B  '+' */
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
    { 0x00, 0x02, 0x02, 0x7C, 0x80, 0x00, 0x00, 0x00, 0x00, 0x40, 0x40, 0x3F, 0x00, 0x00, 0x00, 0x00 },   /* 93  0x7D  '}' */
    { 0x00, 0x00, 0x00, 0x00, 0x00, 0x00, 0x00, 0x00, 0x00, 0x00, 0x00, 0x00, 0x00, 0x00, 0x00, 0x00 },   /* 94  0x7E  '~' */
};

#endif /* OLED_FONT_TABLES_H */
