LUgABeEEE/DK-Line-following-car/(commit log)

2026-10-22 初始化：STM32F103 循迹小车（CubeMX + FreeRTOS + CMake）
2026-10-22 修改蓝牙模块：HC-05 驱动 + 添加蓝牙FreeRTOS 任务
2026-10-22 FreeRTOS-OLED显示任务
2026-10-23 电机驱动验证完成
2026-10-23 chore: 导入 STM32F103 循迹小车工程（CubeMX + FreeRTOS + CMake）
    - Core: CubeMX 生成的时钟/GPIO/I2C/TIM/UART/USB 初始化
    - Drivers/BSD: TB6612 驱动、编码器测速、速度环 PID、8 路灰度、循迹 PD、OLED/蓝牙/按键/LED
    - USER: FreeRTOS 任务层（控制任务 20ms/100ms、蓝牙任务、OLED 任务）
    - FreeRTOS: 内核源码（Cortex-M3 端口，heap_4）
    - 保留 CLion/CMake 预设与 CubeMX 工程文件
2026-10-23 docs: 补充工程说明、引脚映射、调试标定流程与底板原理图
    - README: 硬件构成、软件架构、引脚映射、编译烧录、标定顺序、N20 换型要点、已知问题
    - docs: 小车控制底板 V1.0 原理图 PDF
2026-10-23 feat(encoder): 改为按「轮子转一圈的计数」标定，适配 N20 电机
    - Encoder.h: 用 ENCODER_COUNTS_PER_WHEEL_REV 替代 PPR×倍频×减速比，
    换电机只需手转一圈量一个数；保留公式写法说明
    - Encoder.h: 机械参数按 N20-6V + 43mm 轮给出占位值（2800 / 43.0），待实测核对
    - Encoder.h: 注释标出 TIM3/TIM4 预分频不一致的已知问题
    - PWM.h: 注明 6V 电机 + 7.4V 电池的占空比换算（81% = 额定 6V）
    [Encoder.h, PWM.h]
2026-10-23 docs: 补充 N20 适配章节（电压换算、标定方法、KFF/base_speed 参考表）
2026-10-23 内环PID完成
2026-10-24 外环PID完成,速度环调试完成
2026-10-24 WIP: 分叉检测与急弯预警(未验证, 保留备用)
2026-10-24 确认可用版本: 外环循迹完成(钝角可过, 直角有搜索挽救)
    符号链修正:
    - GRAY_DIR_SIGN = -1 (CH1在物理最左)
    - LINE_STEER_REVERSE = 0 (差速方向正确)
    架构修复:
    - 内外环解耦: 速度环恢复50Hz, 外环40ms独立运行
    - 外环周期 100ms -> 40ms (提速关键)
    - 丢线时清零目标速度, 修复判断丢线却继续跑
    循环与保护:
    - 外环软启动斜坡 (LINE_SPEED_RAMP_CMS_PER_SEC)
    - 丢线搜索状态机: 原地转向 + 1200ms 超时兜底
    - 搜索速度 14 -> 24 cm/s (扫掠快41%)
    - 丢线容差 3 -> 2 拍
    参数标定:
    - 编码器: 2倍频, 减速比1.0, 标定0.97, A轮0.995
    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
    [Gray.c, Gray.h, LinePD.c, LinePD.h]
2026-10-25 提高采样频率: 传感器20ms采样与控制律40ms解耦, I2C1提到400kHz
    问题: 45cm/s时每拍移动18mm, 跨过2.6个通道间距(7mm),
    直角弯的'单侧瞬间全黑'和锐角弯的'瞬间分叉'被漏采.
    改动:
    - Gray_Update 从 LinePD_Update 内部移到 ControlTask 的20ms节拍
    采样率 25Hz -> 50Hz, 控制律仍40ms
    - LinePD_Update 去掉 hi2c 参数, 改为检查 fail_count 判断数据新鲜度
    - I2C1 100kHz -> 400kHz, 单次读取 1.98ms -> 0.49ms
    - .ioc 同步: I2C1/I2C2 显式写 ClockSpeed=400000 + IPParameters 含 ClockSpeed
    (避免CubeMX重新生成时被默认值覆盖)
    另外:
    - 搜索改为纯原地转(INNER_RATIO 1.0), 不再边转边爬
    - 搜索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
    [Ble_task.c, Control_task.c, LinePD.c, LinePD.h, linefllowing_car.ioc, main.c]
2026-10-25 场景识别 + 修正搜索方向的默认猜测
    1. 场景分类 (Gray):
    - NONE/LINE/ALL/SIDE_L/SIDE_R/FORK 六种场景
    - 判据改为'单边占优'(占优侧>=3路, 另一侧<=1路),
    原来要求'半边全满且另一边全空', 真实数据不可能满足, 导致永远判 LINE
    - 暴露原始特征 scene_left/right/clusters/span + last_valid_mm 便于核对
    - ALL 停车暂时关闭 (LINE_STOP_ON_ALL_BLACK=0), 测速用
    2. 场景响应 (LinePD):
    - ALL -> 记录 sc=ALL, 不停车 (开关关闭)
    - SIDE -> 减速45% + 差速限幅放宽到 1.35 倍
    - FORK -> 记录 corner_dir, 丢线时优先用它决定搜索方向
    3. 搜索方向 (去猜测):
    - 分支1: 分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
    [Ble_task.c, Gray.c, Gray.h, LinePD.c, LinePD.h]
2026-10-25 [VER] 改为每次连接都打印 + 版本升到 e
2026-10-25 feat: 同步实车调参版本（场景识别 / 丢线搜索 / 分轮标定 / 遥测）
    编码器
    - PSC 两路统一为 49（原先 TIM4=0、TIM3=49，左右轮相差 50 倍）
    - 实测标定：轮径 48mm、倍频 2、减速比 1.0、CALIBRATION 0.97
    - 新增分轮修正 ENCODER_A_FIX/B_FIX 与运行时 Set/GetFix
    灰度
    - I2C1 提速到 400kHz 并启用 DMA 接收，新增总线恢复 Gray_BusRecovery
    - 场景识别：单线 / 全黑 / 左直角 / 右直角 / 分叉 / 丢线
    - 探头间距改为实测 7mm，方向系数 -1
    外环
    - 周期 100ms -> 40ms，Kp 8->20，Kd 3->1，差速限幅 25->35，限速 60->75
    - 新增丢线双向扫描搜索（1.2s 超时、24cm/s）、侧向减速、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
    [Ble_task.c, Control_task.c, Control_task.h, Encoder.c, Encoder.h, Gray.c, Gray.h, LinePD.c]
2026-10-25 docs: 按实车标定结果更新 README（机械参数、分辨率、外环参数、赛道路径能力）
2026-10-25 fix(encoder): 编码器预分频 49->0，恢复四倍频分辨率
    编码器模式下 PSC 是对编码器边沿分频的，49 等于每 50 个边沿才计 1 个数：
    20ms 窗口下 1 个计数 ≈ 28 cm/s，30 cm/s 时每窗口只有 1 个计数。
    - main.c / .ioc: TIM3、TIM4 的 Prescaler 由 49 改为 0
    - Encoder.h: EDGE_MULTIPLIER 2->4（原先填 2 是为了凑上被分频后的观测值）
    - Encoder.h: GEAR_RATIO 1.0->25.0（名义值，13x4x25=1300，与 26x50 对齐）
    - 换算后 ~1300 计数/轮转、0.1125 mm/计数；mm/计数 未变，
    CALIBRATION 0.97 无需重标，速度读数应与改动前一致
    - 注释同步：分辨率、采样窗口、分轮标定、已知问题
    [Encoder.h, linefllowing_car.ioc, main.c]
2026-10-25 sync: 对齐 DK-Line-following-car@eff4e6c，并修复 Debug 构建溢出
    从 GitHub 拉取 DK-Line-following-car（main = eff4e6c），把本地工程同步到该仓库
    最新状态：
    - 编码器 TIM3/TIM4 预分频 49 -> 0（main.c 与 .ioc 同步修改），恢复四倍频分辨率
    - Encoder.h 按 PSC=0 重算：EDGE_MULTIPLIER 2->4、GEAR_RATIO 1.0->25，
    约 1300 计数/轮转、0.1125 mm/计数
    - 补上 README.md（硬件构成 / 引脚映射 / 标定流程 / N20 实测数据）与
    docs/ 底板原理图 PDF
    - .gitignore 补齐 .vscode、*.ioc.bak、.DS_Store 等
    - 一并纳入此前未提交的改动：LinePD 丢线搜索方向锁存修复（先判断再计时）、
    轮距 16cm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
    [Ble_task.c, Encoder.h, LinePD.c, LinePD.h, linefllowing_car.ioc, main.c]
2026-10-25 fix(corner): 角点判断改为「场景族防抖 + 事件锁存」，消除直角/锐角来回跳
    现象：锐角弯里 Gray 的 scene 在 SIDE（直角）和 FORK（锐角）之间抖动，
    LinePD 逐帧切换策略 —— 差速放大系数、分叉门控、搜索方向都跟着翻，
    车在弯心表现为抽搐、方向乱翻。
    根因：
    - 单帧分类里 SIDE / FORK / ALL 不是互斥类别，是同一个角点在
    不同瞬间的投影（折线先被切成两簇，再并成一片，再全亮）
    - 逐帧直接生效、没有时间确认；一条线中间断一路就会被判成双簇 FORK
    - LinePD 每帧都能覆盖 corner_dir，side_count 一离开 SIDE 就清零
    改动：
    Gray.c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
    [Ble_task.c, Gray.c, Gray.h, LinePD.c, LinePD.h]
2026-10-25 feat(tools): 增加 HC-05 SPP 遥测采集 / 解析 / 统计脚本
    BlueZ 5.65 之后移除了 rfcomm / sdptool，Arch 的 bluez-utils 5.87 里已经
    没有 rfcomm 命令，网上 "sudo rfcomm bind" 的教程在这台机器上不可用。
    这里直接用 Python 的 AF_BLUETOOTH + BTPROTO_RFCOMM 连 HC-05，
    不需要 rfcomm、不需要内核 tty 节点，配对仍用系统自带 bluetoothctl。
    新增 tools/：
    - bt_serial_capture.py 两种连接方式（RFCOMM 直连 / 已有 tty），
    断线自动重连，边采边落盘：原始 .log +
    loop/speed/gray/scene 四个 CSV，每行 flush，
    AI 可在采集过程中直接读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
2026-10-25 fix(ble): 遥测行不再被 50ms 发送超时截断，构建标记 j -> k
    实车抓包（HC-05, 9600 8N1）发现：每一行 [L] 都在 "sr" 处断掉，
    后面的 [A] 直接被拼到同一行：
    [Lj] STOP e0.0 s0.0 L0.0 R0.0 sd+0 sc=NONE cd+0 sr[A] t0.0 m0.0 ...
    22 行 [L] 全部截断，完整行 0 行。原因是 HAL_UART_Transmit 的 50ms
    超时：9600 下 1 字节约 1.04ms，[L] 行现在 60 字节要约 62ms，
    而 50ms 只能发出 48 字节 —— 正好断在 "sr" 后面。
    改动（USER/Src/Ble_task.c）：
    - 新增 BLE_TX_TIMEOUT_MS = 250U，替换本文件所有 50U / 100U 发送超时
    - 内环 [A]/[B] 从 5Hz 降到 2.5Hz（隔一次发一次）：
    三行同时 5Hz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
    [Ble_task.c]
2026-10-25 fix(pd,ble): 控制任务打印不再阻塞/截断，[L] 提到约 5Hz，角点方向按 SIDE 证据优先
    实车 46s 日志（logs/capture.log，LINE 模式 17:12:31~17:13:17）暴露三个问题：
    1) 控制任务里的打印既阻塞又被截断
    "[LinePD] line lost, stop" 27 字节，9600 下要 28ms，而发送超时只有 20ms：
    - 丢线时每 40ms 控制周期打印一次，占掉控制环约 70% 的时间
    - 每行都在 "s" 处截断，和 [L] 行粘成 "[LinePD] line lost, s[Lk] ..."
    改为 "[PD] lost"，每次丢线只打一次（lost_announced 标志），超时 40ms；
    搜索成功的 "search ok" 也缩短为 "[PD] ok %ums"。
    2) 遥测太慢
    BLE 任务 100ms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
    [Ble_task.c, Ble_task.h, LinePD.c, LinePD.h, bt_serial_capture.py]
2026-10-25 feat(pd): 出弯方向记忆 600ms + 锁存方向与实测位置冲突时信实测（构建 m）
    上一段实车数据（logs/capture.log, 46s, LINE）里有两处典型失败：
    - 17:12:35：角点事件释放 3 拍后就丢线，corner_dir 已被清零，
    而最后有效位置又接近 0（车正压在弯心）-> 没有任何方向信息，
    只能按默认方向盲扫
    - 17:12:57：sc=SIDE_L（左半边全黑）却锁存 cd=-1，且 last_valid=+2.2cm
    也明确在左 -> 按锁存方向往右扫，1.2s 后才反向
    改动（Drivers/BSD/Inc/LinePD.h + Src/LinePD.c）：
    - corner_dir_hold：角点事件释放后方向再保留 15 拍（600ms），
    衰减到 0 才清除；新角点事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
2026-10-25 tune(pd): 搜索方向冲突阈值 1.2 -> 1.0cm；README 补充实测调参依据
    实车日志（logs/serial_20261025_172300.log，LINE 54s、290 拍、5.6Hz）分析：
    - 12 次进入搜索里有 5 次的锁存方向和丢线前实测误差相反，
    其中 2 次的偏差是 1.1cm —— 原来的冲突阈值 1.2cm 恰好漏判，
    降到 1.0cm 后在"出弯方向记忆 600ms"的配合下能覆盖这些情况
    - 内环：目标 15~35 cm/s 时占空比/实测速度 A=1.35、B=1.87，
    KFF=1.0 明显偏低（30 cm/s 需要 40%/56% 占空比），m 长期比 t 低 2~7；
    B 轮输出常打到 70~100% 仍不达标
    - 外环：循迹段 steer 符号翻转占 58%、|steer|>=30 占 14%，
    是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
2026-10-25 fix(pid): 目标反向时清零积分，修复"原地右转"失效、搜索扫不到线（构建 n）
    实车日志（m 版，17:32:27.8）里的关键证据：
    [B] t-24.0 m-3.1 o-18.5 i+22.2
    B 轮被要求反转 24 cm/s，但积分还背着上一段前进攒下的 +22，
    输出只剩 -18%，实际只有 -3.1 cm/s —— 几乎不动。
    于是 LinePD 的"原地右转搜索"实际变成"左轮前进、右轮不动"，
    车在平移而不是旋转，怎么扫都扫不到线，2.4s 后超时停车。
    这趟 LINE 模式 112s 里，80s 是停着的（两次 63s / 17s）。
    - 积分分离阈值 20 cm/s：目标从 +24 跳到 -24 时误差约 48 > 20，
    积分被冻结，想卸也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
    [Ble_task.c, SpeedPID.c, SpeedPID.h]
2026-10-25 feat(pd): 锐角丢线后"承诺转向"，搜索不再被实测位置拉回（构建 o）
    实车日志（17:36:53~54，m 版）复现了"转不够 / 方向不对 / 跑回旧赛道"：
    FORK cd+1 -> ALL 满舵左转 -> 丢线 -> 搜索却选了右（sd=-1）
    原因有两个：
    1. m/n 版改的"一致性检查"是反效果：车在锐角转过头后，last_valid
    会指回刚走过的那条腿，按它修正方向 = 主动把车送回走过的赛道
    2. V 顶点处探头扫过旧腿只有几十毫秒，连续 2 拍确认足以误判
    "找回来了"，然后顺着旧线往回跑
    - 角点事件内的搜索方向一律信锁存方向，删除与实测位置的一致性检查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
    [Ble_task.c, LinePD.c, LinePD.h]
2026-10-25 feat(pd): 方案 C —— 编码器差分里程计 + 锐角定角转弯（构建 p）
    把"闭眼转 400ms"换成"转到目标角度"：
    时间 ≠ 角度，同样 400ms，电池电压、轮胎打滑、地面摩擦不同，实际转角
    能差出几十度 —— 这正是"有时转不够、有时转过头"的来源。
    实现（Drivers/BSD/Src/LinePD.c + Inc/LinePD.h）：
    - yaw 积分：yaw += (v_right - v_left) / 轮距 × dt
    dt 用 HAL_GetTick 的真实间隔（外环被高优先级任务推迟时按名义 40ms
    会系统性少算角度）
    - 角点事件开始时记录 corner_yaw0，并清 commit 状态
    - 锐角事件进入搜索时触发承诺转向：commit_dir 锁存方向（避免中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
2026-10-25 fix(gray,rtos): 修 fail_count 回绕导致的"假恢复"，打开栈/堆保护并新增 [M] 诊断行（构建 q）
    针对"长时间运行后开始抖"做了计数/内存审计：
    1) 真 bug：Gray_Sensor_t.fail_count 是 uint8_t 且自增无上限。
    连续 I2C 失败 256 次后回绕成 0，`fail_count >= GRAY_FAIL_LIMIT` 又变 false，
    LinePD 以为总线恢复，继续用陈旧数据开车 —— 表现为跑一段时间后莫名抖动/乱走。
    改为 uint16_t 并做 0xFFFF 限幅。
    2) FreeRTOS 保护原本全关（configCHECK_FOR_STACK_OVERFLOW=0 /
    configUSE_MALLOC_FAILED_HOOK=0），栈溢出和堆失败都是静默内存破坏。
    现在：
    - configCHECK_FOR_STA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
    [Ble_task.c, Ble_task.h, Control_task.c, Control_task.h, Gray.c, Gray.h, Oled_task.c, Oled_task.h]
2026-10-25 tune(pd): V 弯目标角度 115->140°，承诺转向实际角度进日志，BLE 栈加一档（构建 r）
    实车分析（q 版，2026-10-25 18:36~18:40，1108 拍 LINE、53 个角点事件）：
    - [M] 诊断行全程稳定：heap 5328 不变、stkC 752 / stkO 1160 / stkB 344、
    i2c 0 失败 —— 排除内存泄漏 / 栈增长 / I2C 劣化
    - 角点时刻内环积分只有 0.1~5.3（限幅 ±40），外环本身无积分 —— 排除积分饱和
    - 丢线后重新找到线时的 yaw 增量：成功样本 130~145°，
    失败样本 180~400°（115° 转完没对上出弯腿，搜索扫过头、顺着旧腿返回）
    - 早期角点成功率 88%、晚期 59%：随电量/滑移/胶带状态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
2026-10-26 feat(ui,ble): 循迹模式 + MODE 页短按 KEY2/KEY1 打 [T] OK/FAIL 跑圈标记（构建 s）
    需求：循迹运行中无法切模式，唯一出口是长按 KEY2 停车。利用这两个键
    给"刚跑完的这一段"打成功/失败标记，分析日志时按标记切段，不用猜。
    实现：
    - Control_task：记录按下/长按状态；松手时若为短按、且【按下瞬间】已是
    循迹模式 + MODE 页，则 KEY2 -> BleTask_SendTag(1)、KEY1 -> SendTag(0)。
    用按下瞬间的状态判定，避免"从 STOP/SPD 切进循迹"的那一次按键误打标。
    - Ble_task：新增 8 深度标记队列（xQueueCreate），控制任务只入队，
    由蓝牙任务统一打印 "[T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
    [Ble_task.c, Ble_task.h, Control_task.c, Oled_task.c, Oled_task.h, serial_proto.py, tag_report.py]
2026-10-26 tune(pd): 锐角承诺转向目标角退回 115°（构建 t）
    用户反馈 q 版（115°）对锐角处理更好，逐条对比 q/r 的日志后确认：
    q 与 r 在锐角逻辑上【只差这一个常数】（115 -> 140），其余是日志字段和栈大小。
    同一赛道实车数据（2026-10-25）：
    q(115°)：70 段丢线，平均 0.96s 找回、最长 2.79s，61% 在 160° 内找回，0 反向
    r(140°)：13 段丢线，平均 1.62s、最长 5.40s
    原因：这个目标角是从【角点事件发生】算起，事件触发时车还看得见线，
    到丢线时已转掉一部分；115° 转完还差十几度，由同方向的搜索边扫边认线补上，
    不会把出弯腿甩到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
2026-10-26 feat(simple-track): 简单赛道速度规划——曲率深度降速 + 直道加速 + 角点限速
    针对只有弧线/直角的简单赛道单独开分支做速度与稳定性优化，
    锐角承诺转向（115°）保持不变。
    速度规划（LinePD.c 第 6 步，替换原来"只按 |error| 线性减速"）：
    - 曲率深度 depth = 0.60*|error|/err_max + 0.40*|steer|/diff_limit
    （直接用差速需求，转向比误差更早饱和，等于提前量）
    - 入弯预判：|d(error)/dt| 换算成深度，取 max，进弯前就开始减
    - 角点事件期间速度再压到 <= LINE_CORNER_SLOW_MAX(0.72)
    - 直道加速：连续 5 拍 |error|<0.35cm 且 |steer|<8cm/s，每拍 +3%，
    最多 +2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
    [LinePD.c, LinePD.h]
2026-10-26 chore: simple-track 分支构建标记 t -> u（区分 main 的 t 固件）
2026-10-26 docs: 分支名统一为 simple（原 simple-track）
2026-10-26 ci: 添加 GitHub Actions 构建流水线
    - firmware: Debug / Release 两种预设都编一遍，产出 elf/hex/bin 并上传，附 arm-none-eabi-size
    - tools: python -m compileall 检查遥测脚本语法
    - 推送 main/simple、PR、手动触发都会跑；同一 ref 连续推送取消旧任务
2026-10-26 feat(pd): 简单赛道速度档位（3 档）+ [VER] 标记当前档位
    - LinePD.h: 新增 LINE_SIMPLE_PROFILE（0 保守 / 1 均衡 / 2 激进），整组切换
    基础速度 26/30/34、直道加速 +15/25/35%、角点限速 0.65/0.72/0.82、
    入弯预判 0.80/0.70/0.60、减速斜坡 2.5×/2.0×/1.6×；
    只动速度规划，Kp/Kd/差速限幅不变，默认档位与改动前完全一致
    - Ble_task: [VER] 行输出 P0/P1/P2，构建标记 u -> v
    - README: 补赛道档位表、CI 说明与状态徽章
2026-10-26 ci: 添加 GitHub Actions 构建流水线
    - firmware: Debug / Release 两种预设都编一遍，产出 elf/hex/bin 并上传
    - 推送 main/simple、PR、手动触发都会跑
    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
2026-10-26 docs: README 补 CI 说明与构建状态徽章
2026-10-26 ci: 固定 runner 为 ubuntu-24.04
    ubuntu-latest 从 2026-10-19 起开始迁到 Ubuntu 26，工具链包名/版本可能变；
    固定 LTS 保证 arm-none-eabi-gcc 版本可预期，升级时显式改这一行。
2026-10-26 ci: 固定 runner 为 ubuntu-24.04
    与 main 同步：ubuntu-latest 从 2026-10-19 起开始迁到 Ubuntu 26，工具链版本不可预期。
2026-10-26 ci: 推 v* tag 时自动发 Release（带 hex/bin/elf 与自动变更列表）
    - build.yml: on.push 增加 tags: ['v*']
    - 新增 release job（needs: firmware，仅 tag 触发，contents: write）
    * 从 BLE_BUILD_TAG 读固件构建标记，写进 Release 标题
    * 变更列表自动取「上一个 tag..当前 tag」，首个 tag 退化到最近 15 条
    * Release 已存在时覆盖附件与说明，重复推同一 tag 不失败
    - README 4.2: 发版用法
2026-10-26 ci: 推 v* tag 时自动发 Release（与 simple 同步）
    - build.yml: on.push 增加 tags: ['v*']，新增 release job
    * 标题带 BLE_BUILD_TAG，变更列表自动取上一个 tag..当前 tag
    * Release 已存在时覆盖附件，重复推 tag 不失败
    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
2026-10-26 fix(ui): 成功标记改为长按 KEY3，避免停车长按 KEY2 时误触发（构建 v）
    现象：循迹中停车要长按 KEY2，而按下 KEY2 的瞬间和一次短按在按键事件层
    无法区分，容易在停车时多打一个 [T] OK，把失败的一圈记成成功。
    - Control_task：成功标改为【长按 KEY3】时发送 [T] OK；
    短按 KEY2 不再打标；长按 KEY2 仍是急停；短按 KEY1 仍是 [T] FAIL。
    - Oled_task：循迹运行中、MODE 页锁住 KEY3 切页，否则按住 KEY3 会先切页
    再打标，标记会落在别的页面；要换页面请先停车。
    - 模式页提示改为 "K1 FAIL HOLD K3 OK"，打过标显示 "#n"。
    - README 5.6 同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
    [Ble_task.c, Control_task.c, Oled_task.c]
2026-10-26 feat(race): 一圈自动停车——启停线识别 + 17cm 定距 + 减速停（构建 w）
    规则要求跑完一圈停在启停线，测试点偏差 ≤2cm 才有 P=1.0；
    之前只能手按长按 KEY2 停车，误差通常 3~8cm。
    几何（实测）：灰度条中心 -> 后轮轴中点（测试点）= 17cm，轮距 16cm。
    起跑时把后轮轴中点对准起跑线，则：
    跑完一圈时灰度条先压到启停线（测试点还差 17cm），
    再直行 17cm，测试点正好落在启停线中轴线上。
    - LinePD 增加比赛阶段机 0=等待 1=巡航(武装) 2=接近 3=到位：
    * 跑过半圈才武装，避免起跑线/杂线误触发；
    * 启停线判定 = 8 路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
2026-10-26 refine(ui): 取消 KEY3 锁页，长按打标后自动退回 MODE 页（构建 x）
    上一版为了防止“按住 KEY3 先切页再打标”，把循迹中的 KEY3 切页锁住了。
    实测这个限制没必要：长按 KEY3 打标后把页面退回 MODE 页即可。
    - Oled_task：恢复 KEY3 正常切页（去掉锁页逻辑）；
    新增 OledTask_SetModePage()，由控制任务在打标后调用，把页面切回 MODE。
    - Control_task：长按 KEY3 在循迹模式下随时可用（不再要求按下时在 MODE 页），
    发 [T] OK 后调用 OledTask_SetModePage() 退回 MODE 页；
    短按 KEY1 的失败标、长按 KEY2 的停车逻辑不变。
    - MODE 页提示改为 "K1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
2026-10-26 feat(pd): 直角弯（90°）承诺转向 + simple 分支锐角目标角降到 95°（构建 y）
    场地只够跑拱形赛道（两个 90° 底角 + 一段弧），需要直角逻辑。
    - LinePD 新增 commit_target_deg：承诺转向的目标角度按事件类型选择
    * 锐角（事件里出现过 FORK/ALL）-> LINE_ACUTE_TURN_DEG
    * 直角（纯 SIDE，且丢线时最后有效位置 |last_valid| >= 1.2cm，
    即"线从侧面滑出去"）-> LINE_RIGHT_ANGLE_TURN_DEG = 90°
    * 原来只有 acute 才 commit，现在直角也 commit（有角度上限和 1.5s 兜底）
    - simple 分支 LINE_ACUTE_TURN_DEG 115 -> 95：本分支面向弧线/直角赛道，
    90° 角按 115° 转会转过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
2026-10-26 feat(race): 自适应自动停车——不填周长也能停（LAP=1），构建 z
    场地只够跑拱形赛道，暂时没有周长数据，先把自动停车做成自适应的。
    LAP 语义：
    0 关闭自动停车（练习，长按 KEY3 打标）
    1 自适应（默认）：只靠启停线识别，不需要周长
    >=50 周长模式：识别为主，里程兜底
    自适应模式的判定：
    - 起跑后跑过 LINE_RACE_ARM_MIN_CM(120cm) 才武装，避开起跑线附近杂线；
    - 启停线 = 全黑脉冲 1~3 拍 + 横向误差 <1.2cm + 角点事件没有方向证据
    （真角点一定有 SIDE/FORK 方向；启停线只是短横线，没有方向）；
    - 安全上限：识别不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
2026-10-26 feat(pd): 高速抗振荡——Kp 速度调度 + 差速速率限制（构建 aa）
    现象（LKP20 / LKD0.9 / LBAS50，日志 22:30~22:39）：
    - 过弯后半段和出弯后出现 ~2.5~3Hz 极限环：
    误差每个采样周期翻一次符号（+2.5 / -2.1），差速在 ±35（角点内 ±47）来回打满；
    - 前半个弯误差单调变大时不抖，一旦车过头、误差变号就开始抖。
    原因：
    - 外环 40ms，50cm/s 时每周期走 2cm，8 路传感器量化步长 0.7cm；
    Kp=20 时一个通道跳变就是 14cm/s 的差速阶跃；
    - 加上传感器/内环延迟，形成正反馈；Kd=0.9 + 0.7 的微分滤波压不住。
    - Kp 速度调度：速度 > LINE_KP_SPEE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
2026-10-26 tune(race): 停车提前 1cm——硬刹余量 1.0 -> 2.0（构建 ab）
    实测停车效果很好，但车停过基准线约 1cm。
    把 LINE_RACE_BRAKE_MARGIN_CM 从 1.0 加到 2.0：
    "到点前 2cm 就开始硬刹"，靠滑行和刹车距离补上最后一段。
    这个余量同时吸收识别延迟（全黑脉冲结束那一拍才确认）和刹车滑行，
    以后微调只动这一个数：停过线就加，停早了就减。
    构建：Release FLASH 46 820 B (71.4%) / RAM 17 456 B (85.2%)；构建标记 aa -> ab
    （simple 分支；按约定只提交本地，未推送）
2026-10-27 fix(race): 启停线识别改到 Gray 20ms 采样并锁存，[RACE] det/stop 队列化（构建 ac）
    现象：自动停车在终点不停了。
    排查：
    - 识别原来在 40ms 外环里做。50cm/s 时 5cm 横线只黑 36ms，
    比一个外环周期还短，可能整拍漏掉；
    - 自适应模式（LAP=1）没有里程兜底，一旦漏检就永远不停。
    - Gray 每 20ms 采样时检测"8 路里≥6 路同时黑"的短脉冲（≤3 拍=60ms），
    锁存到 stop_bar_seen；角点/宽黑带持续更久，靠脉冲宽度排除。
    - LinePD 只消费这个锁存标志（不再在 40ms 里自己数脉冲）。
    - ControlTask 把 [RACE] det / [RACE] stop 也放进蓝牙队列（tag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
    [Ble_task.c, Ble_task.h, Control_task.c, Gray.c, Gray.h, LinePD.c]
2026-10-27 fix: 高速停车漏检/KEY3 回页/LBAS 误启动/蓝牙改名（构建 ad）
    1) 速度 >45 终点停不下
    - 5cm 横线在 50cm/s 只有 36ms（20ms 采样仅 1~2 拍），且高速时车身偏，
    8 路里可能只有 4~5 路黑，原来的阈值 6 直接漏检。
    - 修复：判定阈值 6->5；很短的脉冲（<=2 拍）不再要求"无方向锁存"；
    横向误差放宽到 1.6cm。
    - 新增**周长学习**：自适应模式只要成功识别一次启停线，就记住
    "识别里程 + 17cm"（0.7/0.3 平滑），之后高速漏检也能按里程兜底停车。
    学习值在 RAM，掉电丢；重启后低速跑一圈即可重新学到。
    2) 长按 KEY3 不回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
    [Ble_task.c, Control_task.c, Gray.c, Gray.h, LinePD.c, Oled_task.c]
2026-10-27 feat(ui): STOP 模式下也能打跑圈标记（构建 ae）
    问题：自动停车/急停之后模式是 STOP，原来的打标只在 LINE_FOLLOW 下生效，
    停车后没法补打成功/失败。
    - Control_task 增加 ControlTask_TagAllowed()：循迹模式【和停车模式】都允许打标；
    - PRESS 时的 eligible 判定、长按 KEY3 的成功标都改用这个条件
    （仍然要求当前在 MODE 页，避免调参页误触）；
    - 短按 KEY1 的失败标走原 eligible 路径，自然覆盖 STOP；
    - OLED 的 STOP 页提示从 "brake held" 改成 "K1 FAIL K3H OK"。
    构建：Release FLASH 47 556 B (72.6%) / RAM 17 464 B (85.3%)；构建标记 ad -> ae
    （simple 分支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
    [Ble_task.c, Control_task.c, Oled_task.c]
2026-10-27 fix(race): 恢复严格的启停线判定，避免 90° 弯误触发停车（构建 af）
    现象：拐弯时自动停车误触发。
    原因：上一次为了修 >45 漏检，把"≥5 路全黑"也认作启停线，还允许
    "≤2 拍短脉冲跳过方向检查"。实测 90° 弯里线在角上散开，会出现
    5 路同时黑 + 短脉冲，正好落进放宽后的条件里。
    改动（宁漏不误）：
    - GRAY_STOP_BAR_CHANNELS 5 -> 6；
    - 判定恢复为：必须 corner_dir == 0（真角点一定有方向锁存，
    启停线没有方向），横向误差 <1.2cm，脉冲宽度 <=3 拍；
    - 高速漏检不再靠放宽阈值来救，改由"学到的周长"按里程兜底
    （上一版已加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
    [Ble_task.c, Gray.h, LinePD.c]
2026-10-27 fix(race): LAP 语义修正——1~49 都算自适应，步长 10cm 不再误入周长模式（构建 ag）
    问题：OLED 上 LAP 每按一下加 10cm。这是参数表里配的步长
    （周长是几百上千厘米，1cm 步长要按几百次），本身没坏；
    但旧语义是"<2 = 自适应"，从 0 按一下变成 10 会被当成"10cm 周长"，
    里程兜底几乎立刻触发。
    - RaceStart：LAP 1~49 一律按自适应处理（没有周长），>=50 才是周长模式；
    - 默认值 1 -> 10，和"从 0 按一下"的结果一致；
    - OLED 参数说明、README 5.8 的 LAP 表同步。
    构建：Release FLASH 47 560 B (72.6%) / RAM 17 464 B (85.3%)；构建标记 af -> ag
    （si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
    [Ble_task.c, Control_task.c, LinePD.c, Oled_task.c]
2026-10-27 feat(ble): 适配新 HC-05——AT 波特率自适应 + 上电自动配置（构建 ah）
    依据资料包（HC-05.zip）里的规格书：
    - 模块上电、未配对时就是 AT 模式，波特率=模块自身波特率（出厂 9600）；
    - 若上电瞬间 KEY 为高，则固定 38400；
    - AT+UART 改波特率后要重新上电才生效；配对码默认 1234。
    改动（Drivers/BSD/Src/Ble.c）：
    - 新增 BLE_SetBaudInternal()：切 USART2 波特率并重新挂中断接收；
    - 新增 BLE_AutoConfig()：先试 9600、再试 38400 握手，成功后
    AT+ROLE=0（从机）/ AT+NAME=LFCar / AT+PSWD=1234，最后恢复 9600 并退出 AT；
    失败只返回 0，不影响透传；
    - Ble.h：B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
2026-10-27 feat(pd): 弧线流畅度——线角前馈 + 位置低通（构建 ai）
    A) 线角前馈：
    θ = Δ(横向位置) / Δ(两轮平均里程)，小角度近似 tanθ≈θ，不需要 atan；
    steer_ff = LINE_THETA_FF_GAIN(1.6) × v × θ，叠加在 PD 输出上。
    弧线上线是斜着压过探头的，θ 会先变，车在误差积累前就开始转；
    只在正常循迹时叠加（assist/角点事件内跳过），并限幅到 0.6×差速上限。
    B) 位置低通：
    error 先过一阶低通（α=0.5）再进 PD，压掉 0.7cm 量化步长带来的阶梯抖动；
    丢线时直接把滤波器拉到当前值，避免拖尾。
    新增宏：LINE_THETA_FF_GAIN / LINE_THETA_MAX_RA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
    [Ble_task.c, LinePD.c, LinePD.h]
2026-10-27 feat(imu): 接入 MPU6050 陀螺仪——驱动 + 20ms 航向积分 + [I] 遥测（构建 aj）
    硬件：MPU6050 挂在 I2C2（和 OLED 共总线），X 轴朝前、Z 轴竖直。
    新增驱动 Drivers/BSD/{Inc,MPU6050.h, Src/MPU6050.c}：
    - 初始化：WHO_AM_I 探测、软复位、PLL 时钟、SMPLRT_DIV=4(200Hz)、
    DLPF 44Hz、±500°/s、关 FIFO/中断；
    - 静态零偏标定：平均 200 次（≈0.4s），存 X/Y/Z 三轴零偏；
    - MPU6050_Update()：20ms 读取 + 减零偏 + 按 yaw 轴积分航向角，
    读取失败只累计 faults、不阻塞；
    - 轴映射宏 MPU6050_YAW_AXIS/MPU6050_YAW_SIGN：装歪了改宏即可；
    - 接口：IsReady / GetYawRateDps / GetYawDeg / GetBiasD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
2026-10-27 feat(imu): 陀螺三件套 A/B/C——yaw 阻尼、陀螺航向、定角转弯（构建 ak）
    A) yaw 阻尼：steer -= LINE_YAW_DAMP_GAIN(0.12) × ω_yaw，限幅 ±8cm/s；
    只在正常循迹（非 assist/角点事件）叠加，压制弧线后半段与出弯的摆动。
    B) 陀螺航向：LinePD 的 yaw 积分优先取 MPU6050 的航向（LINE_USE_IMU_YAW=1），
    没有模块或读取失败时自动退回编码器差分；每次进入循迹把航向清零。
    C) 定角转弯：承诺转向的目标角（直角 90°/锐角 95°）由陀螺航向计量，
    打滑不再让角度偏大，转够即停。
    新增宏：LINE_USE_IMU_YAW / LINE_YAW_DAMP_GAIN / LINE_YAW_DAMP_MAX_CMS
    README 2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
2026-10-28 fix(imu): MPU6050 地址自动探测 0x68/0x69，AD0=VCC 也能识别（构建 al）
    本车 MPU6050 的 AD0 接的是 VCC，7 位地址是 0x69（不是 0x68）。
    驱动原来写死 0x68，会探测失败。
    - 头文件改为 MPU6050_ADDR_7BIT_LOW(0x68) / HIGH(0x69)，保留
    WHO_AM_I 固定值 0x68 的说明；
    - 初始化时依次试 0x68、0x69，谁回 WHO_AM_I=0x68 就用谁；
    之后所有读写用探测到的地址（s_addr）；
    - README 硬件表补 MPU6050 一行（AD0=VCC -> 0x69）。
    构建：Release FLASH 49 808 B (76.0%) / RAM 17 512 B (85.5%)；构建标记 ak -> al
    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
    [Ble_task.c, MPU6050.c, MPU6050.h]
2026-10-28 chore: 忽略 .venv（数据分析脚本的本地虚拟环境）
2026-10-28 fix(pd): 线角前馈工程化——3 点回归估角 + 死区/斜坡/限幅（构建 am）
    现象：加线角前馈后反而更抖。
    原因：θ = Δ位置/Δ里程 本质是对量化位置的微分。
    8 路量化 0.7cm、40ms 只走 2cm，θ 噪声可到 ±0.35rad；
    50cm/s、增益 1.6 时前馈噪声峰值 ≈ ±28cm/s（被限幅到 21），
    前馈从"辅助"变成"抖动源"。
    改动（按 2-DOF / 参考前馈的常规做法）：
    - θ 改用最近 3 点最小二乘斜率（基线 80ms/4cm），斜率噪声约降到 1/3；
    - 死区：|θ| < 0.04rad（约 2.3°）不加前馈；
    - 斜坡限幅：前馈每拍最多变 2cm/s，杜绝一拍打满；
    - 输出限幅：前馈 <= 0.35 ×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
    [Ble_task.c, LinePD.c, LinePD.h, bt_ble_capture.py, ident_speed.py]
2026-10-28 tune(pd): 关闭线角前馈（LINE_THETA_FF_GAIN=0，构建 an）
    实测这套"位置微分"前馈在 8 路量化传感器上噪声占比太高，
    一开就抖。先关掉做对比基线：只保留位置低通 + yaw 阻尼 + 陀螺航向。
    代码路径保留（死区/斜坡/限幅都在），把宏改回 0.8 即可重新启用。
    构建：Release FLASH 50 268 B (76.7%) / RAM 17 544 B (85.7%)；构建标记 am -> an
    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
2026-10-28 fix(race): 自适应模式拒绝过早的启停线识别，并输出学习周长（构建 ao）
    现象：关掉前馈后不抖了，但车每次只跑一小段就停。
    代码路径分析：
    - 自适应模式（LAP<50，含默认 10）在跑过 120cm 后进入阶段 1；
    - 阶段 1 的"学到的周长"兜底会按 s_learned_lap_cm-2 停车；
    - 只要在弯道/接缝处误识别一次启停线（dir==0、短全黑），
    就会把周长学成 120+17 ≈ 137~180cm，之后每一圈都在 ~1.4m 处停住。
    修复：
    - 自适应模式下，识别点里程 < LINE_RACE_LEARN_MIN_CM(200cm) 的
    识别一律不认（真终点不可能在 2m 内）；
    - 学习周长同样要求估算值 >= 200c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
    [Ble_task.c, LinePD.c, LinePD.h, bt_ble_capture.py]
2026-10-28 feat(race,ble): 关闭周长学习；BLE 采集加指数退避（构建 ap）
    1) 关闭自适应模式的"学习周长"（LINE_RACE_LEARN_LAP=0）：
    实测弯道/接缝误识别一次就会把周长学成 1.3~1.8m，
    之后每圈都在错误位置停；用户明确不需要该功能。
    关闭后自适应模式只靠启停线识别，识别不到按 2000cm 安全上限停。
    保留"识别点 <200cm 一律不认"的防误触发保护（与学习无关）。
    2) tools/bt_ble_capture.py：
    - 无数据/断开后的重连间隔改为指数退避（10s 起，最多 30s）；
    - 新增 --retry-delay；
    减少反复连接触发 KDE 蓝牙配对/授权弹窗的频率。
    构建：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
2026-10-28 feat(ble,race): 适配 JDY-31（SPP）+ 支持 120cm 短赛道（构建 aq）
    1) JDY-31 驱动（依据官方手册 V1.3）：
    - 上电自动识别模块：AT+VERSION 返回含 "JDY-31" 判为 JDY-31，
    否则 AT 回 OK 判为 HC-05；并打印 [BLE] module=...
    - JDY-31 命令集：AT+NAME<名> / AT+PIN<4位> / AT+BAUD<4..9> /
    AT+ENLOG<0|1>；上电自动设置 LFCar / 1234 / ENLOG0；
    - HC-05 继续走 AT+NAME=/AT+PSWD=/AT+ROLE= 老路径；
    - BLE_SetName/SetPin/SetBaud 按识别到的模块自动选命令格式；
    - 6 针底板引脚：STATE/RXD/TXD/GND/VCC/EN(空)，底板 3.6~6V 供电，
    STATE 接 PA1 可用；EN 为空，PB3 的 KEY 操作对 JDY-31 无影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
2026-10-28 fix(pd): 角点方向迟滞——修复窄赛道方向 0.2s 内反复翻转（构建 ar）
    现象：新赛道（长直道+右侧两个 90°+左侧大弧带"鼻子"）上总判错方向。
    数据证据（logs/serial_20261028_154025.log，[Laq] LINE 段 194 条）：
    - 方向锁存 cd 在 172 个非零样本里翻转 22 次，最快 0.19s 一次（-1/+1/-1）；
    - 场景 43% 处于 SIDE/ALL/NONE；|e| 常打满 2.5；|s| 常打满 47；
    - 编码器航向 y 摆到 -1021°~+772°（反复打转搜索）。
    - LINE_CORNER_CONFIRM_CYCLES = 1（单拍 SIDE 就进事件）；
    - 每个新事件开始都把 corner_dir 清零重新投票；
    - 窄赛道/鼻子处 SIDE_L/SIDE_R 交替出现 ->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
    [Ble_task.c, Control_task.c, LinePD.c, LinePD.h]
2026-10-28 fix(imu): MPU6050 探测失败时自动降到 100kHz 重试（构建 as）
    怀疑 I2C2 400kHz 太快导致 MPU6050 不响应（杜邦线长、上拉弱、
    与 OLED 共总线都常见）。
    - 把地址探测抽成 MPU_ProbeAddress()；
    - 400kHz 探不到 0x68/0x69 时，把 hi2c2 降到 100kHz 重新 HAL_I2C_Init，
    再探一次；成功则保持 100kHz（OLED 刷新略慢，控制不受影响），
    失败则恢复原速率并返回"没接模块"；
    - 配合 ar 的 3s 运行时重试 + I 命令的 I2C2 扫描，可现场定位。
    构建：Release FLASH 50 820 B (77.6%) / RAM 17 552 B (85.7%)；构建标记 ar -> as
    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
    [Ble_task.c, MPU6050.c]
2026-10-28 feat(ble): [M] 行输出模块识别结果，便于判断"扫不到"是固件还是射频侧（构建 at）
    排查"蓝牙初始化代码是否有问题"：
    - 初始化只做两件事：KEY(PB3) 拉低 + 上电自动识别/配置模块；
    JDY-31 的 AT+NAMELFCar/AT+PIN1234/AT+ENLOG0 不会改变可发现性；
    PB3 接的是底板 EN（手册标注空脚），对 JDY-31 无影响。
    - 但"电脑扫不到"需要区分：是固件与模块 UART 不通，还是射频侧被占用/没广播。
    - Ble.c 记录 BLE_AutoConfig 结果 s_cfg_ok，新增 BLE_GetCfgResult()；
    - [M] 行末尾加 "mod=%s cfg%u"（如 mod=JDY-31 cfg1）。
    cfg1 = 固件识别并配置成功；cfg0 = AT 都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
    [Ble.c, Ble.h, Ble_task.c]
2026-10-28 fix(ble,imu): I2C 锁 400kHz；BLE 保留识别到的波特率（构建 au）
    1) I2C 保持 400kHz（上拉已修好）：
    - MPU6050_ALLOW_SLOW_FALLBACK=0，探测失败不再降到 100kHz；
    - main.c 的 hi2c2 本来就是 400kHz，OLED 恢复全速。
    2) HC-05 "连得上但没数据" 的一个可疑原因：
    - AutoConfig 识别成功后原来强制把 USART2 拉回 9600；
    - 如果模块实际跑在 38400/115200（模块被改过波特率），
    MCU 9600 vs 模块 38400 -> 透传全是乱码/无数据；
    - 现在保持识别到的波特率，不再强制 9600。
    3) [M] 行末尾加 baud（如 baud9600），配合 mod/cfg 直接看出：
    - 模块有没有被识别（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
    [Ble.c, Ble.h, Ble_task.c, MPU6050.c, MPU6050.h]
2026-10-28 fix(imu): 接受 MPU6500/9250 的 WHO_AM_I，并打印实际 ID（构建 av）
    I2C2 扫描（蓝牙命令 I）结果：
    [I2C2] scan: 0x3C 0x69 ← OLED + MPU6050(AD0=VCC) 都有应答
    说明补上 1.7k 上拉后总线恢复正常，但固件仍报 NOT FOUND。
    原因：模块实际是 MPU6500/9250 克隆片，WHO_AM_I 返回 0x70/0x71/0x73，
    原来只认 0x68。
    - MPU_ProbeAddress 接受 0x68/0x70/0x71/0x73，并记录实际 ID；
    - 新增 MPU6050_GetWhoAmI()；
    - [IMU] 行改为 "MPU6050 ok id=0x70 biasZ=..."，一眼看出芯片型号。
    构建：Release FLASH 50 872 B (77.6%) / RAM 17 552 B (85.7%)；构建标记 au -> av
    （simple 分支；按约定只提交本地，未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
    [Ble_task.c, MPU6050.c, MPU6050.h]
2026-10-28 feat(imu): [I] 行输出芯片 WHO_AM_I，确认 6050/6500/9250（构建 aw）
    [IMU] 行只在启动时打印一次，采集常常错过；把 ID 放进每 2s 的 [I] 行：
    [I] id0x70 y-113 g+0 b-6 f633
    由此可直接判断：
    0x68 = 真 MPU6050
    0x70 = MPU6500（最常见"克隆 6050"）
    0x71 = MPU9250
    0x73 = MPU9255
    构建：Release FLASH 50 880 B (77.6%) / RAM 17 552 B (85.7%)；构建标记 av -> aw
    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
2026-10-28 fix(imu): 翻转 yaw 符号 + 新增静止重标定命令 Z（构建 ax）
    实测（手转车身向左）：
    [I] y-199 g+2 → y-203 g-12 → y-209 g-3 ...
    左转时 g 为负、y 在减小，与"左转为正"的约定相反；定角转弯因此
    会朝反方向累计角度/提前结束 —— 表现就是直角冲过头。
    - MPU6050_YAW_SIGN: +1 -> -1；
    - 新增蓝牙命令 Z：仅在 STOP 模式执行，静止重标定 400 次并清零航向。
    上电标定时车若在被人拿着/移动，零偏会标错（当前 b+15，
    静止时 y 仍以约 -1.5°/s 漂，就是标定时刻在动）。
    构建：Release FLASH 51 120 B (78.0%) / RAM 17 552 B (85.7%)；构建标记 aw -> a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
    [Ble_task.c, MPU6050.h]
2026-10-28 fix(imu): yaw 符号改回 +1，并在 [I] 行标注 sg±1（构建 ay）
    实测（ax，SIGN=-1）：手转车身逆时针时 [I] g 仍为负、y 减小，
    说明原始 gyro Z 对逆时针为正，符号应取 +1。
    （18:52 那次读数受漂移/链路影响，误判成反了。）
    - MPU6050_YAW_SIGN: -1 -> +1；
    - [I] 行加 sg%+d（如 sg+1），一眼确认烧进去的符号；
    - 保留 Z 命令（静止重标定）。
    构建：Release FLASH 51 128 B (78.0%) / RAM 17 552 B (85.7%)；构建标记 ax -> ay
    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
    [Ble_task.c, MPU6050.h, ble_send.py]
2026-10-28 fix(ble): 上电把模块波特率统一到 9600，避免复位后失配（构建 az）
    现象：蓝牙 connect 成功、notify 订阅成功，但 10s 收不到任何字节，
    脚本反复重连。原因排查：
    - TX/RX 交叉接线正确（板 TX -> 模块 RX）；
    - 固件识别到模块在 38400 并保持该速率；
    - 电机干扰可能让模块瞬间复位回出厂 9600，固件仍是 38400，
    模块收到的是乱码 -> 一个字节都不回传。
    改动（BLE_AutoConfig）：
    - 识别到模块后，如果速率 != 9600：
    JDY-31 发 AT+BAUD4 + AT+RESET；HC-05 发 AT+UART=9600,0,0 + AT+RESET；
    - 等 400ms，MCU 切回 9600，发 AT 验证；
    - 验证失败（命令不被支持/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
    [Ble.c, Ble_task.c]
2026-10-28 feat(ui,pd): STOP 按 KEY2 直接进 LINE；SPD 改长按 KEY1；重新开启线角前馈（构建 ba）
    1) 模式切换防误按（实测三次"直角冲出道"其实是误进 SPD）：
    - MODE 页、STOP 状态下：短按 KEY2 直接进 LINE（跳过 SPD）；
    - SPD 改为：STOP + MODE 页长按 KEY1 进入（Control_task）；
    - STOP 页提示改为 "K2:LINE K1H:SPD"；
    - 打标逻辑不变：短按 KEY1=FAIL、长按 KEY3=OK（STOP 下也可）。
    2) 线角前馈重新打开：LINE_THETA_FF_GAIN 0 -> 0.8
    （3 点回归估角 + 死区 0.04rad + 斜坡 2cm/s/拍 + 限幅 0.35 差速上限都保留）
    构建：Release FLASH 51 344 B (78.3%) / RAM 17 552 B (85.7%)；构建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
    [Ble_task.c, Control_task.c, LinePD.h, Oled_task.c]
2026-10-28 feat(ble): JDY-31 识别放宽 + 固定 9600（构建 bb）
    换回 JDY-31 模块（经典 SPP，默认 9600）：
    - AT+VERSION 返回里只要含 "JDY" 就判为 JDY-31（原来要求 "JDY-31"）；
    - JDY 分支无条件发 AT+BAUD4（幂等），保证模块与 MCU 都是 9600，
    即使模块被改过速率/复位也不会失配；
    - 仍是自动识别：JDY-31 / HC-05 都能用，[M] 行会显示 mod=JDY-31。
    注意：JDY-31 是经典蓝牙 SPP，电脑端要用 RFCOMM（PIN 1234）采集，
    不是 BLE GATT；tools/bt_serial_capture.py --mac <MAC> 即为此用。
    构建：Release FLASH 51 360 B (78.3%) / RAM 17 552 B (85.7%)；构建标记 ba -> bb
    （simple 分支；按约定只提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
2026-10-28 fix(pd): 半圆弯中途误触发原地转向 + SIDE 误判角点（构建 bd）
    数据分析（logs/serial_20261028_202606.log）：
    - 原地转向示例：20:28:51.979 还是 LINE（e+0.20），
    92ms 后 20:28:52.071 已是 NONE 并开始 L-24/R+24 原地转；
    - 误差没有渐进上升（0.2 -> 直接丢线），说明线是"突然不在探头下"，
    不是转向不足导致的漂移丢失（那样 e 会先爬到 2.5）；
    - 全段统计：SIDE 场景 72 条里 99% 的 |e| < 2.0cm（中位 1.15cm），
    这些是正常横向偏移，却被当成角点触发承诺转向，导致 cs=1 占 39% 时间。
    1) 丢线容差 2 -> 5 拍（80ms -> 200ms）：短暂丢线先按正常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
    [Ble_task.c, LinePD.c, LinePD.h]
2026-10-28 feat(pd): 前馈回到 0.7 + 丢线自动降速（构建 be）
    bd 实测（59s）：|e| 中位 0.50、|s| 中位 6.3、翻转率 24%、
    cs=1 仅 1%、ALL 场景 0、5.5 圈 ≈10.7s/圈，连续多圈成功。
    继续收精度：
    1) 线角前馈 0.5 -> 0.7（bd 已经稳，给前馈加回一点；
    若翻转率明显回升再退回 0.6）；
    2) 丢线降速：lost_count > 0（尚未进入搜索）时目标速度 ×0.70，
    给车时间冲过半圆弧上的短暂断线/遮挡。
    构建：Release FLASH 51 404 B (78.4%) / RAM 17 552 B (85.7%)；构建标记 bd -> be
    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
2026-10-28 fix(ble): 强制 JDY-31 模式并固定 9600，修复误判成 HC-05（构建 bf）
    现象：设备名变成 "=LFCar"（HC-05 的 AT+NAME=LFCar 格式），
    说明自动识别把 JDY 误判成了 HC-05：
    - AT+UART=9600 对 JDY 无效 -> 波特率没切成 9600；
    - 名字被写成 "=LFCar"。
    改动：新增 BLE_MODULE_FORCE_JDY31（默认 1）
    - 不再猜型号，固定按 JDY-31 指令集：
    1) 9600/38400/115200 里用 AT+VERSION 找模块；
    2) AT+BAUD4（9600）+ AT+RESET，等 400ms，MCU 切 9600 并验证；
    验证失败退回原速率（保证链路可用）；
    3) AT+NAMELFCar / AT+PIN1234 / AT+ENLOG0（JDY 格式，无 '='）；
    - 以后换回 HC-05 把该宏改成 0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
    [Ble.c, Ble.h, Ble_task.c]
2026-10-28 tune(pd): 默认 LKP=12 / LKD=1.2 / 基础速度=50，LBAS 上限 55（构建 bg）
    按 bf 实测（LINE 段 |e| 中位 0.20、|s| 中位 4.4、圈速 10.1s）继续调：
    - LINE_PD_DFLT_KP 20 -> 12
    - LINE_PD_DFLT_KD 1.0 -> 1.2
    - 均衡档默认基础速度 30 -> 50（上电即 50，不用每次 OLED 调）
    - OLED 参数表 LBAS 上限 50 -> 55
    构建：Release FLASH 51 152 B (78.0%) / RAM 17 552 B (85.7%)；构建标记 bf -> bg
    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
2026-10-28 tune(pd): 弧线限速 0.72→0.62 + 前馈 0.7→0.9（构建 bh）
    数据（LBAS 50/55 对比）：
    - 55：半圆段 NONE 30%、原地转 9%，但圈速 9.74s；
    - 50：NONE 21%、原地转 5%，但圈速 10.25s、翻转率 31%。
    说明问题在"半圆弧速度过快、线被甩出探头"，不是直线速度。
    改动（只动默认 profile 1）：
    - LINE_CORNER_SLOW_MAX 0.72 -> 0.62：弧线深度大时速度压到 ~0.62×
    基速，直道仍可 55×1.25 ≈ 68，做到"直道快、弧线慢"；
    - LINE_THETA_FF_GAIN 0.7 -> 0.9：弧线前馈更早介入，减少被甩出去。
    构建：Release FLASH 51 152 B (78.0%) / RAM 17 552 B (85.7%)；构建标记 bg -> bh
    （simple 分支；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
    [Ble_task.c, LinePD.h]
2026-10-28 fix(pd): 方向证据与角点触发解耦 + ALL 时按方向满舵（构建 bi）
    bh 实测（21:49:39~44）失效序列：
    21:49:41.9 SIDE_R e=1.2 (|e|<2.0 门限) -> 方向没锁存
    21:49:42.1 ALL，e≈0，速度 60~69，持续 2 秒 -> 车按直道全速冲出
    根因：|e|>=2.0 的门限把真角点的方向证据也过滤了；
    角点全黑（ALL）时位置解算失效，没有方向就直走。
    1) 门限只取消"触发角点事件"，方向证据照常锁存；
    2) 方向锁存块移出 is_corner 分支，SIDE 一出现就锁方向；
    3) ALL + 已有方向时，即使没进角点事件也满舵转向
    （LINE_ALL_ASSIST_CYCLES=2），避免"全黑直冲"。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
    [Ble_task.c, LinePD.c, LinePD.h, sim_corner.py]
2026-10-28 feat(gray,pd): 20ms 级 SIDE 方向锁存，防止外环漏掉角点证据（构建 bj）
    问题：Gray 每 20ms 采样一次场景，LinePD 外环每 40ms 才读一次。
    55cm/s 时 90° 角点的 SIDE 窗口可能只有 20~40ms，外环有机会整拍
    错过 SIDE -> 方向锁不上 -> 到 ALL（全黑、e≈0）时按直道冲出去。
    改动（不动外环频率、不动 PD 参数）：
    - Gray 结构体新增 side_latch_dir / side_latch_tick；
    - Gray_Update 每 20ms 在 scene_raw 出来后：看到 SIDE_L -> +1，
    SIDE_R -> -1，并记时间戳；
    - LinePD 角点证据段：本拍没有 SIDE/FORK 证据时，
    若 100ms 内（LINE_CORNER_LATCH_MS）有锁存，就补上方向证据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
    [Ble_task.c, Gray.c, Gray.h, LinePD.c, LinePD.h]
2026-10-29 tune(pd): 三档基础速度重配为 40/50/55，修正档位表与文档（构建 bk）
    原来 0/1/2 = 26/50/34，默认档调到 50 之后「激进」档反而比「均衡」慢，档位语义反了。
    - LinePD.h: 0 保守 40 / 1 均衡 50 / 2 激进 55（55 是 LBAS 按键上限，贴近电机 57cm/s 天花板）
    - 2 档角点限速 0.82 -> 0.62、0 档 0.65 -> 0.70，与默认档的实车调参结果对齐
    - 注释补充天花板提醒：2 档直道目标 74cm/s 超出电机能力，必要时把 BOOST 降到 0.20
    - README: 档位表、5.4 的 KP/KD/BASE、5.7 实现说明与 LBAS 建议值同步到实测参数
    - Ble_task: 构建标记 bj -> bk
    [Ble_task.c, LinePD.h]
2026-10-29 docs: 澄清直道加速与电机天花板的饱和关系（1/2 档都会超 57cm/s）
2026-10-29 tune(speed): 提速软件组合：KFF 1.25 / 斜坡 90 / 弯道下限放宽（构建 bk）
    数据（bj）：平均速度只有 32.3cm/s，31% 时间低于 25cm/s，
    >55cm/s 只占 13% —— 圈速瓶颈在低速段，不在直线极速。
    换电机对圈速贡献约 0.16s/圈，而低速段提速可省约 1.2s/圈。
    软件提速（零成本）：
    1) 内环 KFF 1.0 -> 1.25（辨识 K_A≈0.794 => 1/0.794≈1.26，
    原来靠 KI 补稳态误差，起步/出弯慢）；
    2) 加速斜坡 50 -> 90 cm/s/s（出弯恢复快 80%）；
    3) 弯道最慢系数 LINE_CURVE_SLOW_MIN 0.40 -> 0.45（55→24.8）；
    4) 角点限速 LINE_CORNER_SLOW_MAX 0.62 -> 0.68（55→37.4）；
    5) 丢线降速 0.70 -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
2026-10-29 feat(pd): 曲率限速替代误差限速 + 阻尼 0.03 + 前馈 1.15（构建 bl）
    数据（bk，新弧线赛道 350cm/圈）：
    - 圈速 8.74 -> 7.95s（KFF 1.0->1.3 的效果）；
    - 直道 e=+0.20，缓弯(R=111cm) e=+0.80，急弯(R=20cm) e=+1.70；
    - 由陀螺角速度反推实际曲率：R 从 111cm 到 11cm 分布很宽；
    - 按 a_lat=100cm/s² 算，缓弯还有 2.4 倍提速空间，急弯只剩 1.1 倍。
    问题：旧的"误差驱动"减速在缓弯也被 |e| 触发（e=0.8 就降到 0.89×），
    导致缓弯跑不起来；而急弯该慢的地方又不够慢。
    1) 新增曲率限速 LINE_CURVE_SPEED_MODE=1：
    κ = |ω|/v, v_max = sqrt(a_lat_max/κ)
    按实际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
    [Ble_task.c, LinePD.c, LinePD.h, Oled_task.c]
2026-10-29 tune(pd): ALAT 默认 85 + 直道加速门槛放宽 + 阻尼 0.07（构建 bm）
    ALAT 85 实测（vs 100）：
    - 圈速持平 8.60/8.63s（100 时 8.59s）；
    - 平均速度 42.4 -> 44.4（+5%）；
    - |e| 中位 1.20 -> 0.90~1.10，>2.0 占比 23% -> 17%。
    说明 100 已过车的能力极限，85 反而更快更稳。
    剩余最大损失在直道：直道速度只有 44cm/s（基速 55、加速后应 71）。
    原因：直道加速的三道门槛太严（实测直道 |e|=0.60 > 门槛 0.35），
    boost 从不累积。
    1) LINE_STRAIGHT_EPS_CM 0.35 -> 0.80
    2) LINE_STRAIGHT_STEER_CM 8.0 -> 12.0
    3) 直道加速 depth 门槛 0.30 -> 0.45
    4) LINE_YAW_DAMP_GAIN 0.03 -> 0.07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
2026-10-29 feat(pd): 进弯预判减速（线角 θ）+ 兜底加严 + LKD 1.6（构建 bn）
    bm 实测问题：小半弯（圈内 17~72°）"跑一下停一下"。
    抓到的事件序列（20:44:33~35）：
    33.593 LINE e-2.2 s-23.0 <- 急右弯
    34.102 LINE e+1.9 s+32.7 <- 0.5s 内误差翻 4.1cm（极限环）
    34.327 NONE e+2.5 L+24 R-24 sd-1 <- 丢线，原地右转搜索
    35.455 SIDE_L 恢复
    合计耗时 1.13s，原地转了约 200°。
    全段：丢线 62 次、累计 3.6s（约 0.33s/圈），全集中在小半弯。
    翻转率 29%，|e| 中位 1.20（比 bl 的 0.90~1.10 差）。
    根因：陀螺曲率限速是反应式的，进弯时 ω 还没起来；
    12cm 半径以 4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
    [Ble_task.c, LinePD.c, LinePD.h]
2026-10-29 feat(pd): 弯道宽差速 60（内侧轮真正停转）+ 预判减速收到 0.35（构建 bo）
    数据（bn，463 样本，按内侧轮状态分组，看 3 拍后 |e|）：
    内侧反转(<0) : |e| 2.50 -> 1.15
    内侧停转(0~5): |e| 2.15 -> 0.90 <- 与反转几乎相同
    内侧慢转(5~20): |e| 1.90 -> 1.25 <- 就差在这一档
    内侧正常(>20): |e| 0.85 -> 1.20
    另：36 个"反转"样本里 21 个是 NONE（已在原地搜索），
    正常循迹时反转占比很低。
    结论：不需要主动反转（TB6612 死区 20~50ms、堵转电流可达 3A），
    只要把内侧轮从"慢转"拉到"停转"即可拿到绝大部分收益。
    而差速上限 35 时，车速 55 的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
2026-10-29 feat(pd): 大误差转向增益 + 宽差速上限收到 45 + LKD 1.9（构建 bp）
    bo 实测发现关键问题：差速限幅根本不是瓶颈。
    |s| 中位 12.6，最大只有 42.1，>45 占比 0%，>35 仅 2%
    限幅从 35 放到 60 完全没被用到，圈速反而略慢（8.8~9.4）。
    真正瓶颈是 Kp 的速度缩放：
    kp=12、车速 55 -> kp_eff = 12×30/55 = 6.55
    |e|=2.5 时 steer 只有 16cm/s，实测 |s|/|e| 中位 9.4
    -> 误差打满也给不出足够差速，内侧轮只能"慢转"(5~20) 不能"停转"(0~5)。
    1) 新增大误差转向增益：|e| 从 1.5cm 到 2.5cm 线性把差速放大到 1.6 倍
    （|e|=2.5 时 steer 22.6 -> 约 36，内侧轮 55-36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
    [Ble_task.c, LinePD.c, LinePD.h]
2026-10-29 fix(pd): 增益低通 + 转向输出低通，抑制 2.4Hz 极限环（构建 bq）
    bp 实测：|e| 中位 1.20 -> 0.90（大误差增益有效），但翻转率 38% -> 48%，
    用户主观感受"车会甩"。量化：
    振荡频率 2.4Hz（半周期 208ms）
    过零时 |s| 中位 13.3 -> 17.8
    大幅摆动(|s|>15)占比 42% -> 59%
    根因：增益瞬时生效。|e| 一过 1.5cm 立刻 ×1.6，车还没反应下一拍误差
    就反向、又立刻反向猛打 -> 与 2.4Hz 极限环共振。
    1) 增益系数本身做低通（LINE_STEER_GAIN_LPF=0.35，约 3 拍/120ms），
    误差抖动时增益不跟着抖，持续大误差才爬上去。
    2) 增益上限 LINE_STEER_GAIN_MAX 0.60 -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
    [Ble_task.c, LinePD.c, LinePD.h]
2026-10-29 perf(pd): 外环 40ms -> 20ms（减半滞后）+ 撤销 bp/bq 实验（构建 br）
    诊断：7 个版本圈速都在 8.6~9.4s、|e| 1.0~1.4 之间摆动，
    差异在噪声范围内 —— 说明瓶颈不是增益参数，而是结构性的控制滞后。
    2.4Hz 振荡（周期 417ms）的相位预算：
    外环采样保持 40ms -> 34°
    转向斜率限幅（实测 52~58% 时间饱和，摆动±40 需 4 拍）-> 69°
    电机时间常数 0.35~0.41s -> 79°
    微分低通 0.7 -> 约 20°
    合计 ≈ 200° > 180° => 必然振荡
    对照 GitHub 上的高速循迹车（felipemmattia/PID_line_follower_robot、
    bercebus/Vanir-velocista、sametoguten/STM32-Line-Followe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
2026-10-29 tune(pd): 默认值定为实测最优 LKP=14 / LBAS=55，LBAS 上限 60（构建 bs）
    按真实参数分组重分析（读每条 [L] 行之前最近的 [P]/[K]，不按时间切）：
    LKP LBAS KP n |e|中位 >2.0 翻转 丢线/百 圈速
    12 55 0.8 226 1.20 14% 38% 0.9 8.75
    12 55 1.0 220 1.30 15% 31% 1.4 8.79
    12 55 1.2 193 1.20 10% 30% 0.5 8.74
    12 55 1.4 407 1.30 15% 32% 1.7 8.72/9.19/7.28
    14 55 1.4 785 1.10 11% 34% 1.8 8.47/8.37/8.64/7.08/8.37
    结论：
    - LKP 12 -> 14 是真正的提速来源（8.72 -> 8.37，快 0.4s），|e| 也更小；
    - 内环 KP 0.8~1.4 四档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
2026-10-29 tune(pd,spd): 默认值定为 LKP=16 / LKD=1.0 / LBAS=55 / 内环 KP=1.4（构建 bt）
    同一块电池连续测的五组（速度用速度积分算，不依赖会被重置的 yaw）：
    LKP/LKD/LBAS n 均速 |e|中位 >2.0 翻转 丢线%
    16/1.0/55 445 42.6 1.00 2% 33% 0.2 <- 综合最优
    14/1.0/55 244 42.2 1.10 7% 32% 0.4
    14/0.8/55 222 43.1 1.20 3% 29% 0.0
    16/0.8/55 553 43.7 1.10 9% 32% 3.6
    16/0.8/60 394 44.0 1.00 16% 28% 6.9 <- 丢线翻倍，不可取
    把丢线代价换算成时间（每次丢线原地找线约 1s）：
    16/0.8/55 速度 +2.6%（省 0.2s）但丢线多 1.4s -> 净亏 1.2s
    16/0.8/60 速度 +3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
2026-10-29 fix(pd): 补齐 20ms 周期下所有"按拍"常量的时间换算（构建 bu）
    外环从 40ms 提到 20ms 后，一批按"拍数"计的防抖/容差常量
    实际时间被悄悄减半，其中 LINE_LOST_TOLERANCE 会造成真实故障。
    实测证据（bs 段，20ms/拍）：
    NONE 连续长度分布 {1:18, 2:4, 3:1, 4:3, 8:1}
    最长 8 拍 = 160ms，而容差只有 5 拍 = 100ms
    -> 4% 的丢线段会超过容差，误触发原地转向找线
    修正（全部恢复到设计意图的时间长度）：
    LINE_LOST_TOLERANCE 5 -> 10 (100ms -> 200ms)
    LINE_CORNER_CONFIRM_CYCLES 3 -> 6 (60ms -> 120ms)
    LINE_CORNER_DIR_FLIP_CYCLES 3 -> 6 (60ms -> 120ms)
    LINE_CORNER_RELEAS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
    [Ble_task.c, LinePD.h]
2026-10-30 fix(gray): 通道间距标定 7.0mm -> 11.5mm（实测），同步缩放 cm 阈值（构建 bv）
    问题：Gray.h 假设通道中心间距 7.0mm（总跨距 4.9cm），
    实测为 11.5mm（8 路总跨距 80.5mm，与板宽 8cm 吻合）。
    后果：所有位置读数被低估 1.643 倍 —— 日志里的 |e|=1.20cm 实际是
    1.97cm；凡是"按 cm 写"的阈值，实际都要等误差更大才触发。
    证据：
    - 尺子实测传感器中心间距 11.5mm；
    - 日志统计 71% 的时刻只有 2 路压线（2cm 线 / 10~11.5mm 间距 = 2 路），
    若真是 7mm 间距应压 2.86 路（多数 3 路，实测只有 16%）；
    - 误差限幅 GRAY_HALF_SPAN_MM×0.1 在两种标定下都落在阵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
    [Gray.h, LinePD.h]
2026-10-30 fix(pd): 标定修正的连带影响 —— θ 相关常量同步换算（构建 bv）
    问题：GRAY_CHANNEL_PITCH_MM 7.0 -> 11.5 后，位置读数放大 1.643 倍。
    而线角 θ 是用 θ = Δ位置 / Δ里程 估出来的（LinePD.c A 段），
    所以 θ 也一起被放大了 1.643 倍 —— 这一层耦合上一版漏掉了。
    漏掉的后果（如果不修）：
    - 前馈 steer_ff = FF × v × θ 变成 1.643 倍 -> 弯道过度转向；
    - 进弯预判 |θ| 与 0.15/0.70 rad 比较 -> 提前很多就减速，圈速会掉；
    - θ 死区 0.04 rad 变小 -> 直道上噪声也会进前馈。
    同步换算（全部按 1.643 或 1/1.643）：
    LINE_THETA_FF_GAIN 1.15 -> 0.70 （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
    [LinePD.c, LinePD.h]
2026-10-30 tune(pd): LKD 默认 1.0 -> 1.6，压 bu 暴露出的 2.5Hz 抖动（构建 bv）
    bu 实测（vs bt）：
    均速 42.4 -> 45.1（+6.4%）
    cs=1 角点事件 4% -> 0%
    NONE 丢线 5.2% -> 0.4%
    SIDE 场景 25% -> 4%
    翻转率 33% -> 50%
    原因：bu 把被 20ms 改动减半的防抖时间恢复了（丢线容差 200ms、
    找回确认 80ms、角点确认 120ms 等），误触发的 SIDE/角点事件消失，
    车 96% 的时间都在跑"干净的 PD"。而 LKP=16 在这条干净的 PD 上偏高，
    表现为 2.5Hz、过零 |s|=18.2 的极限环 —— 之前是 SIDE 事件在无意中
    充当阻尼，掩盖了这个增益问题。
    改动：LINE_PD_DFLT_KD 1.0 -> 1.6（唯一改动，外环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
    [Ble_task.c, LinePD.h]
2026-10-30 fix(ble): [VER] 行直接拼 BLE_BUILD_TAG；参数回到实测最优 LKP14/LKD1.0（构建 bw）
    两个问题：
    1) [VER] 行一直显示 2025-10-29bk（stale）
    原因：rebase 解决冲突时取了 HEAD 侧写死的 "2025-10-29bk"，
    之后每次改构建标记的 sed 都在找 "…bt"/"…bu" 去替换，永远匹配不上。
    修复：改成 "[VER] line-follower " BLE_BUILD_TAG " P%d"，
    构建标记与版本行从此不可能失同步（构建日期本来就已经打印）。
    2) 参数按 bv 实测回退
    bv 三组（同一固件、同一电池、标定已生效）：
    LKP/LKD n 均速 |e|中位 翻转% SIDE% |s|中位
    16/1.6 273 43.1 1.00 53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
    [Ble_task.c, LinePD.h]
2026-10-30 tune(pd): 释放弯道能力 + 扫参定稿 12/0.6（构建 bx）
    完整扫参（bv 固件，同电池，标定已生效）：
    LKP/LKD n 均速 |e|中位 翻转% 丢线% |s|中位 撞斜率限幅%
    16/1.6 273 43.1 1.00 53% 0.4% 21.9 71%
    16/1.0 252 44.8 1.00 47% 0.4% 16.1 59%
    14/1.0 244 45.3 1.10 42% 0.0% 16.3 53%
    12/0.8 464 46.5 1.50 32% 0.4% 13.1 43%
    12/0.6 450 47.6 1.40 28% 0.7% 11.5 41% <- 最优
    12/0.4 1081 45.7 1.30 35% 1.2% 11.2 40%
    10/0.6 454 46.0 1.65 28% 1.1% 10.3 35%
    12/0.2 481 45.5 1.10 40% 1.7% 10.2 42%
    12/0.0 476 43.5 1.30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
2026-10-30 tune(pd): 转向斜率 26 -> 22，只回退这一项（构建 by）
    bx 实测（vs bv 同参数 12/0.6）：
    平均速度 47.6 -> 48.4（+1.7%）
    弯道速度 45.5 -> 46.7（+2.6%）
    直道速度 51.5 -> 53.5（+3.9%）
    |e| 中位 1.40 -> 1.20
    阻尼消耗 3.7cm/s(35%) -> 1.7cm/s(13%) <- 阻尼 0.07->0.03 生效
    弯道 a_lat p90 111 -> 125 <- ALAT 85->100 生效
    翻转率 28% -> 34% （变差）
    撞限幅 27% -> 37% （变差）
    NONE 0.7% -> 1.2% （变差）
    结论：四项改动里只有"斜率 20->26"是负收益 —— 20ms 周期下放宽斜率
    等效于提高增益，又把高增益抖动带了回来。其余四项（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
2026-10-30 feat(pd): 运动学前馈（方案 C）—— 弯道稳态误差按 (1−K_ff) 下降（构建 bz）
    原理（差速驱动的精确运动学，无需调参）：
    ω = (vR − vL) / W steer = (vR − vL) / 2
    ⇒ steer = ω × W / 2 = ω × 8 （W = 16cm）
    弯道里这一份差速是"维持当前转弯"必需的、可精确计算的量，
    以前全部由 PD 的误差项提供，于是必然存在稳态误差：
    e = ω × W/2 / kp_eff
    实测验证（bx 数据，kp_eff = 12×30/v）：
    区段 ω实测 需要差速 kp_eff 理论误差 实测|e|
    直道 7°/s 1.0 6.7 0.15cm 0.25cm
    缓弯 33°/s 4.6 7.2 0.64cm 0.70cm
    中弯 6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
2026-10-30 fix(pd): 撤销错误的 ω_车 前馈，改为 θ 前馈加强 + dθ/dt 预判（构建 ca）
    【问题】bz 版把前馈写成 steer += K × ω_车 × W/2，实测严重变差：
    指标 bx(YFF=0) bz 变化
    平均速度 48.3 35.3 -27%
    |e| 中位 1.20 1.95 +63%
    弯道 |e| 1.85 2.30
    弯道速度 45.6 35.2
    |ω| 中位 55.6°/s 93.4°/s +68%
    |s| 中位 12.6 30.4 +141%
    翻转率 34% 60%
    丢线 1.1% 7.6%
    【根因】ω_车 是"车已经转多快"，不是"路径要转多少"：
    车开始左转 -> ω 变大 -> 前馈给更多左转差速 -> 车转更快 -> 发散。
    这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
    [Ble_task.c, LinePD.c, LinePD.h, Oled_task.c]
2026-10-30 fix(pd): ca 自审发现的两个 bug —— 起步拽车 + 前馈限幅过早饱和（构建 ca）
    1) 【真 bug】LinePD_Reset 没清 theta_prev / theta_rate
    进入 LINE 时 theta_rad 被清 0，但 theta_prev 还留着上一轮的值
    （可能 0.5rad）。第一拍算出
    dθ/dt = (0 − 0.5) / 0.02 = −25 rad/s
    经 LPF 0.4 后仍有 −10 rad/s，前馈 = 0.6×(−10)×8 = −48 cm/s，
    被限幅到 −12 cm/s —— 每次起步车都会被猛地拽一下。
    修复：Reset 里一并清零。
    2) 【设计缺陷】θ 前馈限幅比例 0.35 在新增益下过早饱和
    增益提到 1.60 后，各半径需要的前馈：
    R=111cm -> 4.0 cm/s ok
    R= 4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
    [LinePD.c, LinePD.h]
2026-10-30 fix(pd): 回退 θ 前馈 1.60/限幅 0.55/dθdt 0.60 —— 前馈本质是 D 项（构建 cb）
    【ca 实测 vs bx】
    指标 bx ca 变化
    平均速度 48.3 43.4 -10%
    |e| 中位 1.20 1.40
    弯道 |e| 1.85 1.95
    弯道速度 45.6 42.6
    |s| 中位 12.6 20.0 +59%
    每拍|Δs| 19.0 21.7
    翻转率 34% 40%
    振荡频率 2.5Hz 1.4Hz （频率降低 = 大振幅极限环）
    丢线 1.1% 2.2%
    【根因：θ 前馈和 LKD 是同一个物理量】
    θ = de/ds => v·θ = de/dt => gain·v·θ = gain·de/dt
    所以 θ 前馈本质就是 D 项，与 LKD 叠加后等效 D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
    [Ble_task.c, LinePD.h]
2026-10-30 tune(pd): 定稿 LKP 10 / LKD 0.6，dθ/dt 前馈保持关闭（构建 cc）
    本场次完整扫参（cb 固件，占空比 59~64% 说明电池状态一致，可比）：
    LKP/LKD 均速 直道 中弯 急弯 |e| 弯|e| 翻转 丢线
    10/0.6 46.5 49.2 49.2 45.0 1.50 1.80 32% 1.9% <- 最优
    10/0.4 46.2 49.6 46.2 42.8 1.40 2.20 33% 1.4%
    10/0.8 45.8 47.3 48.3 44.8 1.40 1.90 43% 1.6%
    12/0.6 45.1 44.7 47.3 43.9 1.30 1.60 47% 0.9%
    10/0.2 44.9 49.2 45.9 40.0 1.30 2.40 34% 5.4%
    8/0.4 44.1 48.3 46.2 38.7 1.60 2.40 22% 5.0%
    14/0.4 44.0 45.4 44.3 42.6 1.30 1.60 45% 1.3%
    改动：LINE_PD_DFLT_KP 12 -> 10（唯一改动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
2026-10-30 revert: 回退到 bx 版本（放弃 dθ/dt / ω_车 前馈实验）
    按用户要求整体回退到 bx（0a61c77），代码树与 bx 完全一致
    （git diff 0a61c77 --stat 为空）。构建标记恢复为 bx。
    撤销的 6 个提交：
    844d368 by 转向斜率 26->22
    6a86d24 bz 运动学前馈（ω_车）
    e6a161c ca 改为 θ 前馈加强 + dθ/dt
    43646f2 ca 修 Reset 缺 theta 状态 + 前馈限幅
    93c5006 cb 回退上述三项
    8ffc8d2 cc 定稿 LKP 10 / LKD 0.6
    【为什么回退】
    两条前馈路线实测都没有正收益，全部是负收益：
    bz（用实测横摆角速度 ω_车 做前馈）
    均速 48.3 -> 35.3，|ω| +68%，|s| +141%，翻转 34% -> 60%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
    [Ble_task.c, LinePD.c, LinePD.h, Oled_task.c]
2026-10-30 feat(ble): [L] 行新增停车调试字段（构建 cd）
    定稿 bx 后转向停车能力测试。原来的日志看不到任何停车过程，
    只能靠量尺子判断"停早了还是停晚了"，无法定位是识别问题还是刹车问题。
    新增四个字段（在 y 之后）：
    rp%d : race_phase 当前阶段
    0=等待(未武装) 1=巡航(等启停线) 2=接近(已识别) 3=到位
    rd%s : race_detect_cm —— 识别到启停线时的已跑里程
    ra%s : 本次已跑里程（cm）
    sp%d : 启停线脉冲宽度（拍，20ms/拍），0=本拍无脉冲
    判读方法：
    - rp 一直 1、rd 一直不变 -> 整圈没识别到启停线（查通道数/阈值/线宽）
    - rp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
    [Ble_task.c, LinePD.c, LinePD.h]
2026-10-30 fix(gray): 启停线识别改为三判据空间特征，阈值 6 -> 4（构建 ce）
    【真 bug】启停线从来没被检测到过
    原判据：active_count >= GRAY_STOP_BAR_CHANNELS(6)
    实测：启停线 5cm 宽，探头间距 11.5mm
    6 路需要 5×11.5 = 57.5mm > 50mm -> 永远达不到
    后果：stop_bar_seen 恒为 0，自动停车一直靠里程兜底，从没靠识别停过。
    【为什么不能直接降到 5】
    5 路的窗口 = 50 − 46 = 4mm，车速 55cm/s 时只有 7ms，
    小于一个采样周期（20ms），大概率整拍漏掉。
    4 路的窗口 = 50 − 34.5 = 15.5mm = 28ms，能稳定抓到 1~2 拍。
    【为什么不能直接降到 4（原注释的担心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
    [Ble_task.c, Gray.c, Gray.h]
2026-10-30 fix(pd): 去掉启停线判据里的 corner_dir 门槛（构建 cf）
    【实测定位】ce 版跑了两段，启停线仍然从未被确认：
    16:52:47 run1: ra 最大 190cm，rp {0,1}，sp {0,1,2}
    16:53:10 run2: ra 最大 2197cm（跑了 5 圈多），rp {0,1}，sp {1,2}，rd 恒 0
    sp 有值说明 Gray 的三判据【确实检测到了脉冲】，
    但 LinePD 全部否决了。统计 run2 的 corner_dir：
    cd=+1 : 169 次（83%）
    cd= 0 : 4 次
    cd=-1 : 31 次
    即 pd->corner_dir 有 83% 的时间被锁存，而启停线判据第一条就是
    "pd->corner_dir == 0"，于是 83% 的检测被挡掉，rd 永远是 0。
    【为什么 corner_dir 一直被锁存】
    弧线赛道上 SIDE_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
    [Ble_task.c, LinePD.c]
2026-10-30 feat: I2C DMA 采样 + 10ms 采样率 + 终点接近区降速武装（构建 cg）
    三个改动一起做，目标是解决"启停线检测靠运气"的问题。
    ============================================================
    【1】I2C1 改用 DMA 读（Gray.c）
    ============================================================
    原来 HAL_I2C_Mem_Read 阻塞 1.2ms/次（400kHz，16 字节），CPU 全空转。
    提到 10ms 采样后占空比 12%，5ms 就是 24%，控制任务会被拖住。
    改法：HAL_I2C_Mem_Read_DMA + 二元信号量
    - HAL_I2C_MemRxCpltCallback 里 xSemaphoreGiveFromISR 唤醒等待方
    - 传输期间任务挂起、CPU 让给别的任务
    - 超时：清信号量 -> HAL_I2C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
    [Ble_task.c, Control_task.c, Gray.c, Gray.h, LinePD.c, LinePD.h, main.c]
2026-10-30 fix(ctrl): 主循环 20ms -> 5ms，灰度采样真正提到 5ms（构建 ch）
    【cg 的 10ms 采样是假的】
    cg 里加了个 10ms 子节拍做灰度采样，但主循环是
    vTaskDelayUntil(&last_wake, pdMS_TO_TICKS(SPEED_PID_PERIOD_MS)); // 20ms
    任务每 20ms 才醒一次，子节拍判断 (now-last_gray)>=10ms 在每次醒来时
    必然成立 —— 实际仍然是 20ms 采一次，改了等于没改。
    【修复】
    1) 主循环节拍 CTRL_LOOP_PERIOD_MS = 5ms
    2) 各功能按自己的 elapsed 判断，互不牵制：
    灰度采样 5ms （GRAY_SAMPLE_PERIOD_MS 10 -> 5）
    速度环 20ms （新增 last_speed 门控，LINE 与 SPD 两个 case 都要）
    外环 PD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
    [Ble_task.c, Control_task.c, Gray.h]
2026-10-30 revert(gray,ctrl): 回退 DMA 读与 5ms 主循环 —— 刷 ch 后 OLED 不亮（构建 ci）
    【现象】刷 ch 后 OLED 屏幕完全不亮。
    【已排除】
    1) 堆耗尽：日志里 [M] heap4976，加一个信号量(~80B) 不可能耗尽 10240 的堆
    2) 栈溢出：[M] stkC704 / stkO1136 / stkB480，都有余量；
    [L] 行缓冲 160->192 只多占 32 字节
    3) DMA 通道冲突：ioc 里 I2C1_RX=DMA1_Channel7、I2C2_TX=DMA1_Channel4，
    两条独立通道；NVIC 里 I2C1_EV/ER 和 DMA1_Ch7 都已使能
    4) HAL_I2C_ErrorCallback 结构正确（I2C2 分支保持原样）
    【为什么先整体回退】
    排查只能在硬件上做，先把"能亮屏"的状态还给用户：
    - Gray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
    [Ble_task.c, Control_task.c, Gray.c, Gray.h, main.c]
2026-10-30 fix(gray): DMA 中断里彻底移除 FreeRTOS API，改用异步双缓冲（构建 cj）
    【死机原因（用户指出，项目里早有记录）】
    我在 HAL_I2C_MemRxCpltCallback 里写了
    xSemaphoreGiveFromISR(s_i2c_done, &woken);
    portYIELD_FROM_ISR(woken);
    本项目的 I2C/DMA 中断里这么写会触发 configASSERT 直接死机。
    Oled.h 第 100 行早就记着这件事：
    "中断优先级必须 >= configMAX_SYSCALL_INTERRUPT_PRIORITY，
    否则中断里调 xSemaphoreGiveFromISR 会触发 configASSERT 死机"
    并且 OLED_USE_RTOS_SEM 最后被改成 0（= 不用 RTOS API）才稳定下来。
    我没注意这条既有教训，在灰度 DMA 回调里重犯了一次。
    【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
    [Ble_task.c, Control_task.c, Gray.c, Gray.h, main.c]
2026-10-30 fix(gray): 所有模式都消费采样帧，恢复 SPD/STOP 下的传感器可见性（构建 ck）
    cj 刷上去已经不死了，但日志里 i2c 一直是 0/0（总读数 0），
    [G] 输出也全是 S=00 P=0.0mm e=0/0 —— 传感器数据根本没更新。
    原因：cg 那次把非循迹模式下的 Gray_Update 删掉了（理由是"10ms 节拍已经
    读过总线，不要重复读"）。但当时 Gray_Update 还带 I2C 事务；
    现在改成 DMA 异步后，Gray_Update 里【已经没有 I2C】了，
    只是解析一块缓冲，非循迹模式调用它不再有任何总线代价。
    影响：SPD/STOP 模式下 OLED 传感器调试页和 [G] 串口输出全是 0，
    没法在不上赛道的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
    [Ble_task.c, Control_task.c]
2026-10-30 fix(race): 启停线判据改用"压线当时"的位置 + 接近段超时兜底（构建 cl）
    【ck 数据分析：为什么还是停不下来】
    ck 跑了 812 个样本，关键统计：
    i2c0/36222 -> DMA 采样完全正常，0 次失败（异步改造成功）
    rp: 758×rp0 85×rp1 7×rp2 -> 识别成功过 7 次，但从未到 rp3
    sp: 522×sp2 -> 脉冲检测工作正常
    rz: 850×rz0 -> 接近区从未激活！
    三个问题：
    1) 【配置】rz 恒为 0 -> LAP 还在自适应档（<50）
    接近区只在周长模式（LAP>=50）才生效。没设周长 -> 不降速、不按里程武装，
    检测完全靠图案碰运气。这是"停不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
    [Ble_task.c, Gray.c, Gray.h, LinePD.c, LinePD.h]
2026-10-30 feat(race): 加启停线脉冲计数器 bn / 压线位置 bp，用于验证 55cm/s 下的可检测性（构建 cm）
    用户想先不设 LAP，纯看"传感器 5ms 采样 + 三判据"在 55cm/s 下到底能不能
    认出启停线。但现有字段做不到这件事：
    sp / sb 是【永久锁存】的（没有任何地方清零），脉冲发生后一直保持最后一个值，
    既数不出"一共发生了几次"，也分不清哪次是真的。
    新增两个字段（[L] 行末尾）：
    bn%d : stop_bar_count —— 累计检测到多少次脉冲（只增不清，可直接数次数）
    bp%s : stop_bar_pos_mm/10 —— 该次脉冲发生【当时】的横向位置（cm）
    判读：
    跑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
2026-10-30 fix(gray): 5ms 采样下所有"按拍"常量 ×4 换算 —— 这才是变抖/认不到启停线的根因（构建 cn）
    【用户反馈】提高采样频率后：① 车更抖了 ② 反而更认不到启停线
    【根因：同一个错误 —— 按拍常量没随采样周期换算】
    采样周期 20ms -> 5ms 后，同样的"拍数"只代表 1/4 的时间。
    Gray.h 里这几个常量全是按 20ms 调的，没跟着改：
    1) GRAY_STOP_BAR_PULSE_MAX = 3（脉冲宽度上限）
    20ms 时代实测启停线脉冲 1~2 拍，取 3 正好。
    5ms 采样下同一条 5cm 横线会持续：
    71.5cm/s -> 21.7ms -> 4.3 拍
    55cm/s -> 28ms -> 5.6 拍
    42cm/s -> 37ms -> 7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
    [Ble_task.c, Gray.h]
2026-10-30 fix(race): 加直道闸门（陀螺 |ω|<45°/s）+ 修 rd/bp 共用缓冲的 bug（构建 co）
    【cn 数据分析：误检不是随机的，分两簇】
    bn 增长的 16 次里，位置和横摆角速度分得很开：
    真启停线簇：ra ≈ 290~305cm，|ω| = 4~24°/s，sc=LINE
    弯道误检簇：ra ≈ 60~170cm，|ω| = 26~90°/s
    用户反馈"经常在拐弯时误触发"与数据完全一致。
    【为什么三判据挡不住弯道】
    弯道里线是【斜着】扫过阵列的，中间 4~5 路会同时黑、两边留白，
    空间特征和横切启停线长得一样。要区分必须用【运动状态】：
    启停线在直道中间，过线时车基本不转；弯道误检一定在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
    [Ble_task.c, LinePD.c, LinePD.h]
2026-10-30 fix(ctrl,race): 陀螺仪门控回 20ms（消除 5ms 循环里的阻塞 I2C2）+ 接近区改为按周长比例（构建 cp）
    【用户两个问题，都成立】
    问题一：控制任务在 5ms 循环里做了阻塞 I2C，反应不过来
    主循环从 20ms 改 5ms 时，MPU6050_Update() 没有加门控，
    从"20ms 读一次"变成"5ms 读一次"。它内部是【阻塞式 I2C2 读】(~0.35ms)，
    而 I2C2 上还挂着 OLED 的 DMA 整屏传输（一页 129 字节约 3ms）。
    两者抢同一条总线时，控制任务可能被拖住好几毫秒 ——
    正好发生在"识别启停线"这种需要及时响应的时刻。
    -> 新增 last_mpu 门控，回到 20ms（航向积分本来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
    [Ble_task.c, Control_task.c, LinePD.c, LinePD.h]
2026-10-30 feat(race,ui): 直道闸门放宽到 120°/s（适配椭圆赛道）+ 循迹时冻结 OLED 刷新（构建 cq）
    【1. 直道闸门 45 -> 120°/s】
    用户指出：椭圆赛道的终点在 R=50cm 弯道末端。按 ω = v/R×57.3：
    R=50cm @42cm/s -> 48°/s
    R=50cm @55cm/s -> 63°/s
    45°/s 的闸门会把【真启停线】挡在外面 —— 这是上一版(co)的致命缺陷。
    放宽到 120°/s：覆盖到 R≥20cm @42cm/s，急弯（R<20cm）里的误检仍被挡。
    终点在更急的弯里就再放宽或直接关掉，此时完全靠接近区(LAP×0.8)过滤。
    【2. 循迹模式冻结 OLED 刷新】
    OLED 和 MPU6050 共用 I2C2。整屏一页 129 字节 @400kHz 约 3ms，
    而 MP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
2026-10-30 fix(race): LAP 参数加可见性诊断，步长 10 -> 50（构建 cr）
    【现象】用户把 LAP 调到 320 后，车反而在终点前就停了。
    【数据分析：LAP 根本没进到 LinePD】
    cq 日志 825 个样本里 rz 恒为 0 —— 接近区一次都没激活。
    而 rp 有 rp1(120) / rp2(10)，说明阶段机本身是跑的。
    阶段 0->1 的代码是：
    if (traveled >= arm_cm) {
    pd->race_phase = 1U;
    if (pd->race_lap_cm > 0.0f) pd->race_zone = 1U; // <- 只有这里置 rz
    }
    rz 恒 0 只能说明 race_lap_cm == 0，即 LinePD 收到的是【自适应档】，
    走的是 arm_cm = LINE_RACE_ARM_MIN_CM(50cm) 这条分支。
    换句话说：LAP=320 没有写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
    [Ble_task.c, Control_task.c, Oled_task.c]
2026-10-30 fix(race): LAP 大检查 —— 修 4 个真 bug，LAP 不再是"到里程就停"（构建 cs）
    【用户判断正确：LAP 确实变成了"到达里程就停下"】
    原代码的兜底是：
    if (traveled >= (pd->race_lap_cm - LINE_RACE_FALLBACK_CM)) // 2cm
    pd->race_phase = 3U; // 直接停车
    也就是说跑满 LAP-2cm 就停，【跟有没有识别到启停线无关】。
    而且它比真启停线早 2cm 触发，表现就是"还没到终点就停了"。
    【大检查结果：4 个 bug】
    BUG 1（用户指出的）兜底抢了主停车
    兜底写成 LAP − 2cm，等于把"识别"架空，变成纯里程停车。
    -> 改为 LAP + 30cm：只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
    [Ble_task.c, LinePD.c, LinePD.h]
2026-10-30 refactor(race): 删除所有按里程停车的兜底 —— 停车只能由启停线识别触发（构建 ct）
    用户明确要求：不需要过冲保护。
    删掉三处"按里程停车"：
    1) 周长模式 traveled >= LAP - 2cm （原来就抢了主停车）
    2) 学习周长 traveled >= 学习值 - 2cm （LINE_RACE_LEARN_LAP=0，本就是死代码）
    3) 自适应 traveled >= LINE_RACE_MAX_CM(2000cm)
    它们共同的问题：分不清"识别失败"和"识别成功但晚一点"，
    结果不管有没有压到启停线，跑到里程就停 —— 把识别逻辑架空，
    表现就是"还没到终点就停了"。
    删掉后 race_phase=3 只剩两个触发点，都发生在【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
    [Ble_task.c, LinePD.c, LinePD.h]
2026-10-30 fix(race): 修复 ct 版"完全不停车" —— 脉冲标志被提前清零后仍在判断旧值（构建 cu）
    【ct 实测数据（1388 样本）】
    rz=1 出现 456 次 -> 接近区正常工作，LAP=310 确实生效
    bn 涨到 8 -> 脉冲检测正常
    每次 bn 增长的 bp=0.0 -> 压线位置完美（正中间）
    bn 增长时的 ra = 295.5 / 611.6 / 915.4 / 1226.2
    -> 间隔 305~316cm，就是一圈，位置完全正确
    但 rp 从来没到过 2 -> 识别分支一次都没执行
    【根因：我上一个提交(cs)引入的自伤】
    cs 里为了修"脉冲标志在 phase 0/2 不清零"，在 race 块开头加了：
    uint8_t p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
    [Ble_task.c, LinePD.c]
2026-10-30 fix(race): 识别窗口改为按圈折回 —— 修"第一圈没停住就永远不停"（构建 cv）
    【用户判断正确：这是代码 bug，不是识别不到】
    cu 实测（1241 样本）关键证据：
    bn 增长时的 ra 与 bp：
    302.7 bp= 0.0 第1圈 -> rp=2 成功识别
    779.4 bp=-1.1 第2.6圈 -> 误检
    920.6 bp= 1.1 第3圈 -> rp 停在 1，没识别
    1233.1 bp= 1.1 第4圈 -> rp 停在 1，没识别
    第 3、4 圈的 bp=±1.1 和真启停线完全一样（真线在 302.7 时 bp=0.0~1.1），
    是货真价实的压线，却被拒掉了。
    【根因：里程窗口只覆盖第一圈】
    cs 加的窗口是直接比绝对值：
    diff = traveled - (LAP -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
    [Ble_task.c, LinePD.c, LinePD.h]
2026-10-30 docs: 新增 2026-10-30 全量代码巡检报告（基线 cv / 060533d）
    【检查范围】
    USER/ 任务层 3 个 + Drivers/BSD 驱动 10 个 + Core/ 启动与中断
    + FreeRTOSConfig + tools/ 工具链 + 构建配置，共约 1.2 万行自研代码。
    【方法】
    逐文件静态审查、Debug/Release 全量编译（额外开 -Wextra -Wshadow
    -Wformat=2 复核，零告警）、真实日志回归
    （logs/serial_20261030_091043.log，22.8 万行）、内存与串口带宽实测。
    【结论：P1 4 / P2 7 / P3 11】
    P1-1 BleTask_SendTag() 把 2/3 压成 0/1 —— [RACE] det/stop 永不打印，
    且每次自动停车伪造 2 条 [T] OK，污染按 [T] 切段的统计
    P1-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
2026-10-30 fix: 修复外部巡检报告确认的 4 个真 bug（构建 cw）
    对照 docs/代码巡检报告-2026-10-30.md 逐条核验，确认成立并修复：
    【P1-1 成立】BleTask_SendTag() 把 2/3 压成 1
    uint8_t item = (ok != 0U) ? 1U : 0U;
    控制任务用 SendTag(2) 表示"识别到启停线"、SendTag(3) 表示"到位"，
    被压成 1 之后消费端永远走不到 tag==2/3 分支：
    - [RACE] det / [RACE] stop 从来没打印过
    - 每次自动停车反而伪造 2 条 [T] OK，把跑圈统计污染
    -> 改为原样传递 0/1/2/3。
    【P1-3 成立】灰度掉线检测彻底失效（DMA 改造引入的回归）
    cg 把读改成 DMA 异步之后，Gray_ReadRegisters 不再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
    [Ble_task.c, Gray.c, Gray.h, main.c]
2026-10-30 fix: 修复巡检报告剩余全部条目（构建 cx）
    接 cw 继续处理报告里尚未修复的项。
    【P1-2 BLE_STATE(PA1) 改成输入 + 下拉】
    原来配成 GPIO_MODE_OUTPUT_PP 并拉低：
    - HAL_GPIO_ReadPin 读到的是自己的输出锁存器 -> BLE_IsConnected() 恒为 0
    - MCU 输出低与模块输出对顶，长期可能损伤引脚
    改为 GPIO_MODE_INPUT + GPIO_PULLDOWN：
    模块未接 -> 下拉为低 -> 未连接（正确）
    模块连接后输出高 -> 读到高 -> 已连接
    同步更新 .ioc（PA1.GPIO_Mode/PuPd），避免 CubeMX 重新生成时改回去。
    【P2-5 控制环不再直接抢 USART2】
    新增控制事件队列：BleTask_SendEvent(co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
    [Ble_task.c, Ble_task.h, Control_task.c, LinePD.c, linefllowing_car.ioc, main.c]
2026-10-30 feat(race): 接近段位移改用"编码器 + 陀螺打滑检测"融合（构建 cy）
    用户要求用陀螺融合，因为觉得编码器不够准。
    【先说清楚物理边界】
    陀螺仪测的是角速度，【测不出前进距离】。所以这里不是"用陀螺算 17cm"，
    而是用陀螺去验证编码器可不可信，再决定信谁。真正能用上的融合有两层：
    1) 打滑检测（主要作用）
    差速底盘运动学：ω_enc = (v右 − v左) / 轮距
    正常行驶时它必须等于陀螺测到的横摆角速度 ω_gyro。
    两者偏差 > LINE_RACE_SLIP_RAD_S(1.2rad/s ≈ 69°/s)
    -> 判定某侧轮打滑或编码器丢计数 -> 编码器位移权重降到 0.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
2026-10-30 revert(race): 移除陀螺融合，刹车余量 2.0 -> 1.0cm（构建 cz）
    实车验证结论：接近段只有 1.25 秒 / 12cm/s，编码器表现足够，
    融合方案没必要，反而多一层可能出错的逻辑。按用户要求回退。
    【移除】
    - LinePD 里的编码器/陀螺打滑检测融合块（resid 判定、权重混合）
    - 字段 race_fuse_cm / race_last_trav / race_last_tick / race_slip
    - 参数 LINE_RACE_SLIP_RAD_S / LINE_RACE_SLIP_WEIGHT
    - [L] 行的 fu / sl 两个调试字段
    接近段恢复成简单写法：
    float approach = traveled - pd->race_detect_cm;
    【调整】
    LINE_RACE_BRAKE_MARGIN_CM 2.0 -> 1.0
    改前：走 15cm 就停（离终点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
    [Ble_task.c, LinePD.c, LinePD.h]
2026-10-30 tune(race): 刹车余量 1.0 -> 3.0cm（构建 da）
    实车测试后调整：1cm 停得太晚，改成 3cm 提前一点。
    走 14cm 停（离终点还差 3cm）
    相比 1cm 版提前 2cm
    构建：Release FLASH 53 204 B (81.2%) / RAM 16 912 B (82.6%)；构建标记 cz -> da
    固件已导出：firmware/da-margin3.hex / .bin
    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
2026-10-30 fix(ctrl): 速度环与测速同拍 —— 修"车抖得厉害"（构建 db）
    【现象】da 版车抖得厉害。
    【根因】cx 版（P2-8 修复）只把 Encoder_UpdateSpeed 门控到 20ms，
    却把 Speed_PID_Update 从门控里挪了出来、留在 5ms 节拍里。
    SpeedPID.c 里的 dt 是编译期常量：
    #define SPEED_PID_DT_SEC (SPEED_PID_PERIOD_MS / 1000.0f) // 20ms
    不是实测时间。所以 PID 每 5ms 跑一次等于：
    - 积分项每秒累积 4 倍（等效 Ki × 4）-> 振荡
    - 而测速 20ms 才更新，中间 3 拍拿的是同一个旧误差，
    积分器对着同一个误差反复累加 -> 纯积分饱和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
    [Ble_task.c, Control_task.c]
2026-10-30 docs: 补记巡检报告修复状态 + README 更新（构建 db）
    按巡检报告逐条核验后的结论与修复记录：
    【成立并已修（P1 4/4、P2 7/7、P3 7 项）】
    P1-1 SendTag 压成 0/1 cw
    P1-2 BLE_STATE 推挽输出 cx
    P1-3 fail_count 从不自增 cw
    P2-5 控制环抢 USART2 cx
    P2-7 自检函数失效 cx
    P2-8 测速窗口 5ms cx/db
    P2-9 MPU 重试 HAL_Delay cx
    P2-10 UART 长度越界 cw
    P2-11 Print 截断越界读 cw
    P3-18 删 USB（省 728B RAM） cx
    P3-20 lrn 恒为 0 cx
    【核验后不成立】
    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
2026-10-30 fix(ctrl,race): 控制环改用 20ms 平均位置 + 关闭陀螺闸门（构建 dc）
    【现象】只走 100cm 直线也抖得厉害，而且停不下车。
    【日志证据（db 版，LAP=110）】
    1) 转向在 ±30 之间来回打，而 |e| 一直 < 1.5cm：
    e0.7 s-15.0
    e1.3 s+34.3
    e0.1 s-13.0
    e0.2 s+6.0
    2) 偏航角 y 每 60ms 涨 18~28°，即 ω ≈ 300~460°/s —— 车在打转
    3) bn 一直涨、bp 正常（0.0~1.2）、折回差也在窗口内，
    但 rp 从不变成 2（例如 ra=93.0 折回 0.0、ra=99.7 折回 +6.7 都没认）
    【根因 1：5ms 采样把控制环的微分项噪声放大了 4 倍】
    采样提到 5ms 是为了抓启停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
    [Ble_task.c, Gray.c, Gray.h, LinePD.c, LinePD.h]
2026-10-30 diag(race): [L] 增加 sn/rj 计数器，定位脉冲被哪道关卡拒掉（构建 dd）
    db/dc 日志里出现：bn 增长、bp 正常（±1.1）、rz=1、折回差在窗口内，
    但 rp 始终停在 1。说明脉冲被看到了却被某一关拒掉，或者压根没传到 LinePD。
    两个计数器：
    sn%d = race_seen —— 脉冲被 LinePD 取走的次数（应等于 bn 的增量）
    rj%d = race_reject —— 取走了但被关卡拒掉的次数
    sn 跟着 bn 涨、rj 也涨 -> 被关卡拒（看 ra/bp 定位哪一关）
    sn 不涨而 bn 涨 -> 脉冲标志没传到 LinePD（同步问题）
    构建标记 dc -> dd
    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
    [Ble_task.c, LinePD.c, LinePD.h]
2026-10-30 fix(race): 终点接近区内禁止直道冲刺（构建 de）
    用户观察：车在直道上正处冲刺阶段，到点被限速后"慢顿一下"，然后又跑出去。
    【代码确认了这一点】
    冲刺在速度规划的【前面】乘进 slow_factor：
    speed_boost 在直道上持续累积到 +30%
    slow_factor *= (1.0f + speed_boost) <- 先乘
    target_speed = base_speed * slow_factor <- 55 × 1.3 = 71.5
    然后才轮到接近区限速 target = 42 <- 硬砍 40%
    而且冲刺逻辑在直道上会一直把 speed_boost 顶在最大值，
    和接近区限速形成对抗 —— 实测同一段 ra≈91~92 上，速度在 54.8~61.0 之间飘。
    【修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
    [Ble_task.c, LinePD.c]
2026-10-30 tune(oled): LAP 步长 50 -> 30cm（构建 df）
    用户要求每按一次涨 30。
    从默认 10 起的按键序列：
    10 -> 40 -> 70 -> 100 -> 130 -> 160 -> 190 -> 220 -> 250 -> 280 -> 310
    100cm 直线测试：按 3 次落在 100（正好）
    310cm 赛道：按 10 次落在 310（原来步长 50 是 6 次）
    构建：Release FLASH 53 280 B (81.3%) / RAM 16 944 B (82.7%)；构建标记 de -> df
    固件已导出：firmware/df-lap30.hex / .bin
    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
2026-10-30 fix(ctrl): 进入循迹时清灰度位置历史 —— 修"有时候一开始就震荡"（构建 dg）
    用户反馈：现在停车很成功，但有时一开始就震荡得厉害，有时又非常平直。
    这种"看运气"的差异通常来自没被复位的状态。
    【根因】
    dc 版为了解决 5ms 采样让微分项噪声放大 4 倍，在 Gray 里加了
    position_cm_ctrl = 最近 4 拍位置的滑动平均。但那 4 个历史值只在
    Gray_Init（上电一次）里清零，之后一直带着上一圈的残留。
    于是每次进入循迹模式后的前 4 拍（20ms）：
    新位置的样本还没填满历史 -> 平均值被上一圈的旧位置严重污染
    如果上次停车时线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
    [Ble_task.c, Control_task.c, Gray.c, Gray.h, LinePD.c]
2026-10-30 feat(ctrl): 起步软限速 700ms / 35cm/s —— 治"斜着放车就震荡"（构建 dh）
    用户观察：现在放平能平滑跑，斜着放一定震荡，怀疑是不是冲刺太快。
    【数据核验：不是冲刺】
    dg 日志里 21 次开跑，起手平均速度 32~44cm/s，全部【低于】base 55。
    冲刺要连续 10 拍（200ms）误差小才累积，起手误差大时 speed_boost = 0。
    所以起手震荡和冲刺无关。
    【真正的原因：PD 看不到"车与线的夹角"】
    斜着放车时，起手瞬间横向偏移还很小（e≈0），但夹角已经存在：
    - P 项只认偏移 -> 夹角给不出修正
    - 微分项本该感知"偏移在快速变化"，但起手没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
    [Ble_task.c, LinePD.c, LinePD.h]
2026-10-30 fix(ctrl): 微分窗口 20ms -> 60ms，压住 D 项对位置噪声的 30 倍放大（构建 di）
    用户判断正确：这是 PD 的问题，具体是 D 项。
    【证据（dh 日志）】
    e0.8 -> s-16.9 正误差给负转向，符号都反了
    e1.0 -> s+18.7
    e-1.0 -> s-18.5
    误差一直在 ±1.2cm 内，转向却在 ±33 之间摆。P 项不可能产生这个，
    只有 D 项在主导，而它的符号来自位置噪声。
    【放大倍数】
    D = kd × Δe / dt = 0.6 × Δe / 0.02 = 30 × Δe
    灰度质心在直线上本来就有约 1cm 抖动
    -> D 输出 30，差速限幅才 35 -> 只要抖 1.2cm 就打满
    【修复：微分改成跨 3 拍（60ms）】
    derivative = (error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
    [Ble_task.c, LinePD.c, LinePD.h]
2026-10-30 revert(ctrl): 撤销起步软限速与微分窗口改动，回到 dg 的 PD 参数（构建 dj）
    实车验证结论：
    1) 微分窗口 20ms -> 60ms：效果不如不加
    2) 改 LKD 也没有改善
    3) 起步软限速同样没解决斜着放车的问题
    结论：斜着放车震荡是"PD 只看到横向偏移、看不到车与线夹角"这个
    结构性限制，靠调 D 项/限速都治不了。发车时把车放正是合理且必要的
    操作要求，不再为它增加控制复杂度。
    【撤销】
    5873ee9 微分窗口 3 拍（err_hist 环形缓冲、LINE_D_WINDOW_TICKS）
    0b0e699 起步软限速（run_ticks、LINE_START_SOFT_*）
    两条都整体 revert，代码与 847e88b(dg)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
    [Ble_task.c, LinePD.c, LinePD.h]
2026-10-30 docs(readme): 补发车流程与注意事项（6.5 节）+ 矩形赛道待验证项
    收工整理。把 2026-10-30 一整轮调参收敛后的操作知识固化进 README：
    【新增 6.5 节 发车流程与注意事项】
    6.5.1 发车前必做四件事（放正 / 对准起跑线 / 设 LAP / 电池）
    6.5.2 操作序列（OLED 按键流程 + 循迹期间冻结刷新 + 急停）
    6.5.3 跑完看什么（[L] 行字段表 + "识别到却不停"的三段判读法）
    6.5.4 停车位置调法（唯一要调的 LINE_RACE_BRAKE_MARGIN_CM）
    6.5.5 换赛道后要重新确认的三件事
    【第 7 节新增"矩形赛道待验证"】
    当前参数全是在弧线+直角混合赛道上调的，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
2026-10-30 feat(oled): 刹车余量做成可按键调节的参数 MARG（步长 0.5cm，构建 dk）
    用户要求：KEY 可以调刹车余量，按一次增加 0.5。
    【实现】
    1) Line_PD_t 新增 race_brake_margin 字段（默认 LINE_RACE_BRAKE_MARGIN_CM = 3.0）
    停车判定从编译期常量改为读这个字段：
    approach >= (17 - pd->race_brake_margin)
    2) 新增 LinePD_SetRaceBrakeMargin()：夹在 [0, 17] 之间
    （17 以上会让"一识别就停"，车停在终点前很远）
    3) OLED 参数表新增第 14 项 MARG，步长 0.5、范围 0~17，实时生效
    不需要重进循迹模式
    【按键序列】LAP 之后翻一页就是 MARG：
    0.0 -> 0.5 -> 1.0 -> ..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
2026-10-30 fix(ble): [RACE] det 的里程打印恒为 0（构建 dl）
    race_detect_cm 里存的已经是相对起点的里程（LinePD 赋的是 traveled），
    打印时又减了一次 race_start_cm，结果日志里永远是 d0，看不出识别点在
    哪个里程 —— 排查停车精度时完全没法用。
    改成直接打印 race_detect_cm，并用 %.0f（原来用 %u 转整数会丢小数）。
    构建标记 dk -> dl
    [Ble_task.c]
2026-10-30 feat(ble): 加 BLE_PERIODIC_LOG_ENABLE 开关，默认静默（构建 dm）
    用户问：定版时能不能关掉 BLE 任务，会不会影响控制程序。
    【结论：能关，且不影响控制。但建议只静默，不关任务】
    控制环对 BLE 的所有调用都是非阻塞的：
    BleTask_SendTag() -> xQueueSend(..., 0U)
    BleTask_SendEvent() -> xQueueSend(..., 0U)
    队列不存在或满了都立刻返回 0，控制环不会等。
    BLE 任务优先级 2 < 控制任务 3，永远不会抢占控制环。
    所以"关任务"和"静默"对控制律完全等价。
    但一旦关掉任务，比赛现场出问题就彻底没有日志可查。
    所以做成开关，默认静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
    [Ble_task.c, Ble_task.h]
2026-10-30 fix(gpio): BLE_RX(PA3) 改上拉，避免拔掉蓝牙模块后噪声误触发急停（构建 dn）
    用户要在比赛时拔掉蓝牙模块（避免被误认为背后遥控），问有没有影响。
    【查到一处真实风险】
    Core/Src/stm32f1xx_hal_msp.c 里 USART2 的 RX 配置是：
    GPIO_InitStruct.Pull = GPIO_NOPULL; // 浮空输入
    拔掉模块后 PA3 悬空 -> 拾取噪声 -> 随机起始位 -> 收到乱码字节。
    而 Ble_task 的命令处理是【无条件】解析的，'X'/'S'/'Q' 都是急停，
    可能在跑车中途被噪声触发急停 —— 这在比赛里是致命的。
    -> 改成 GPIO_PULLUP。空闲电平为高，噪声要凑出"起始位 + 8 数据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
    [Ble_task.c, linefllowing_car.ioc]
2026-10-30 docs(readme): 补比赛配置（静默模式 + 可拔蓝牙 + MARG 现场调）
    构建 dn 的定版配置说明。
2026-10-31 docs: README 整理——去机构标识、加目录、更新构建占用、补分支说明
2026-10-31 docs: README 去机构标识并指向 simple 分支（公开前整理）
2026-10-31 chore: 添加 MIT 许可证
    - LICENSE: MIT, Copyright (c) 2026 LUgABeEEE
    - README: 许可证徽章 + 许可证小节（注明 HAL/CMSIS/FreeRTOS 的第三方归属）
    - README 目录补「许可证」入口
2026-10-31 docs: 新增上手指南（编译/烧录/串口认版本/自检/按键/调参顺序）
    - docs/上手.md: 30 分钟走完的完整路径，10 节，含常见问题速查表
    - README: 顶部指路 + 目录入口
2026-11-08 ci: bump checkout/setup-node to v7 (Node 24 runtime) (#1)
    v4 actions run on Node 20, which GitHub forces onto Node 24 and warns about on
    every job. v7 is the current major.
